Arttech3d/Hormiga/KiCad/Tarjetas/DISEÑO DE PLACA ESP32-S3/S4345803eb856426b9bef19e153e23c18G.webp

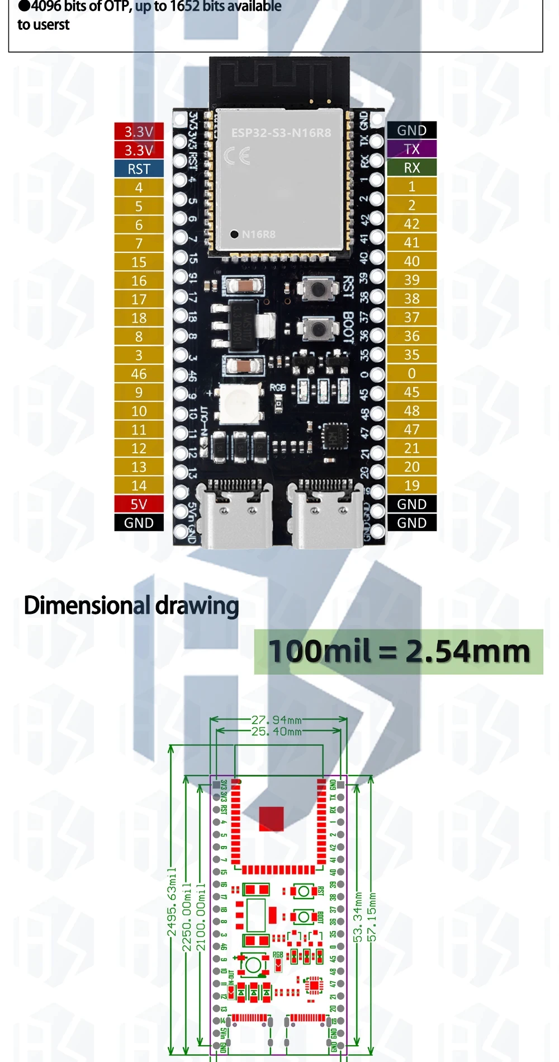
KiCad/Tarjetas/DISEÑO DE PLACA ESP32-S3/S4345803eb856426b9bef19e153e23c18G.webp
