Arttech3d/Hormiga/Material/Datasheet/ESP32-S3-DevKitC-1-Pin-Layout-1024x459.png

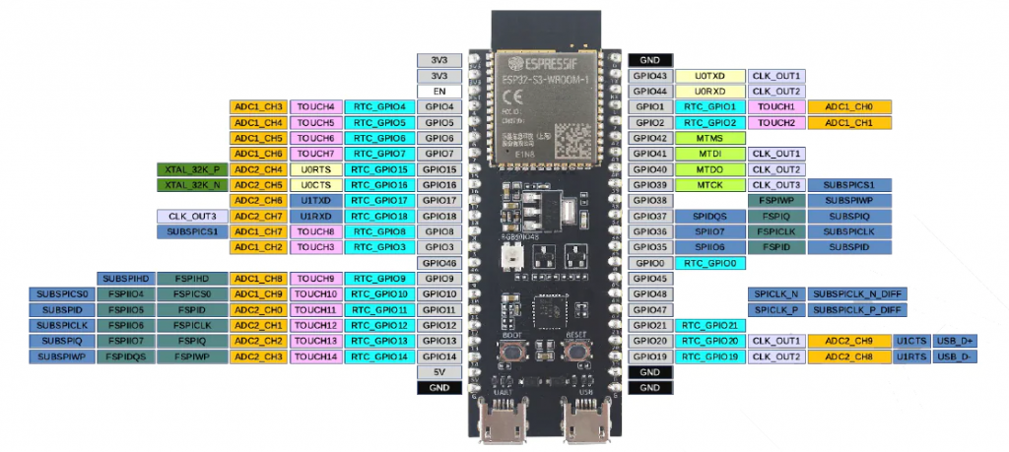
Material/Datasheet/ESP32-S3-DevKitC-1-Pin-Layout-1024x459.png
