Arttech3d/Hormiga/KiCad/Ant ESP32-S3/Fusion360/PCB v1.dxf

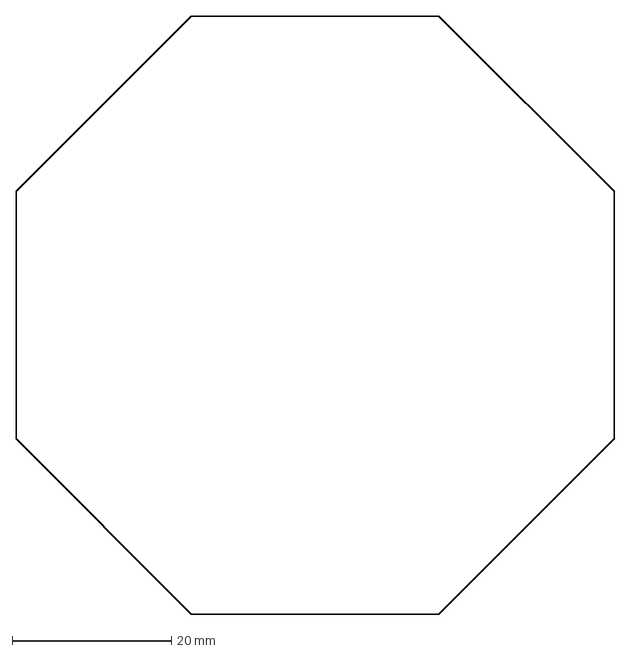
[picture p9: CAD file, 2025-12-20]
KiCad/Ant ESP32-S3/Fusion360/PCB v1.dxf
75.0 x 75.0 mm
