Arttech3d/Hormiga/Modelos 3D para esp8266 y Raspberry pi pico/STL/encoder_shaft.stl

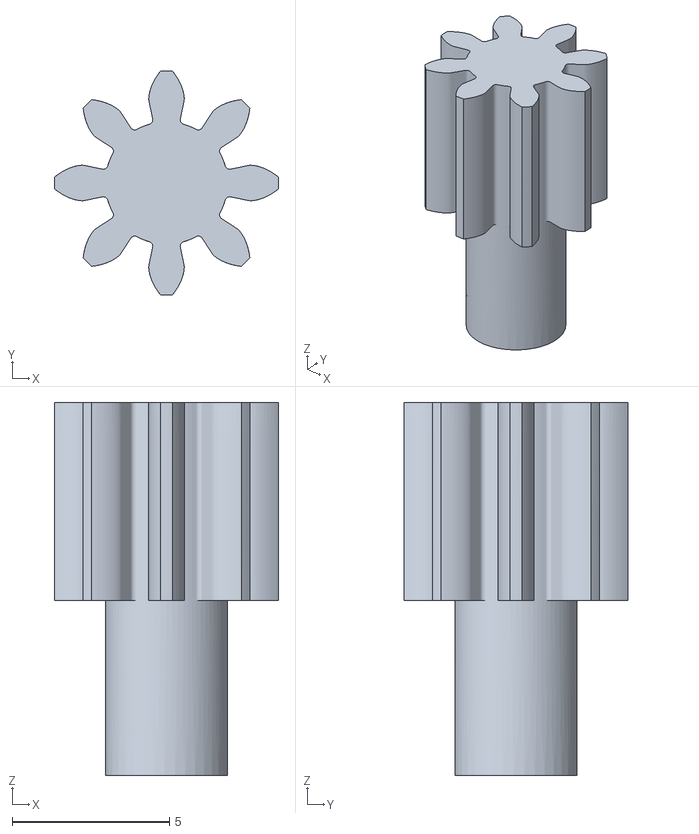
[picture p10: CAD file, 2025-12-20]
Modelos 3D para esp8266 y Raspberry pi pico/STL/encoder_shaft.stl
7.12 x 7.13 x 11.9
