Arttech3d/Hormiga/Modelos 3D para esp8266 y Raspberry pi pico/STL/cover.stl

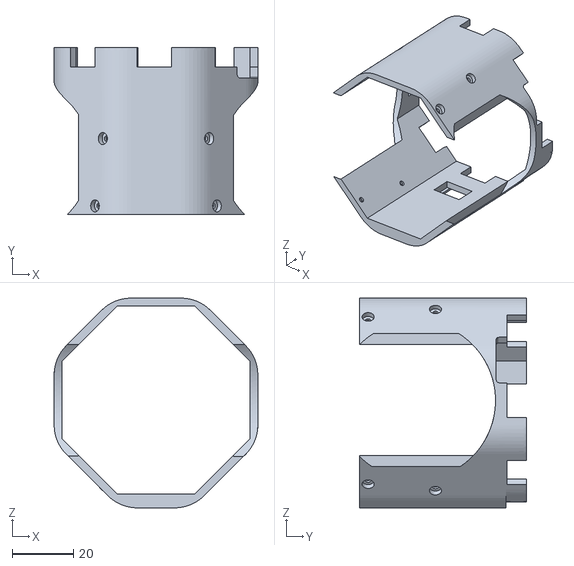
[picture p11: CAD file, 2025-12-20]
Modelos 3D para esp8266 y Raspberry pi pico/STL/cover.stl
66.7 x 54.6 x 68.6
