Arttech3d/Hormiga/Modelos 3D para esp8266 y Raspberry pi pico/STL/wheel (2H).stl

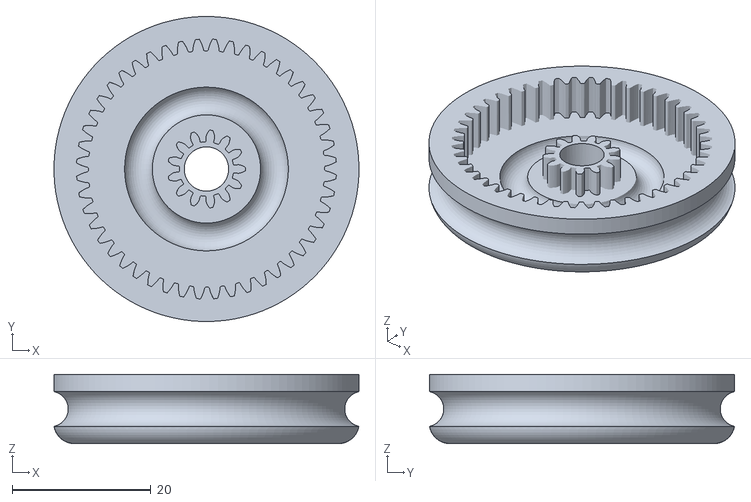
[picture p12: CAD file, 2025-12-20]
Modelos 3D para esp8266 y Raspberry pi pico/STL/wheel (2H).stl
44.0 x 44.0 x 10.0
