Arttech3d/Hormiga/Modelos 3D para esp8266 y Raspberry pi pico/STL/Chassis_a.stl

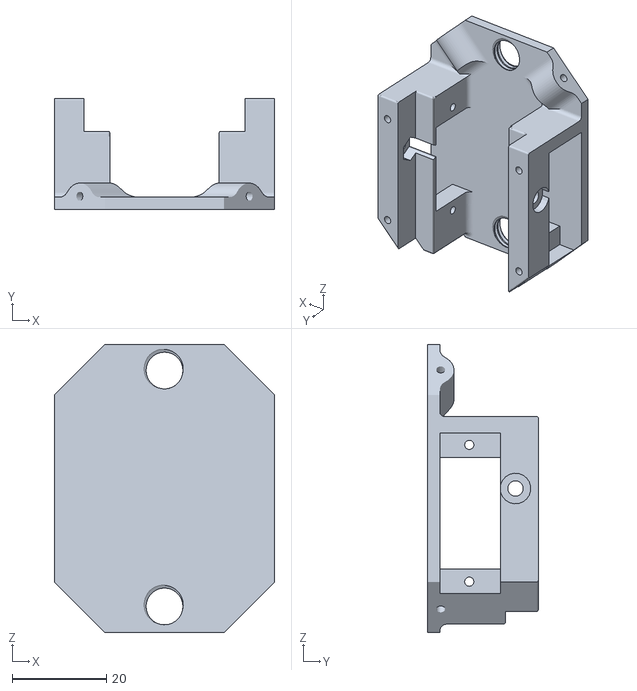
[picture p13: CAD file, 2025-12-20]
Modelos 3D para esp8266 y Raspberry pi pico/STL/Chassis_a.stl
46.6 x 23.5 x 61.0
