Arttech3d/Hormiga/Modelos 3D para esp8266 y Raspberry pi pico/STL/Chassis_b.stl

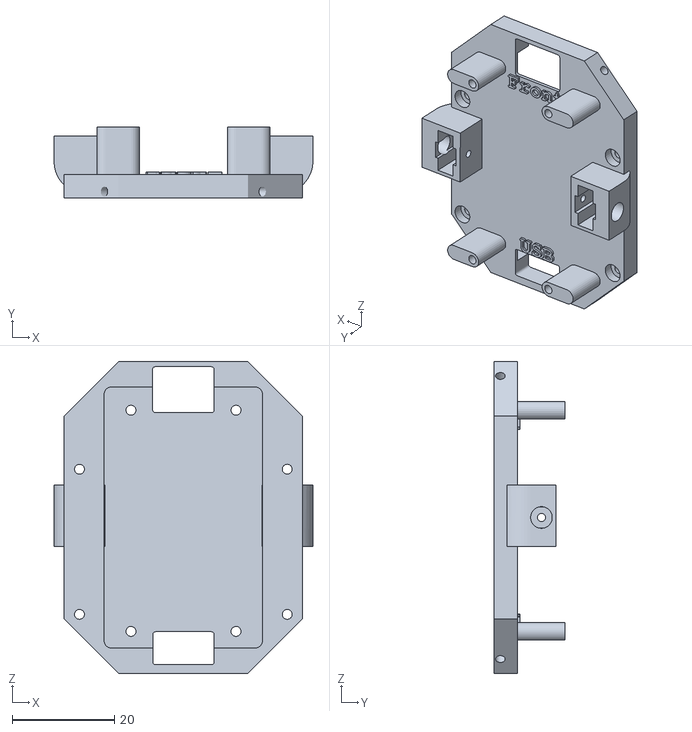
[picture p14: CAD file, 2025-12-20]
Modelos 3D para esp8266 y Raspberry pi pico/STL/Chassis_b.stl
50.6 x 14.0 x 61.0
