Arttech3d/Hormiga/Modelos 3D para esp8266 y Raspberry pi pico/STL/castor_wheel.stl

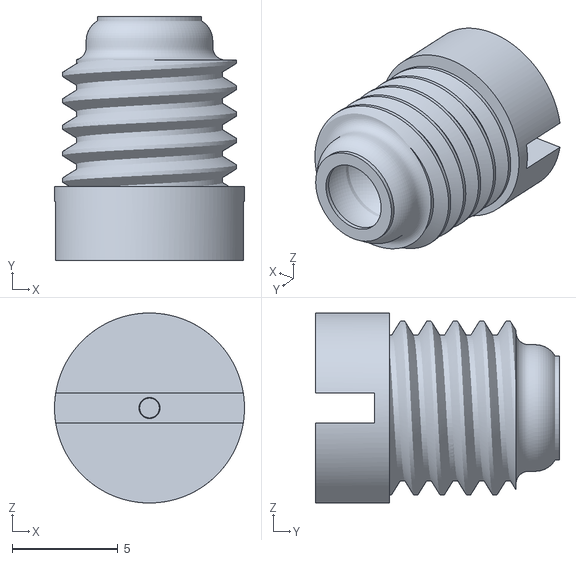
[picture p15: CAD file, 2025-12-20]
Modelos 3D para esp8266 y Raspberry pi pico/STL/castor_wheel.stl
9.00 x 11.6 x 9.00
