Arttech3d/Hormiga/Modelos 3D para esp8266 y Raspberry pi pico/STL/ehat.stl

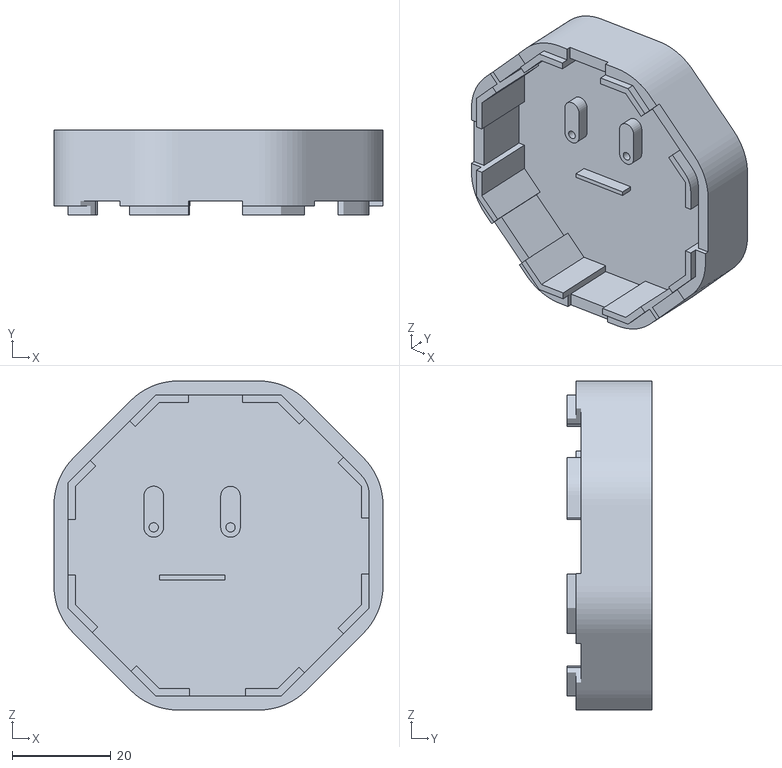
[picture p16: CAD file, 2025-12-20]
Modelos 3D para esp8266 y Raspberry pi pico/STL/ehat.stl
66.6 x 17.1 x 66.6
