Arttech3d/Hormiga/Modelos 3D para esp8266 y Raspberry pi pico/STL/motor_gear.stl

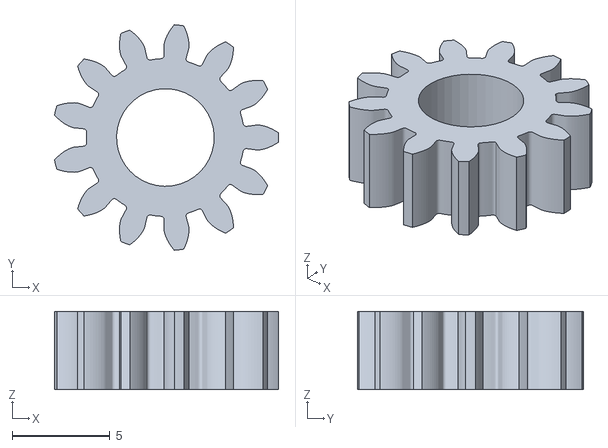
[picture p17: CAD file, 2025-12-20]
Modelos 3D para esp8266 y Raspberry pi pico/STL/motor_gear.stl
11.5 x 11.6 x 4.02
