Arttech3d/Hormiga/Modelos 3D para esp8266 y Raspberry pi pico/STL/soporte de llanta.stl

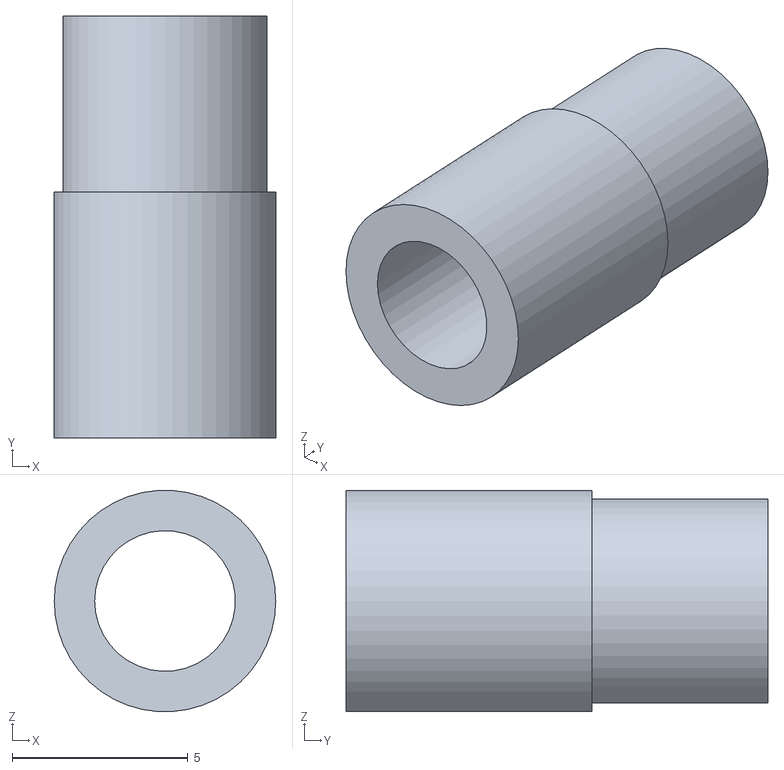
[picture p18: CAD file, 2025-12-20]
Modelos 3D para esp8266 y Raspberry pi pico/STL/soporte de llanta.stl
6.30 x 12.0 x 6.29
