Arttech3d/Hormiga/(list of files, cad)

Other CAD files:
KiCad/Ant ESP32-S3/Fusion360/PCB v4.dwg
KiCad/Tarjetas/KiCad-RP-Pico-main/SketchUp Model/Pico.skp
Modelos 3D para esp8266 y Raspberry pi pico/Ipt/Soporte de llanta.ipt
Modelos 3D para esp8266 y Raspberry pi pico/Ipt/cover.ipt
Modelos 3D para esp8266 y Raspberry pi pico/Ipt/ehat.ipt
Modelos 3D para esp8266 y Raspberry pi pico/Ipt/motor_gear.ipt
