Arttech3d/Hormiga/Material/Manual.pdf

DESARROLLO

El desarrollo de este proyecto se basa en la creación de un manual que

contenga los pasos necesarios para poder arman un robot, desde cómo soldar

componentes electrónicos hasta como cargarle códigos ar robot.

## Contenido

RESULTADOS

### 4.1 Lista de materiales

En el siguiente listado se muestran algunas especificaciones, nombre del

componente y donde es que de sebe colocar. Las resistencias tienen cierta

nomenclatura la cual el último número indica la cantidad de ceros (Ejemplo:

472=4700 R. Los componentes se pueden comprar en AliExpress.com.

Lista de materiales

Part Name | Device | Imagen | Package | Cantidad
| | Componentes soldados a la PCB
R0, R1, R2, R3, R4, R5, R6, R7, R8 | Resistencia 472 | SMD R0805 | 9
R9, R15 | Resistencia 000 | SMD R0805 | 2
R10 | Resistencia 180 | SMD R0805 | 1
R12 | Resistencia 102 | SMD R0805 | 1
R13 | Resistencia 101 | SMD R0806 | 1

R14

Resistencia

121

SMD R0807
1
C3, C4 | Capacitor 10 uF | SMD C0603 | 2
C1, C2 | Capacitor 100pF | SMD C0603 | 2
LED0, LED1 | LED WS2812B | SMD 5050 | 2
IRLML2502 | Mosfet IRLML2502 | SOT23 | 1
Mux | Mux CD4051 | SOIC-16 | 1
P0,P1,P2,P3,P4, | IR TCRT5000L | TCRT5000L | 8
STDBY | LED SML 0805 Verde | SMD SML0805 | 1
STDBY | LED SML 0805 Rojo | SMD SML0805 | 1
TP4056 | TP4056 | SOP-8 | 1
SWITCH | Interruptor SS12F23 | SS12F23 | 1

BATT0, BATT1

Conector JST-

PH-2

JST-PH-2
2
12C|UART | Conectores hembra 1x4 | PH | 1
E_LEFT, E_RIGHT, M_LEFT, M_RIGHT | Conector macho de 1x3 pines | PH | 4

Módulos integrados

ESP-12E | ESP-12 NodeMCU CP2102 | Enchufe | 1
MT3608 | Módulo MT3608 Step-up | Cable | 1
IMU | Modulo MPU6050/GY-521 | Enchufe | 1
TP4056 | Módulo de cargaTP4056 | Cable | 1
batería | 3.7 v 1800 mAh LIPO baterry | 103450 | 1
Encoder | Rotary Encoder 48 PPR | 9MM | 2

Chassis

Chasis | Filamento | PLA | 1
Rueda | Junta de goma | OD48CS5 | 2
Rodamiento | Bearing 623zz | 3x10x4mm | 2
Rueda giratoria | Balines de aceo | Diámetro de 4mm | 2
Fijación de ruedas | Perno M3x20 mm con tuerca y arandela de presión | M3 | 2
Fijación del chasis | Tornillos autoroscantes M2.5 x 10mm | M2.5 | 16
Eje del engranaje del piñón | Remaches de aluminio estándar | Se requiere para el mandril del remache | 2
Servomotores | SG90 | SG90 360 | 2

Tabla 1 Lista de materiales.

### 4.2 Como descargar el repositorio de Github

Paso 1: Buscar el proyecto

Abrir el buscador y colocar el siguiente link

https://github.com/Arttech3d/Hormiga (Ilustración 1).

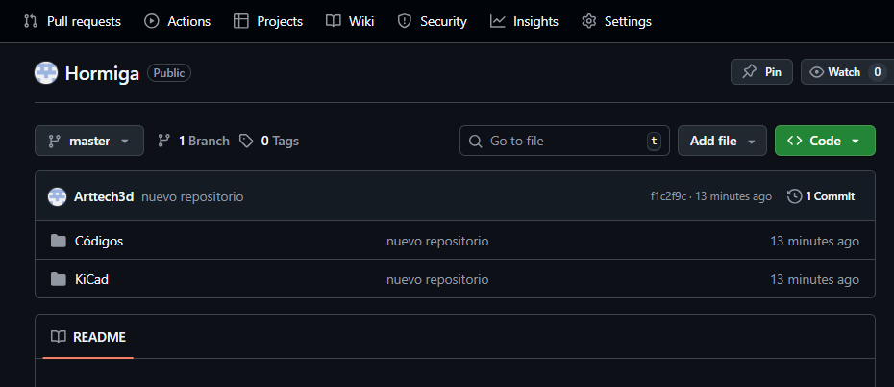
[picture p32: figure]

Ilustración 1 Proyecto en Github.

Paso 2: Descomprimir archivo .ZIP (Ilustración 2).

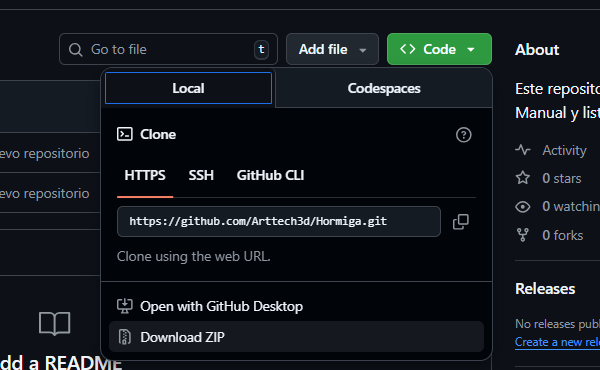
[picture p33: figure]

Ilustración 2 Descargar .zip

### 4.3 Como realizar un pedido de PCB

En este paso cargaremos los Gerbers en la página de JLCPCB.

parámetros a considerar:

- Cobre terminado >= 1 oz
- Tamaño mínimo del orificio: 0,3 mm
- Distancia mínima entre pistas/espaciado: 6/6 mil

Paso 1: Ir a la página de JLCPCB y pulsamos en “Instant Quote” (Ilustración3).

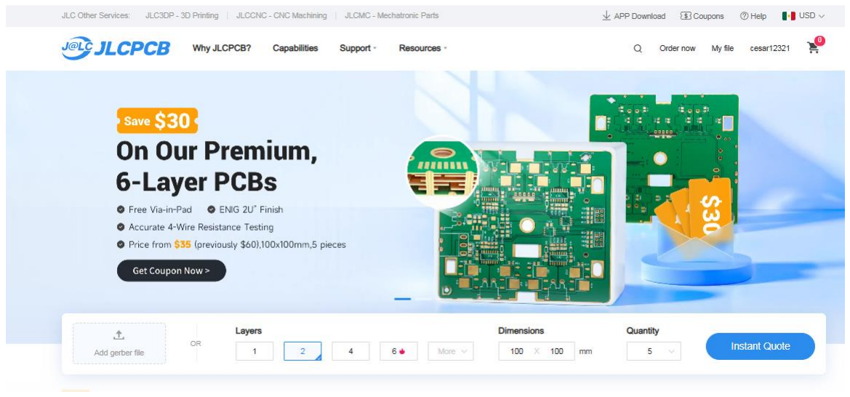
[picture p34: figure]

Ilustración 3 Pagina JLCPCB.

Paso 2: Pulsamos en añadir Gerber (Ilustración 4).

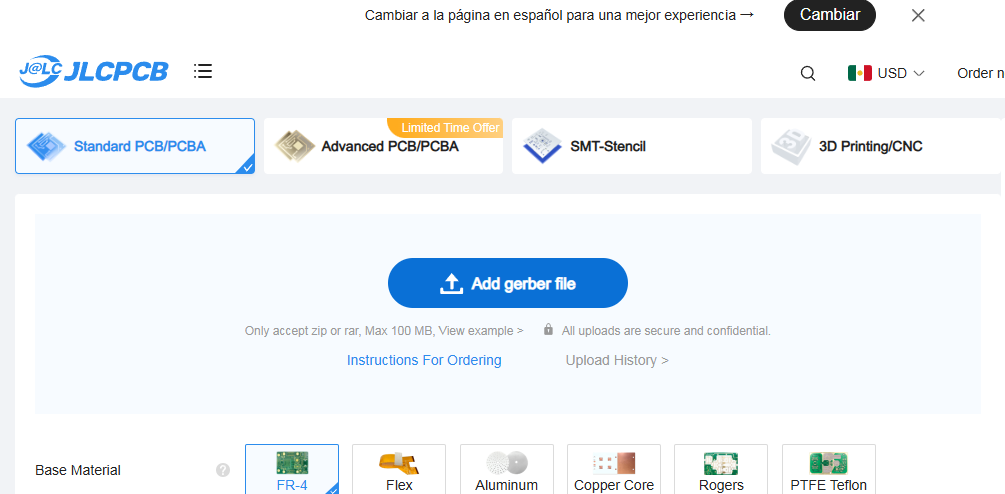
[picture p35: figure]

Ilustración 4 Pagina JLCPCB.

Paso 3: Seleccionamos el archive.zip que se encuentra en la siguiente

dirección: KiCad > Ant ESP8266.zip > Gerber >GerberESP8266.zip (Ilustración

5).

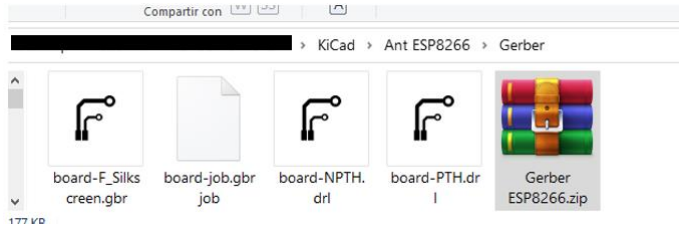
[picture p36: figure]

Ilustración 5 Archivo Gerber ESP8266.zip.

Paso 4: Se verá lo siguiente (Ilustración 6).

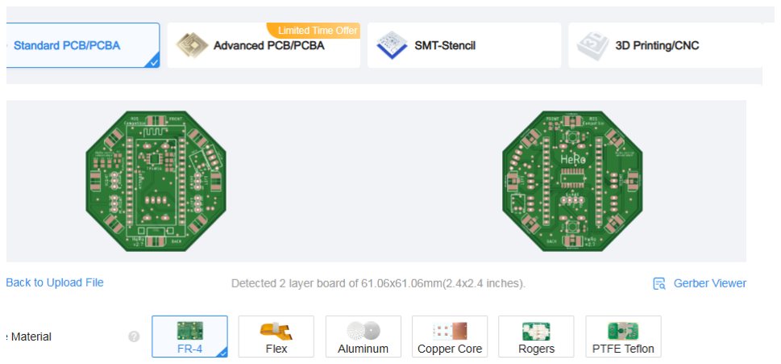
[picture p37: figure]

Ilustración 6 Proyecto abierto en JLCPCB.

Paso 5: Configurar los parámetros de la placa. Se dejarán todos los

parámetros iguales a excepción del color el cual será blanco para una

mayor reflectancia de la luz para los sensores ópticos y en cantidad

dependerá de cuantas se quieran (Ilustración 7).

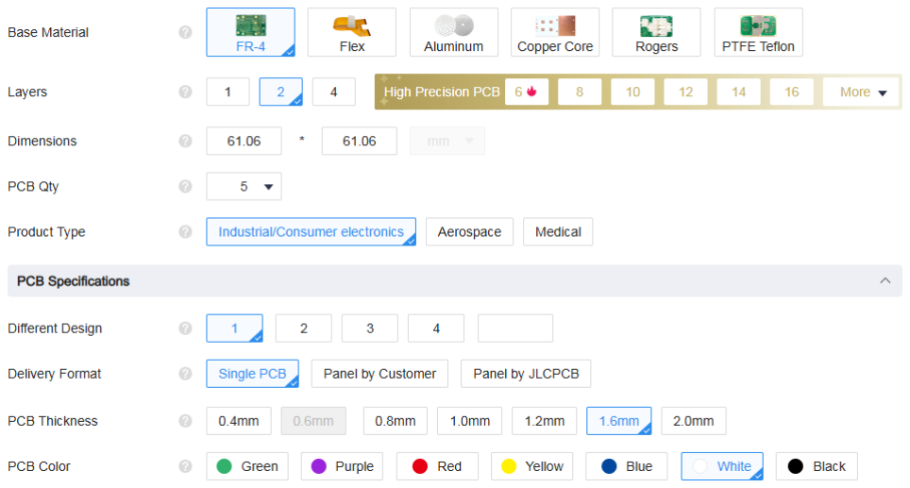
[picture p38: figure]

Ilustración 7 Parámetros 1.

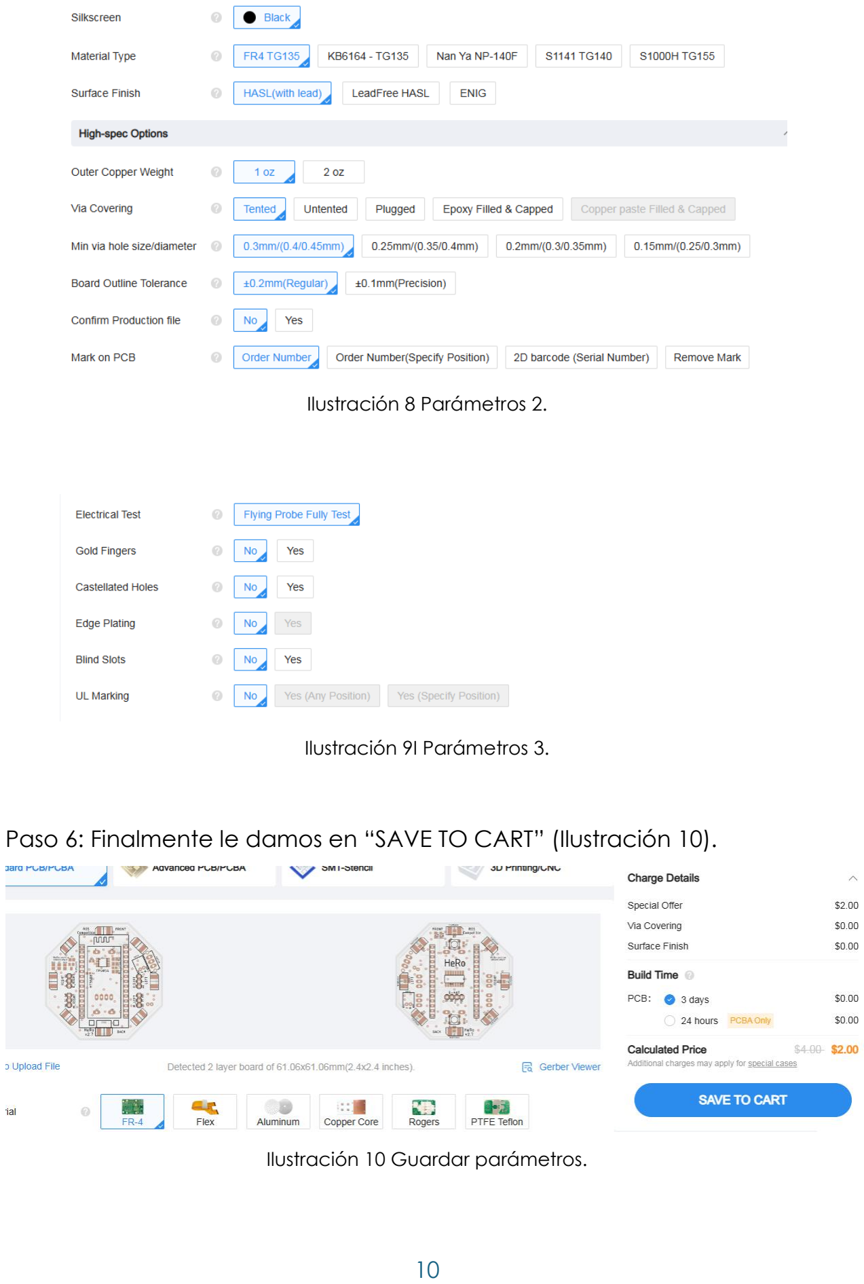
[picture p39: page 10]

Ilustración 8 Parámetros 2.

Ilustración 9I Parámetros 3.

Paso 6: Finalmente le damos en “SAVE TO CART” (Ilustración 10).

Ilustración 10 Guardar parámetros.

### 4.4 Como soldar componentes

En esta sección se explicará como ubicar y como soldar correctamente los

componentes electrónicos SMD. Cabe mencionar que el componente R11

no será soldados.

Paso 1: Ubicar componentes electrónicos en la PCB.

Para poder ubicar los componentes de la lista de materiales, se debe buscar

el nombre de la parte y su posición correspondiente en la PCB, como se

muestra en la Ilustración 11.

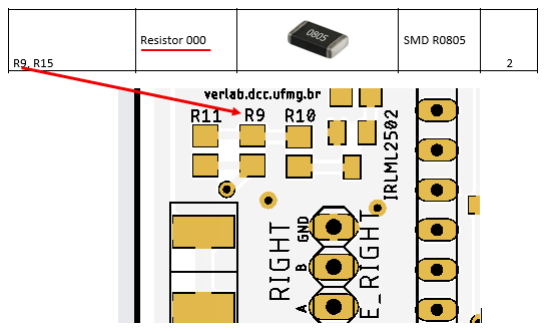
[picture p40: figure]

Ilustración 11 Como ubicar componentes.

Paso 2: Ajustar la temperatura del Cautín.

En este caso se utilizó una estación de soldadura Weller WES51, la cual

permite variar su temperatura por medio de una perilla analogía en el rango

de 35°F a 85 °F X 10, esto significa que, si el indicador está en 70°F, este se

multiplica X10 y su valor real sería 700°F, equivalente a 370°C, una

temperatura adecuada para soldar (Ilustración 12).

Conversión: 32°F =1°C

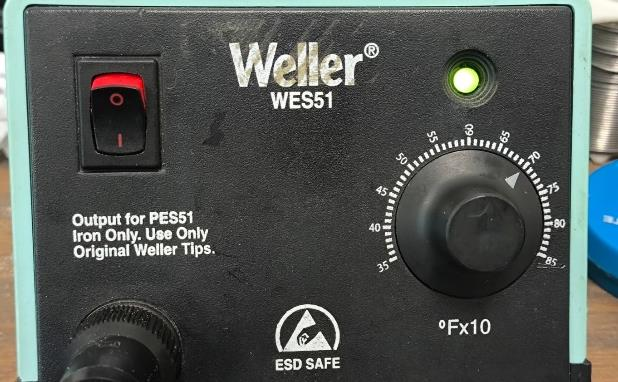
[picture p41: figure]

Ilustración 12 Perilla de ajuste de temperatura.

El cautín debe de contar un soporte para una mayor seguridad y una fibra

de acero, cobre o en nuestro caso una esponja húmeda la cual nos servirá

para limpiar la punta del cautín (Ilustración 13).

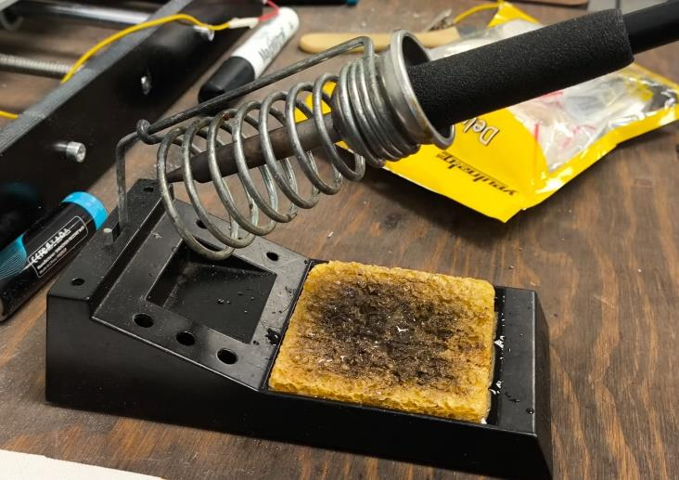
[picture p42: figure]

Ilustración 13 Cautín.

Paso 3: Acomodar la PCB

La PCB se debe colocar en una superficie plana, preferentemente en una

tabla corte para evitar daños y facilitar en proceso (Ilustración 14).

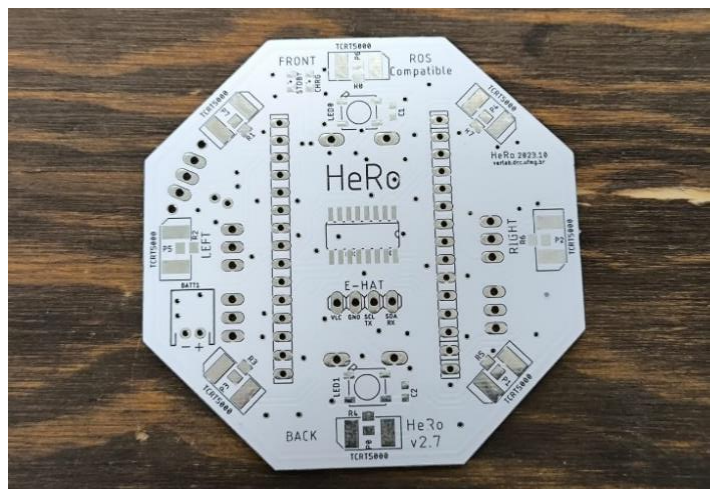
[picture p43: figure]

Ilustración 14 Placa PCB.

Paso 4: Aplicar pasta para soldar

Se aplicará una pequeña cantidad de pasta para soldar en la ubicación de

la pieza, esto le ayudará a mantenerse fija y mejorará a adherencia del

estaño (Ilustración 15).

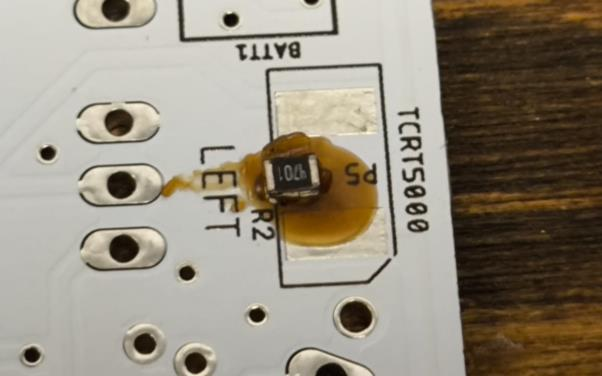
[picture p44: figure]

Ilustración 15 Aplicación de pasta.

Paso 5: Aplicar estaño

Se aplicará una pequeña cantidad de estaño en la punta del Cautín. Si el

estaño no se adhiere correctamente introduzca la punta del Cautín en la

pasta para soldar para que tenga mejor adherencia (Ilustración 16).

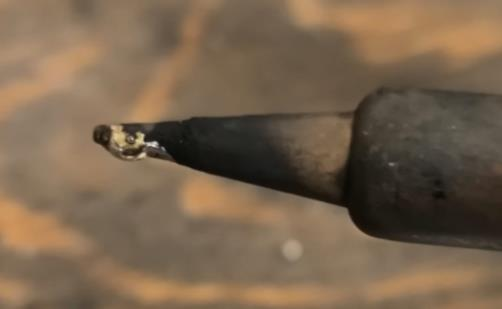
[picture p45: figure]

Ilustración 16 Estaño en la punta del cautín.

Paso 6: Sostener componente

Con unas pinzas, sostener el componente y rápidamente soldar con el

cautín, no se debe dejar mucho tiempo ya que el componente se podría

quemar (Ilustración 17).

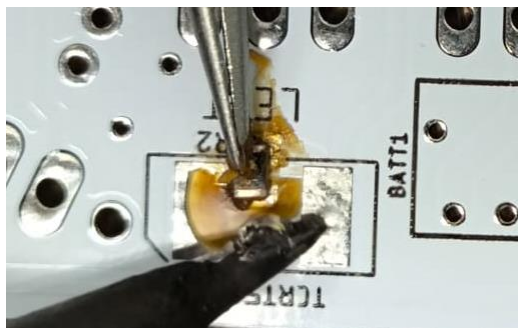
[picture p46: figure]

Ilustración 17 Sostener componente.

Debe verse de la siguiente manera (Ilustración 18).

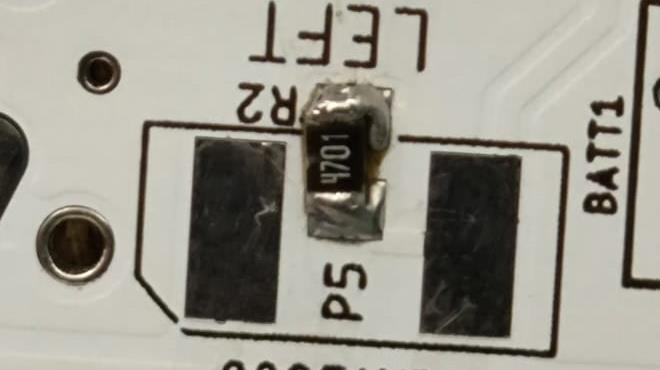
[picture p47: figure]

Ilustración 18 Componente soldado

Se debe realizar esta acción con todos los componentes SMD y pines, el

elevador de voltaje MT3608 se soldará al final ya que primero se bebe

ajustar, a continuación, en la Ilustración 40 se muestran los componentes ya

soldados.

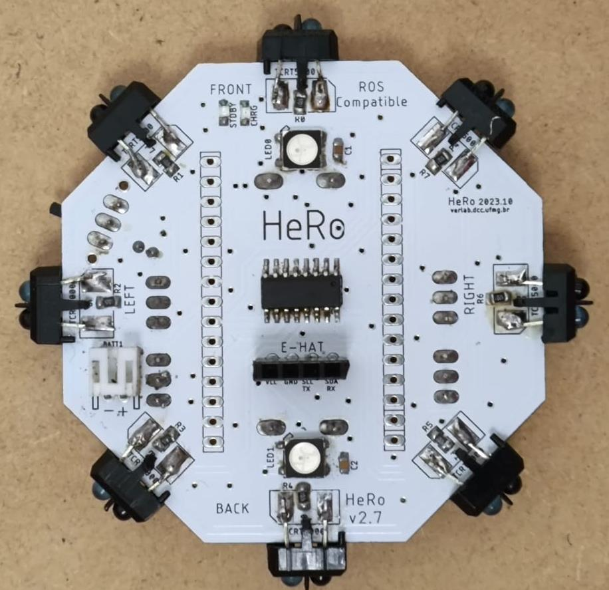
[picture p48: figure]

Ilustración 19 Componentes soldados.

### 4.5 Regular voltaje del módulo LM2596

Materiales:

- Fuente de 3.7v
- Multímetro
- 4 caimanes
- Destornillador plano (Chico)

Paso 1: Conexión del módulo LM2596

La fuente estará conectará a VIN+ y VIN- y el multímetro a VOUT+ y VOUT-.

El acomodo se representa en la Ilustración 20.

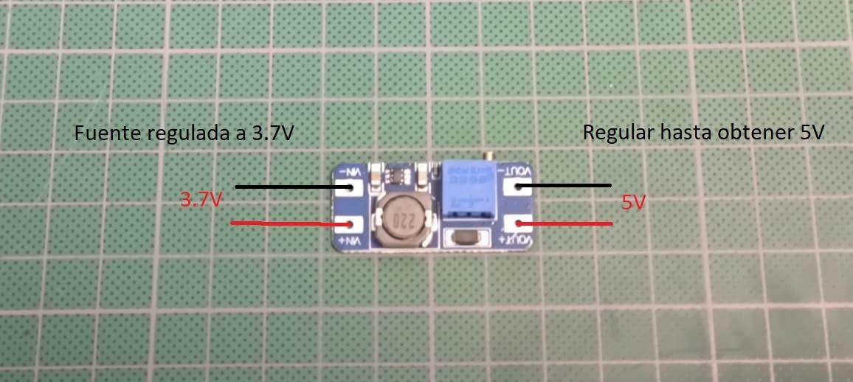
[picture p49: figure]

Ilustración 20 Acomodo de componentes

Paso 7.1: Ajustar el elevador de voltaje

Con ayuda del destornillador plano girar en sentido horario como se muestra

en la Ilustración 21, hasta que el multímetro marque 5V.

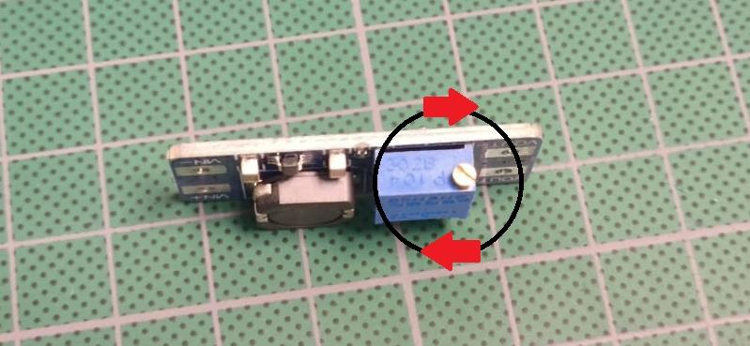
[picture p50: figure]

Ilustración 21 Regular voltaje

Paso 7.2: Soldarle 4 pines.

De acuerdo con el diagrama de acomodo en la PCB colocar los pines y el

módulo sin soldar, esto para asegurar que encajen correctamente y al

momento de soldar queden bien (Ilustración 22).

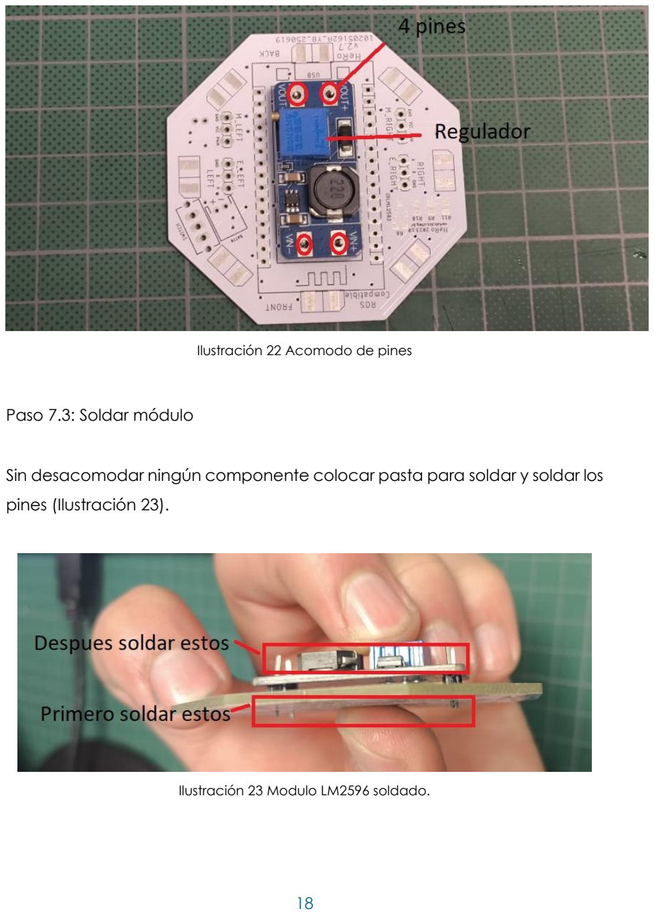
[picture p51: page 18]

Ilustración 22 Acomodo de pines

Paso 7.3: Soldar módulo

Sin desacomodar ningún componente colocar pasta para soldar y soldar los

pines (Ilustración 23).

Ilustración 23 Modulo LM2596 soldado.

### 4.6 Parámetros de impresión 3D

El robot cuenta con 14 piezas las cuales se imprimirán utilizando filamento

PLA, un material resistente y de bajo costo. Se recomienda que las piezas se

impriman por separado para que no haya errores, es posible que se requiera

de alguna lija fina para lijar algunos agujeros o superficies debido a que las

impresoras 3D pueden presentar variaciones en la precisión de impresión.

Parámetros de impresión

Archivo | Perfil de capa | Relleno | Soporte | Cantidad | Imagen | Notas
chassis_a.stl | 0.3 | 20% | Sí | 1 | | Sección A del chasis principal
chassis_b.stl | 0.3 | 20% | No | 1 | | Sección B del chasis principal
wheel.stl | 0.3 | 20% | Sí | 2 | | Rueda principal
Acastor_wheel.stl | 0.2 | 100% | No | 2 | | Rueda loca (maciza)
Engrane_Motor.stl | 0.2 | 100% | No | 2 | | Engrane del motor
encoder_gear.stl | 0.2 | 100% | No | 2 | | Engrane del codificador
Soporte de llanta.stl | 0.2 | 100% | No | 2 | | Soporte de llanta
cover.stl | 0.3 | 20% | Sí | 1 | | Cubierta superior

ehat.stl | 0.3 | 20% | No | 1

Tapa

estructural

Ilustración 24 parámetros de impresión 3D

### 4.7 Ensamble

Paso 1: Imprimir piezas y preparar herramientas

Herramientas:

- Destornillador plano
- Destornillador de cruz
- Cinta
- Pinzas
- KolaLoka
- Llave Allen de 3mm

En la Ilustración 25 se muestran las piezas y herramientas necesarias

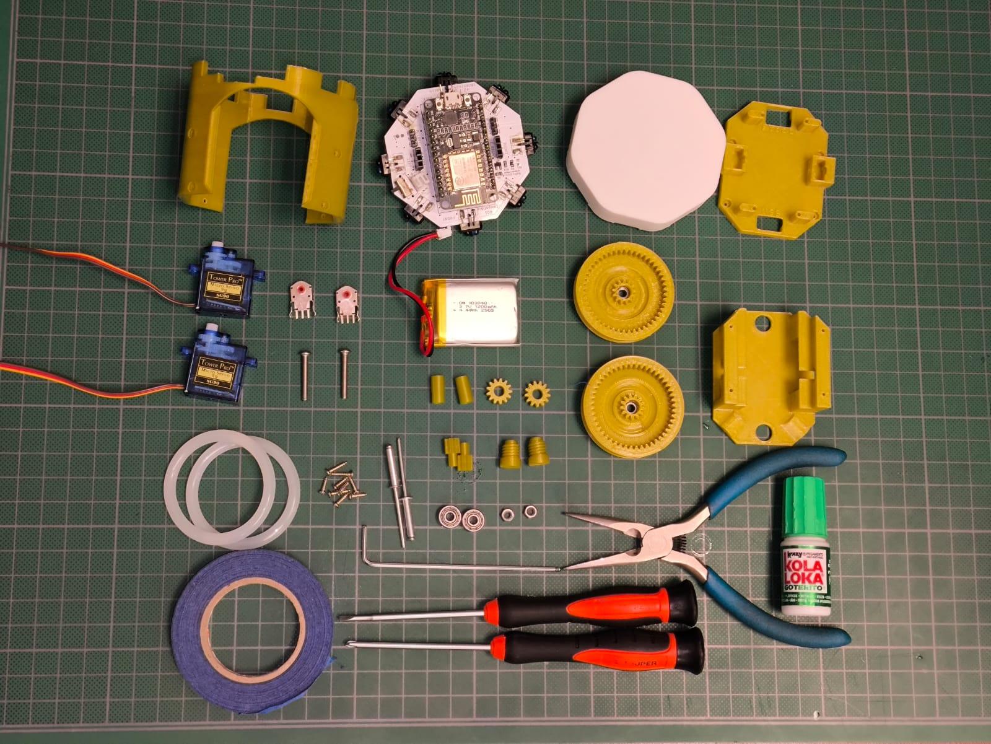
[picture p52: figure]

Ilustración 25 Piezas y herramientas.

Paso 2: Colocar engranes

Realizar presión al colocar los engranes en los servomotores (Ilustración 26).

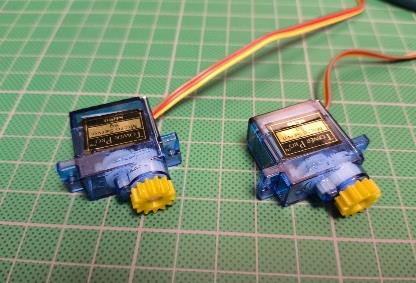
[picture p53: figure]

Ilustración 26 Servomotores.

Paso 3: Colocar los servomotores

Se colocarán los servomotores de la siguiente manera en el chasis a y se

atornillarán (Ilustración 27).

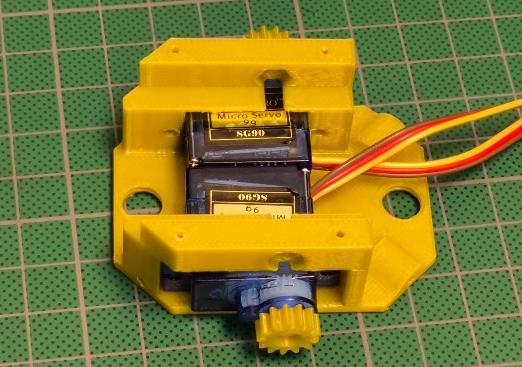
[picture p54: figure]

Ilustración 27 Engranes en servomotores.

Paso 4: Pegar soportes de llanta

Pegar con kolaloka el soporte de sostendrá la llanta tratando que queden

lo más recto posible (Ilustración 28).

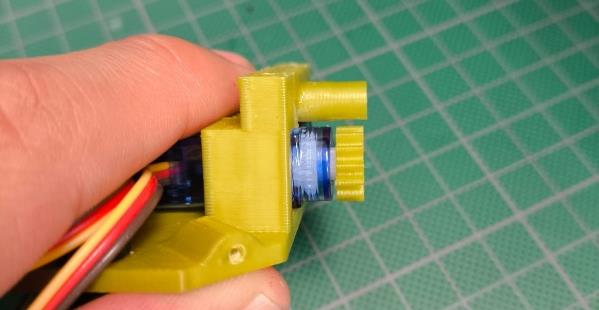
[picture p55: figure]

Ilustración 28 Colocación de soporte de llanta.

Paso 5: Rueda loca

Colocar un balín de metal en la cavidad del tornillo. Posteriormente con

ayuda de unas pinzas presionar los costados para que se fije el balín

(Ilustración 29).

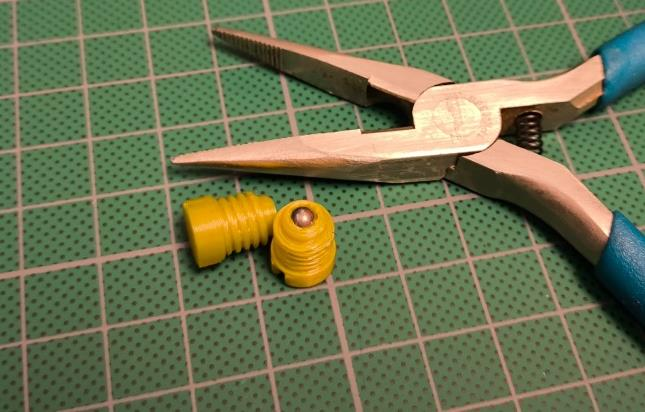
[picture p56: figure]

Ilustración 29 Colocación de balín.

Paso 6: Colocar tuercas

Se colocarán las turcas en los agujeros internos del chasis a y los fijaremos

con KolaLoka (Ilustración 30).

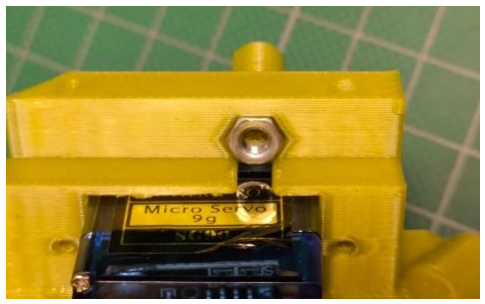
[picture p57: figure]

Ilustración 30 Colocación de tuerca.

Paso 7: Colocar batería

La batería se colocará encima de los servos y el cable de alimentación

debe de quedar orientado con los cables de los servos (Ilustración 31).

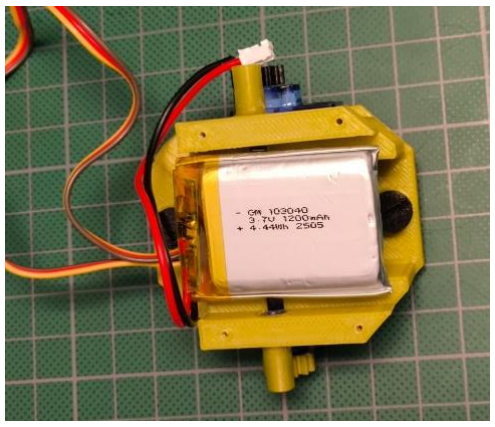
[picture p58: figure]

Ilustración 31 Colocación de batería.

Paso 8: Atornillar chases b

Se atornillará el chasis B con 4 Tornillos M2,5 x 10 mm y se deberán sacar los

cables de la batería y de los servos por el orificio (Ilustración 32).

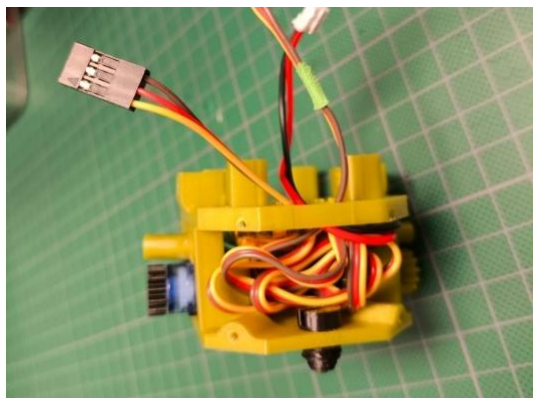
[picture p59: figure]

Ilustración 32 Atornillas chasis.

Paso 9: Engrane de encoders

Se cortarán las puntas de los remaches con las pinzas y se insertarán en el

engrane del encoder y se fijara con kolaLoka (Ilustración 33).

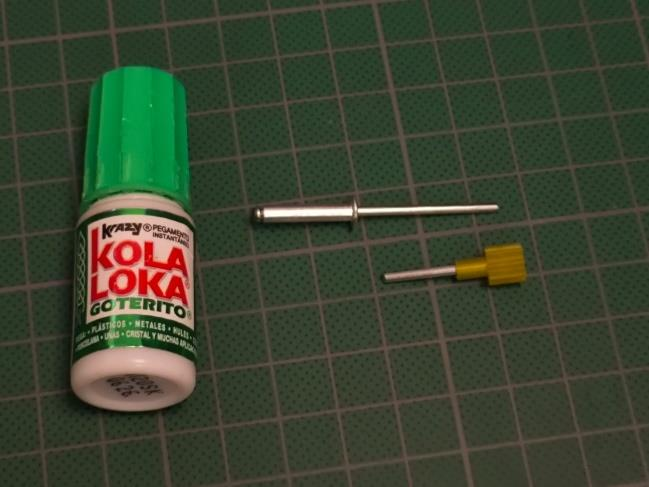
[picture p60: figure]

Ilustración 33 Encoder completo.

Se colocará algo de KolaLoka a lo largo del remache y posteriormente se

lijará un poco. Esto se hace para que el remache tenga un buen contacto

con el encoder (Ilustración 34).

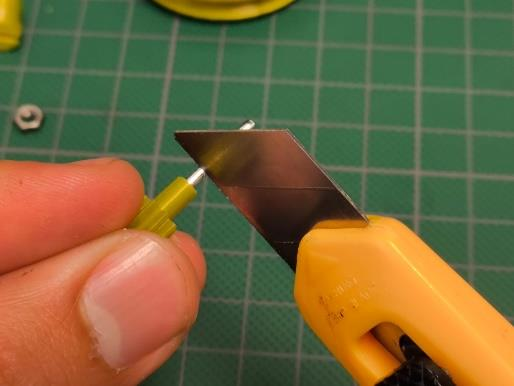
[picture p61: figure]

Ilustración 34 Raspar excedente de kolaloka.

Paso 10: Colocar encoders

Colocar el encoder en el hueco del Chasis B, los pines del encoder deben

apuntas hacia adentro como se muestra en la imagen (Ilustración 35).

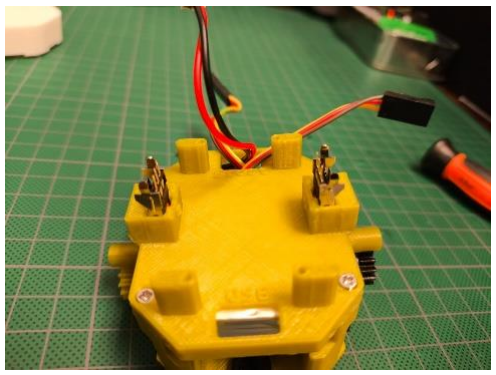
[picture p62: figure]

Ilustración 35 Colocación de encoders.

Paso 11: Insertar el engrane al encoder

Insertar el engrame en el orificio del enconder y asegurar que gire (Ilustración

36).

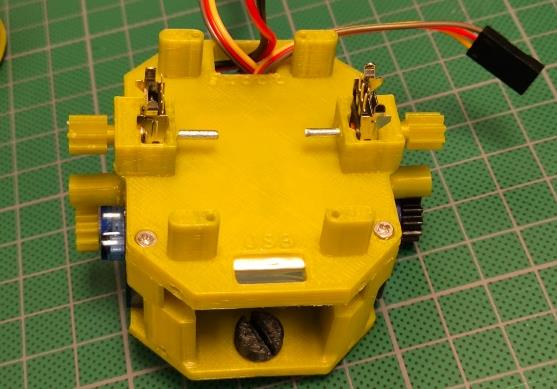
[picture p63: figure]

Ilustración 36 Insertar remaches en encoders.

Paso 12: Cover

El Cover se colocará de tal manera que el puerto USB coincida con la

indicación del puerto USB del chasis B (Ilustración 37).

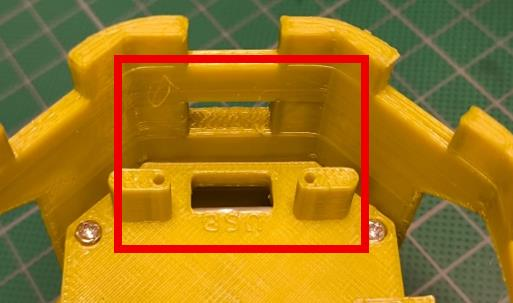
[picture p64: figure]

Ilustración 37 Orientación de Cover.

Atornillar el chasis, se utilizarán 8 Tornillo M2,5 x 10 mm (Ilustración 38).

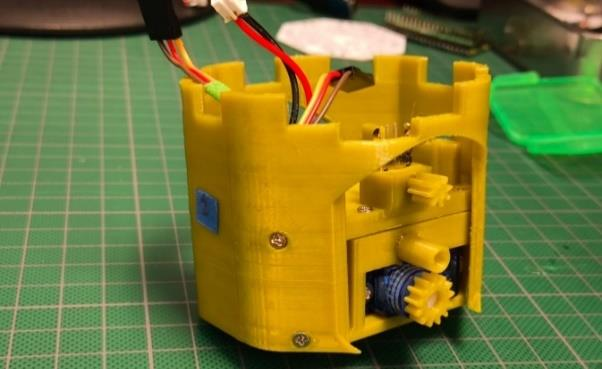
[picture p65: figure]

Ilustración 38 Atornillar chasis.

Paso 13: Colocar PCB

Verificar la orientación de la PCB donde coincida el puerto micro USB con el

Cover y con la indicación del chasis B (Ilustración 39).

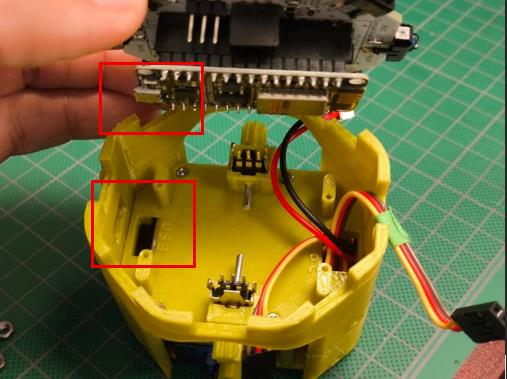
[picture p66: figure]

Ilustración 39 Colocación de PCB.

Paso 14: Conectar batería a PCB

Conectar la batería al puerto de carga de la PCB (Ilustración 40).

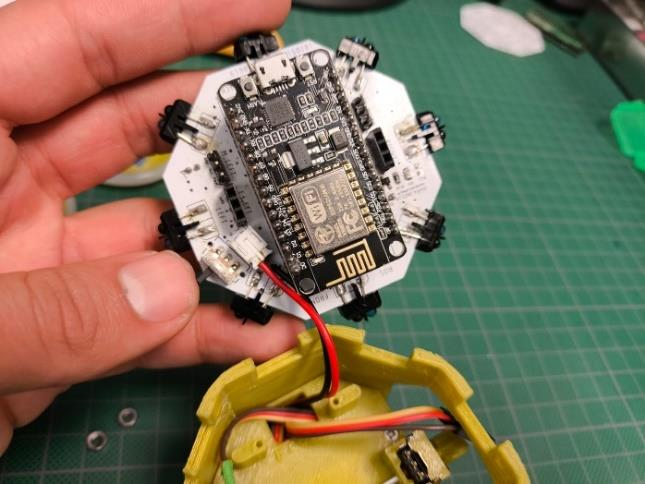
[picture p67: figure]

Ilustración 40 Colocación de la batería a la PCB.

Paso 15: Conectar los servomotores a la PCB

Conectar los servomotores a la PCB tomando en cuenta cual es el derecho

e izquierdo y orientación y las indicaciones de la placa (Ilustración 41).

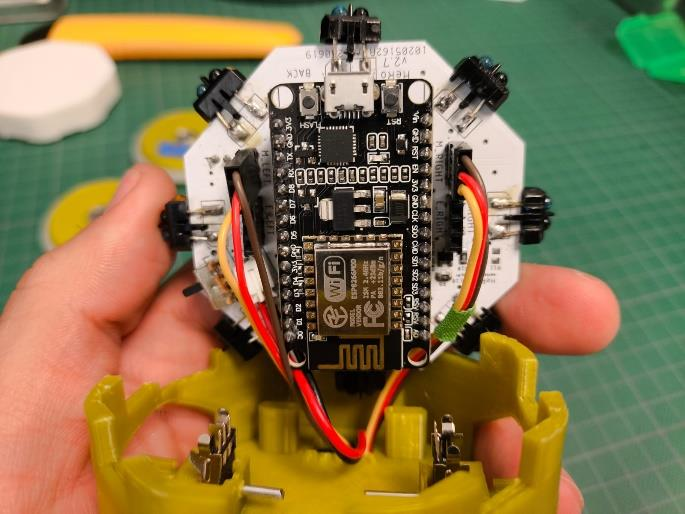
[picture p68: figure]

Ilustración 41 Conexión de servos a la PCB.

Paso 16: Ensamblar PCB

Presionar lentamente la PCB para que llegue al fondo y checando que los

enconder encajen (Ilustración 42).

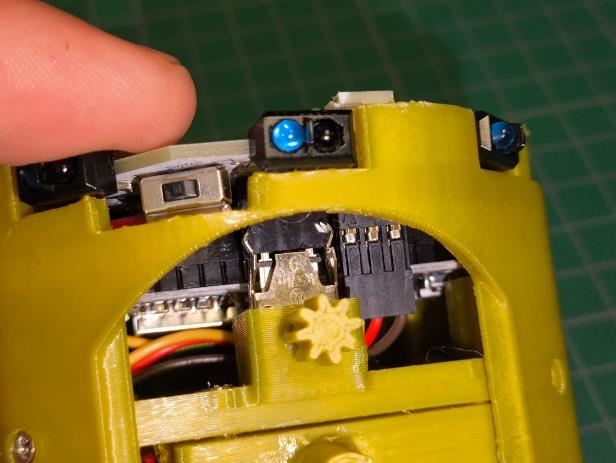
[picture p69: figure]

Ilustración 42 Ensamble de PCB.

Paso 17: Rueda motriz

Se colocarán las gomas a las llantas (Ilustración 43).

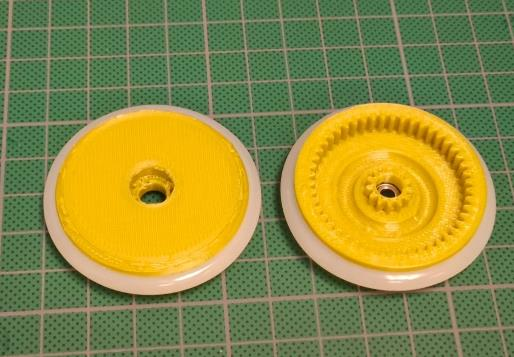
[picture p70: figure]

Ilustración 43 Colocación de goma en rin.

Paso 18: Colocar rodamientos.

Colocar los rodamientos en los agujeros de las llantas, si estas no encajan

lijar un poco los orificios, después utilizar un martillo para fijar los rodamientos

(Ilustración 44).

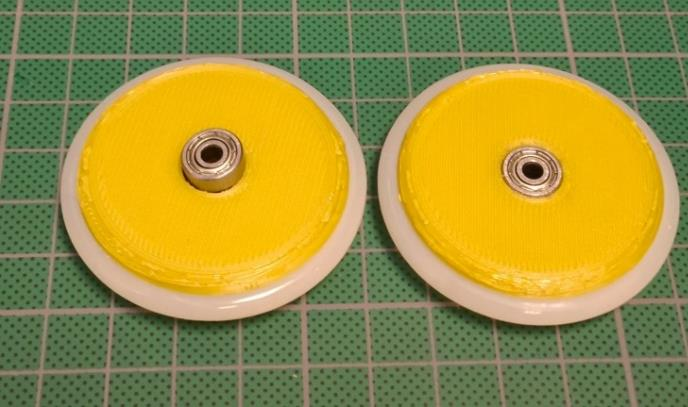
[picture p71: figure]

Ilustración 44 Colocación de rodamientos.

Paso 19: Atornillar llantas

Colocar el tornillo M3 en el orificio de la llanta y atornillarla (Ilustración 45).

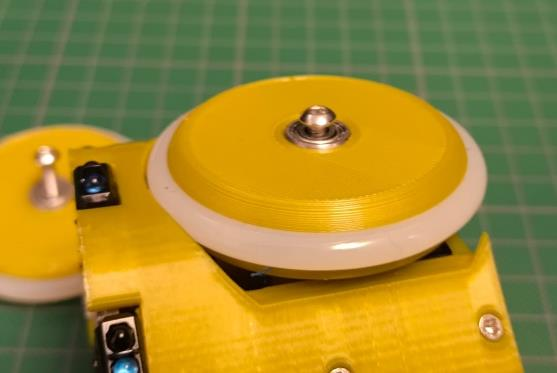
[picture p72: figure]

Ilustración 45 Colocación de llantas en el chasis.

Paso 20: Atornillar el módulo MU a la cabeza

Se utilizarán dos Tornillos M2.5 x 10mm y se orientara como en la imagen

siguiente (Ilustración 46).

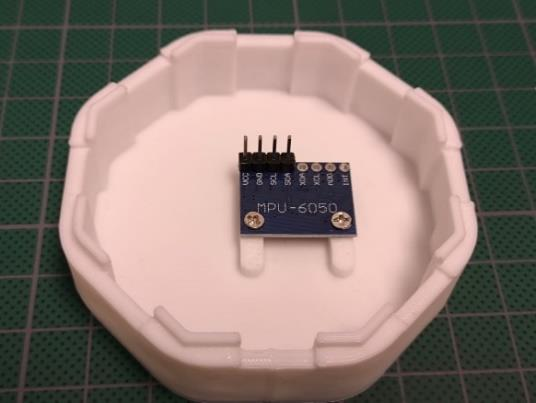
[picture p73: figure]

Ilustración 46 Colocación de MPU en la cabeza de robot.

Paso 21: Ensamblar cabeza al cuerpo.

Una de las patas de la cabeza es diferente a las demás, esa es la que está

orientada al switch (Ilustración 47).

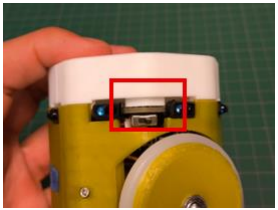
[picture p74: figure]

Ilustración 47 Ensamble de cabeza con el chasis.

Después ha haber realizado tolos los pasos anteriores el robot deberá verse

de la siguiente manera (Ilustración 48).

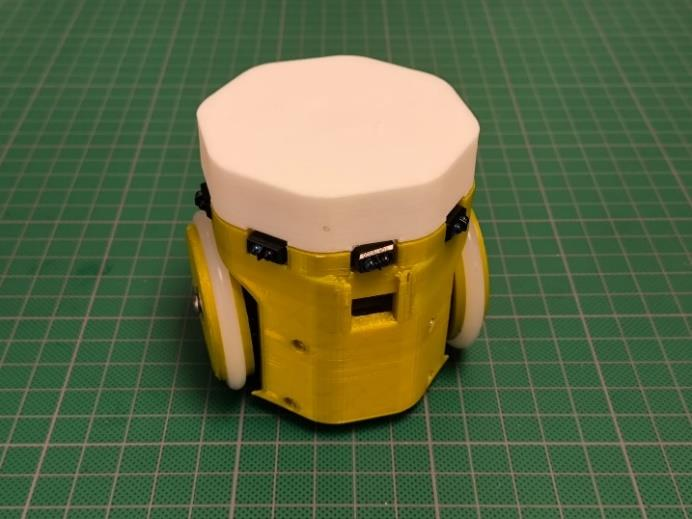
[picture p75: figure]

Ilustración 48 Robot completamente ensamblado.

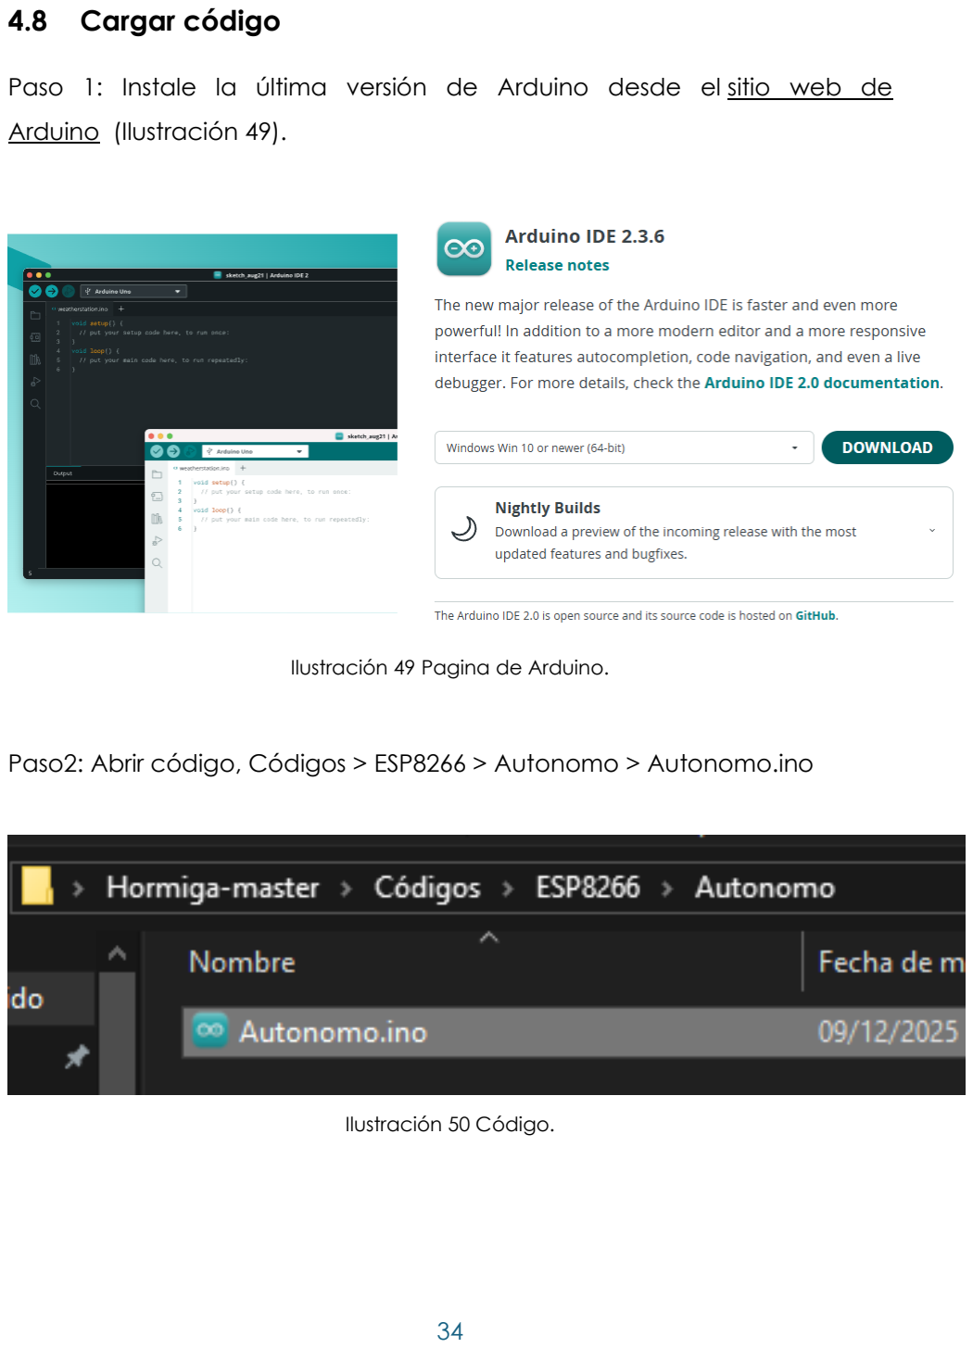
[picture p76: page 34]

### 4.8 Cargar código

Paso 1: Instale la última versión de Arduino desde el sitio web de

Arduino (https://translate.google.com/website?sl=en&tl=es&hl=es&client=srp&u=https://www.arduino.cc/en/Main/Software) (Ilustración 49).

Ilustración 49 Pagina de Arduino.

Paso2: Abrir código, Códigos > ESP8266 > Autonomo > Autonomo.ino

Ilustración 50 Código.

Paso 2: Actualizar el administrador de placas

Esto se hace para que se pueda instalar la librería ESP8266, Esp32S3 y

Raspberry Pi Pico (Ilustración 51):

- Abrir Arduino e ir a (Archivo > Preferencias).
- Agregar los siguientes links:

Esp8266:

http://arduino.esp8266.com/stable/package_esp8266com_index.jso

n (http://arduino.esp8266.com/stable/package_esp8266com_index.json)

Esp32S3:

https://espressif.github.io/arduino-esp32/package_esp32_index.json

Raspberry Pi Pico:

https://github.com/earlephilhower/arduino-

pico/releases/download/global/package_rp2040_index.json (https://github.com/earlephilhower/arduino-pico/releases/download/global/package_rp2040_index.json)

- Reiniciar el IDE

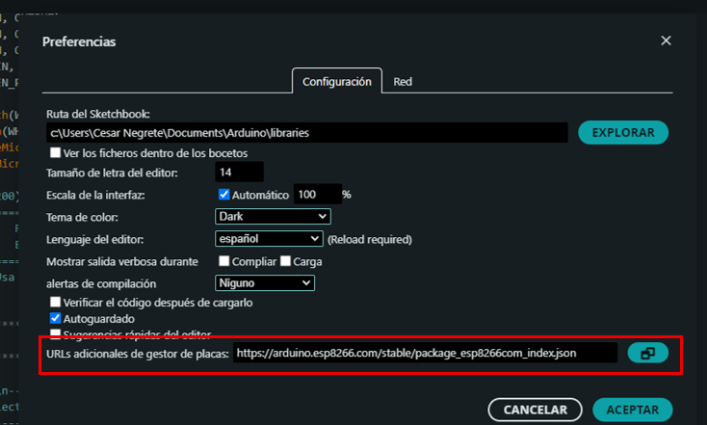
[picture p77: figure]

Ilustración 51 Administrador de placas.

Paso 3: Instalar librería ESP8266, Esp32S3 y Raspberry Pi Pico.

Después de realizar el reinicio del IDE, dirigirse a Herramientas > Placas >

Gestor de placas (Ilustración 52).

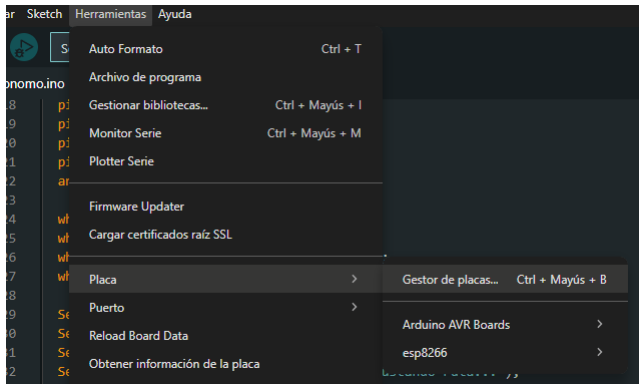
[picture p78: figure]

Ilustración 52 Gestor de placas.

Paso 4: Instalar Librería Esp8266, Esp32S3 y Raspberry Pi Pico.

En el buscador poner “esp8266, Esp32S3 y Raspberry Pi Pico.” e instalar la

versión más moderna. El proceso de descarga puede tardar algunos

minutos.

Esp8266 Ilustración 53, Esp32S3 Ilustración 54, Raspberry Pi Pico Ilustración 55.

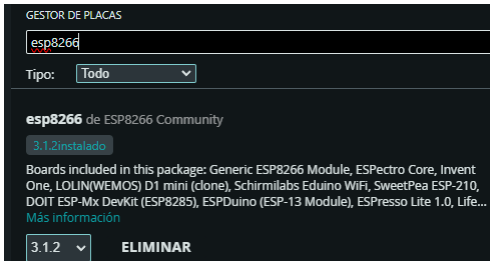
[picture p79: figure]

Ilustración 53 Instalación de librería ESP8266.

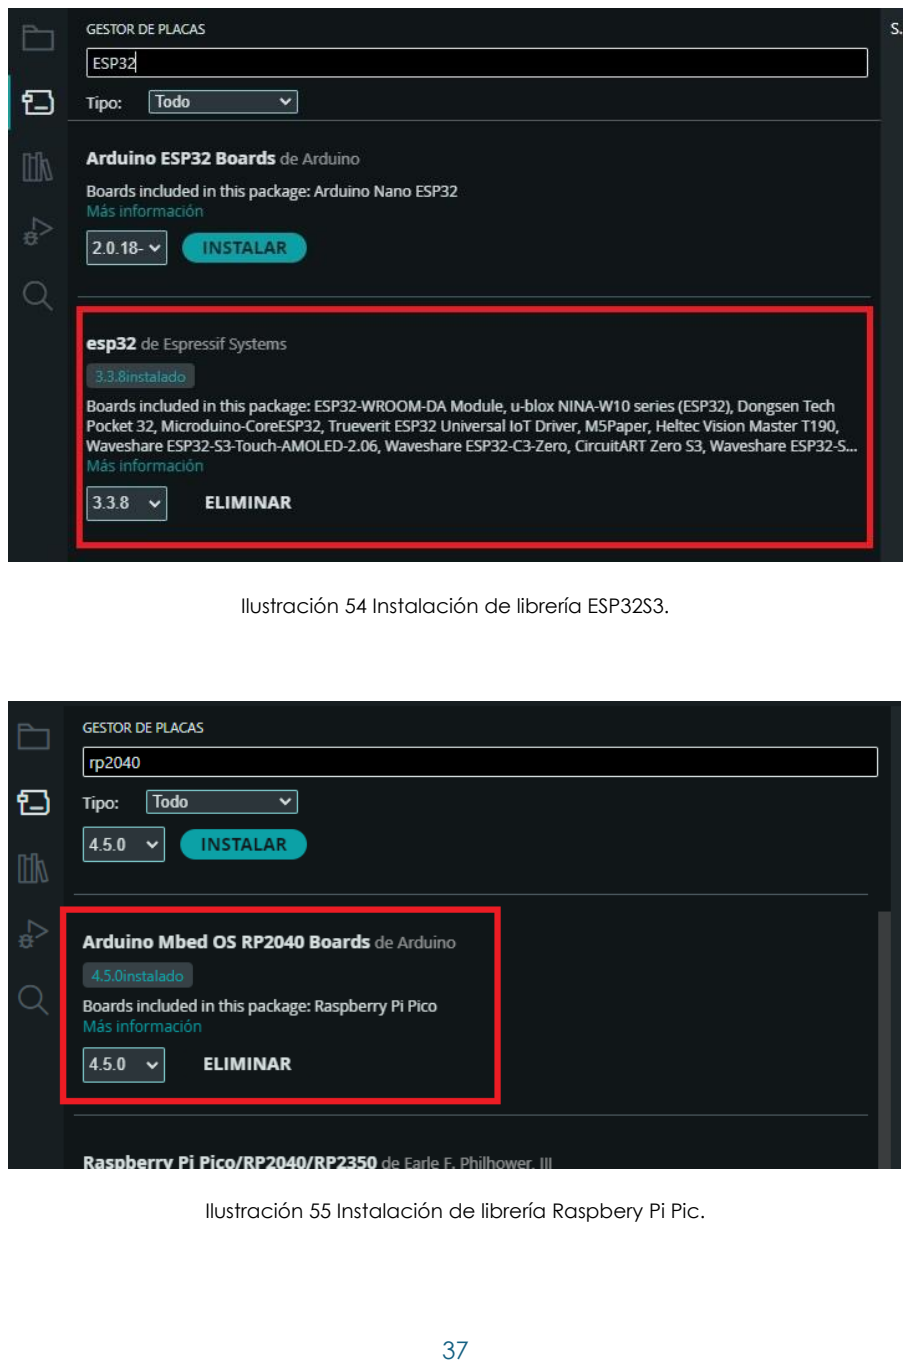
[picture p80: page 37]

Ilustración 54 Instalación de librería ESP32S3.

Ilustración 55 Instalación de librería Raspbery Pi Pic.

Paso 5: Seleccionar placa, en este caso el esp8266

Dirigirse a Herramientas > Placas > esp8266 > Generic ESP8266 Module

(Ilustración 56).

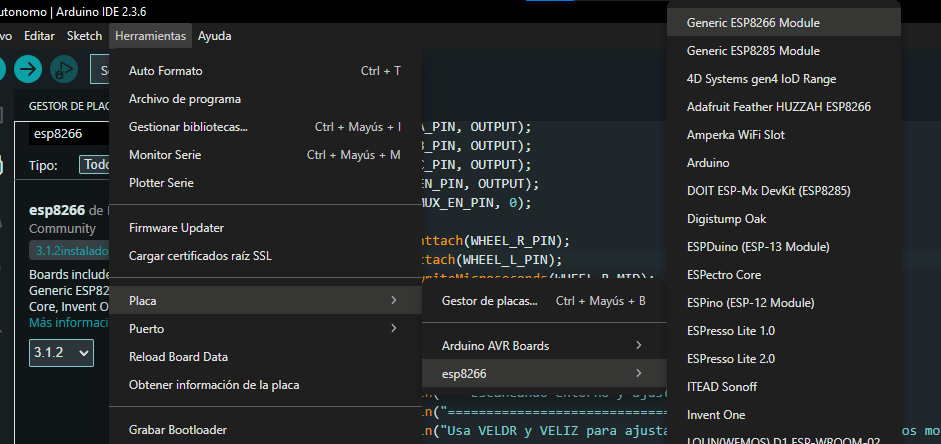
[picture p81: figure]

Ilustración 56 Selección de placa esp8266.

Paso 3: Conectar el ESP8266 a la PC y dirigirnos a Herramientas > Puerto >

Veremos los puestos disponibles, seleccionar el del ESP8266 (Ilustración 57).

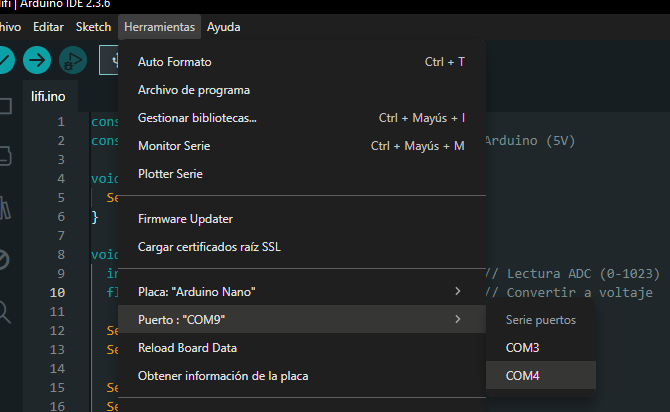
[picture p82: figure]

Ilustración 57 Selección de puerto COM.

Paso6: Cargar código

Conectamos el esp8266 del robot a la computadora mediante un cable

micro usb, asegúrese de que el cable sea de datos (Ilustración 58.

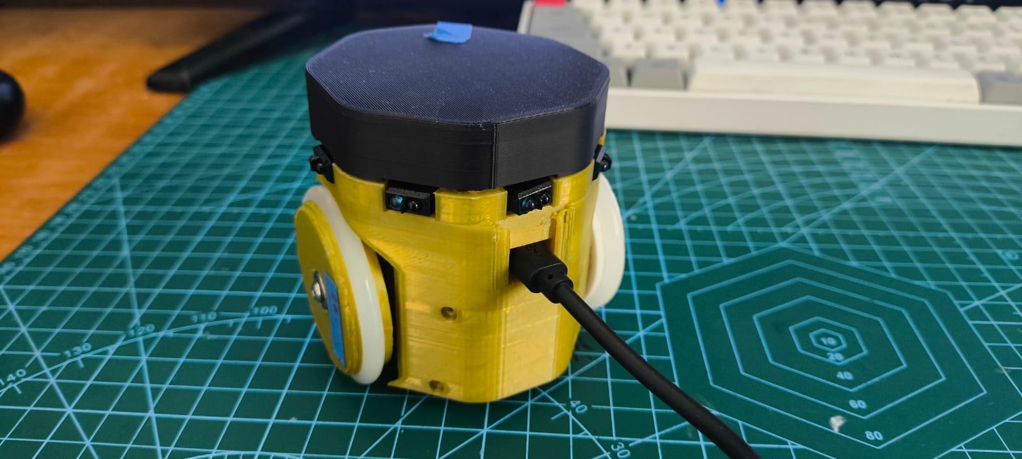
[picture p83: figure]

Ilustración 58 Conexión de cable de datos ar robot.

Ahora pulsamos en el botón de cargar en Arduino (Ilustración 59).

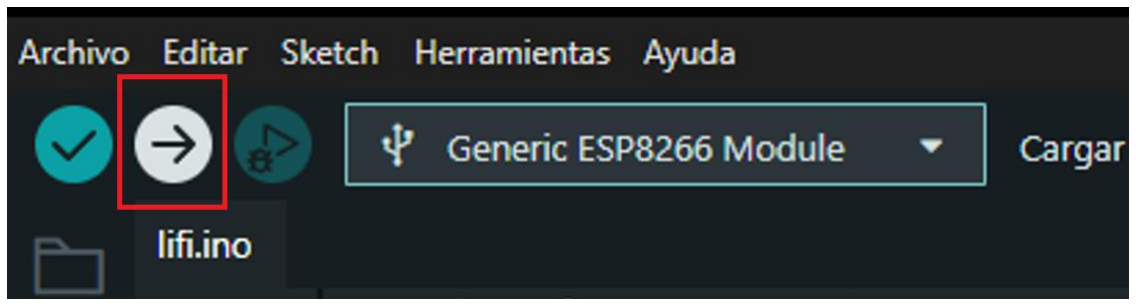
[picture p84: figure]

Ilustración 59 Botón de para cargar código.

Paso 7: Prender el robot

Al costado del robot se encuentra el switch de encendido (Ilustración 60).

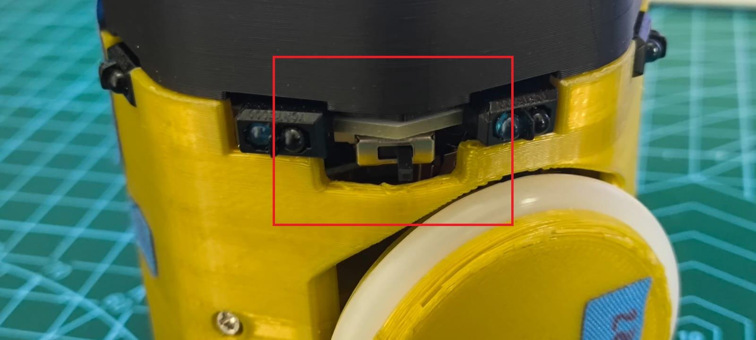
[picture p85: figure]

Ilustración 60 switch de encendido

Hasta este punto el robot ya se encuentra con el código cargado listo para

colocarlo en la pista.

Lo que se observa en estos momentos es que el robot va avanzando y si

encuentra un obstáculo este por medio de los sensores infrarrojos manda

señales al ESP8266 para que este mande una señal a los servomotores para

que cambien de giro y el robot pueda esquivar los obstáculos.

En la ilustración 61 se muestras lineares rojas las cuales representan las

lecturas de los sensores infrarrojos.

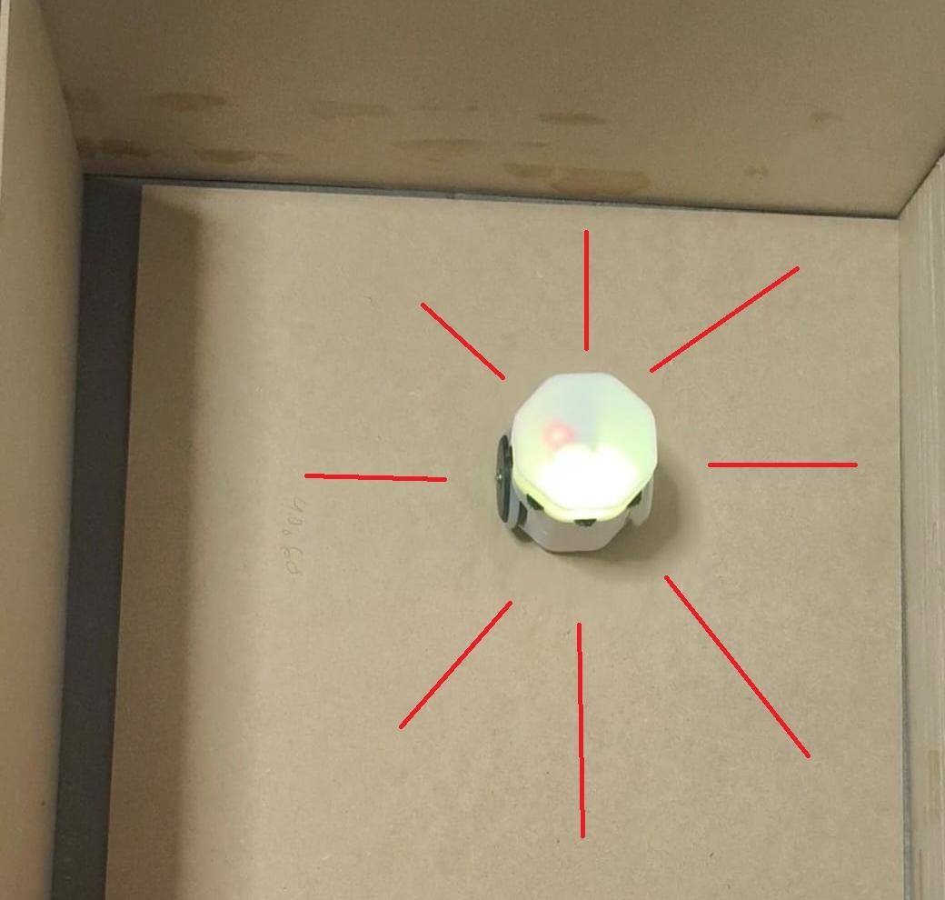
[picture p86: figure]

Ilustración 61 Robot en pista.
