Arttech3d/Hormiga/KiCad/Ant Raspberry PI PICO/board.pdf

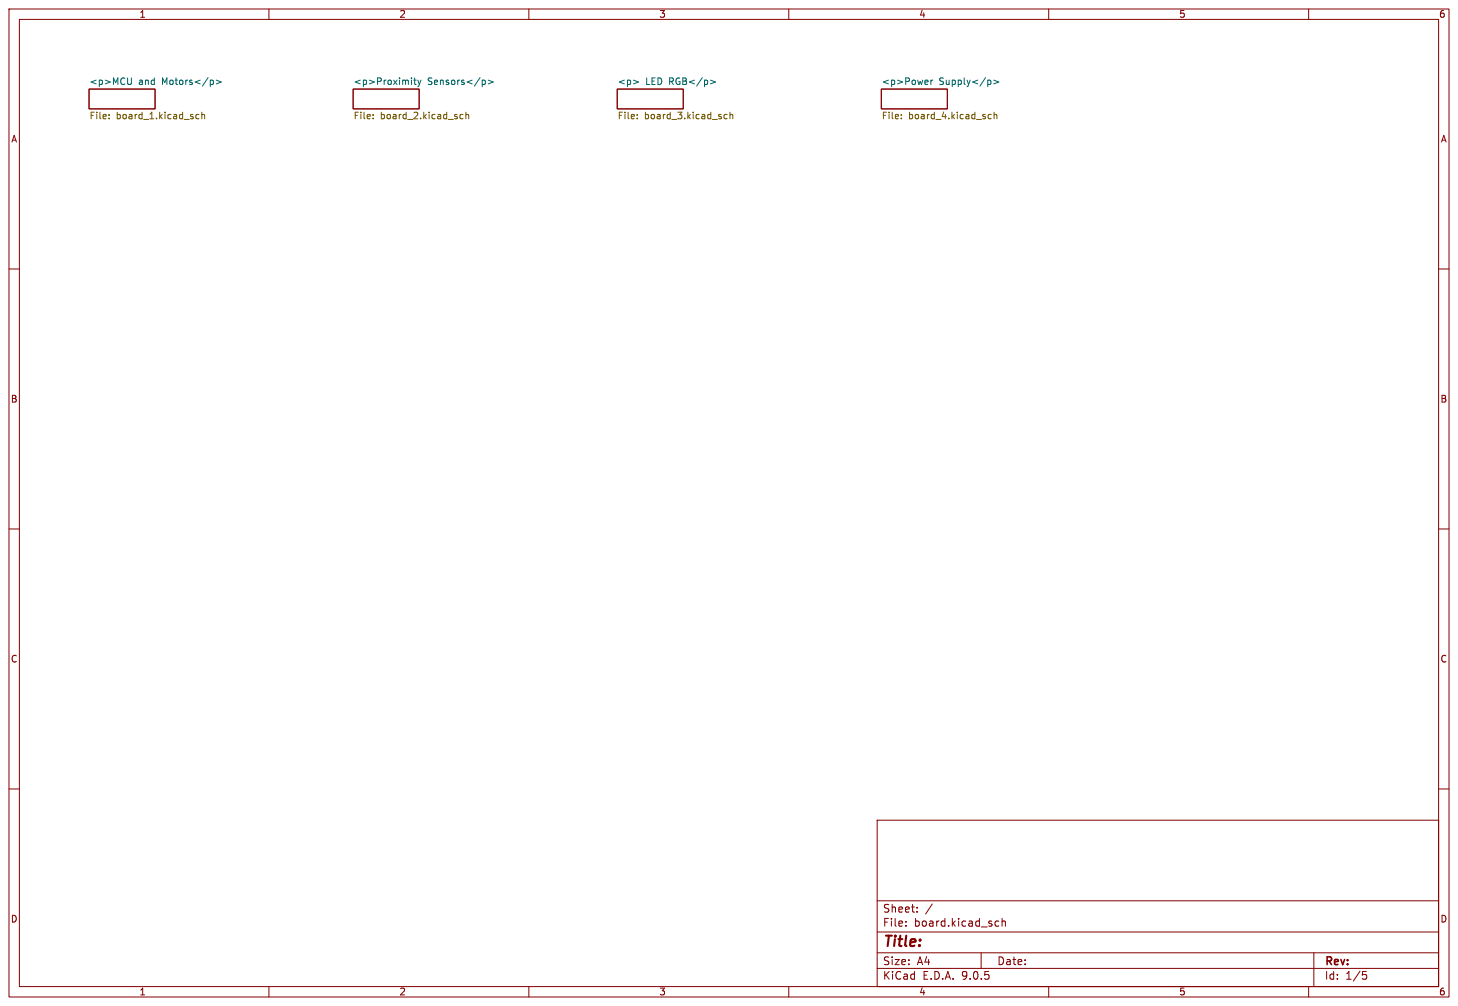
[picture p87: page 1]

Id: 1/5 Title: File: board.kicad_sch Sheet: /

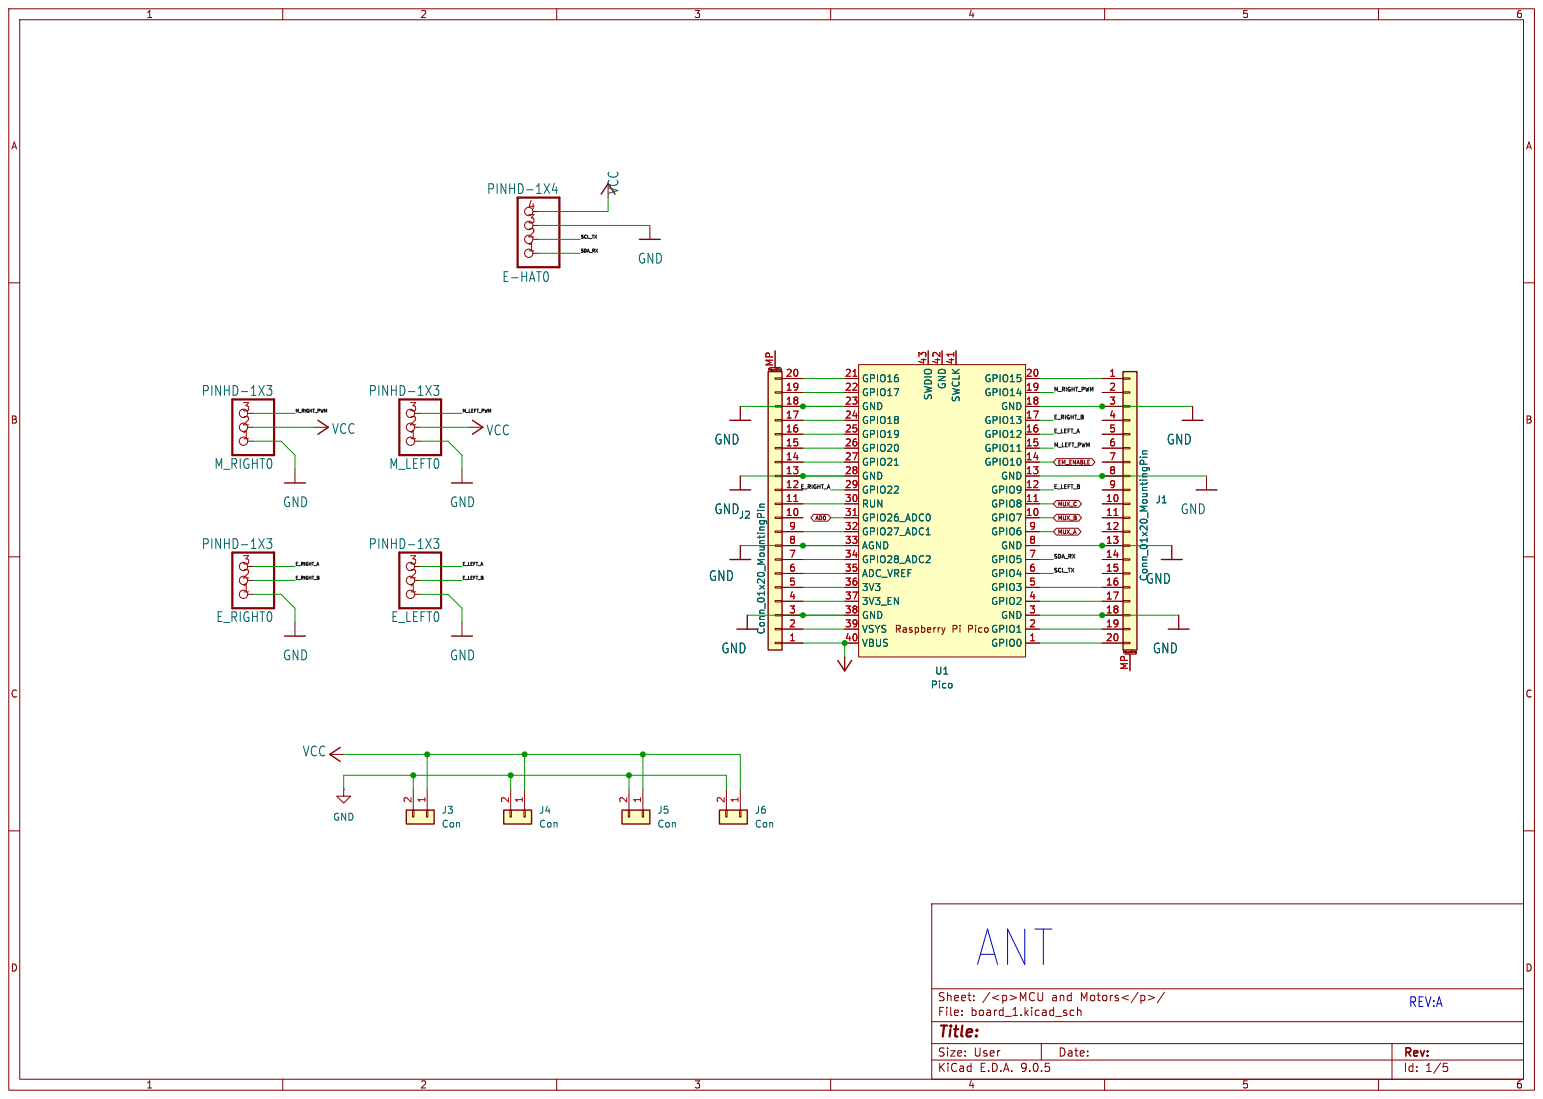
[picture p88: page 2]

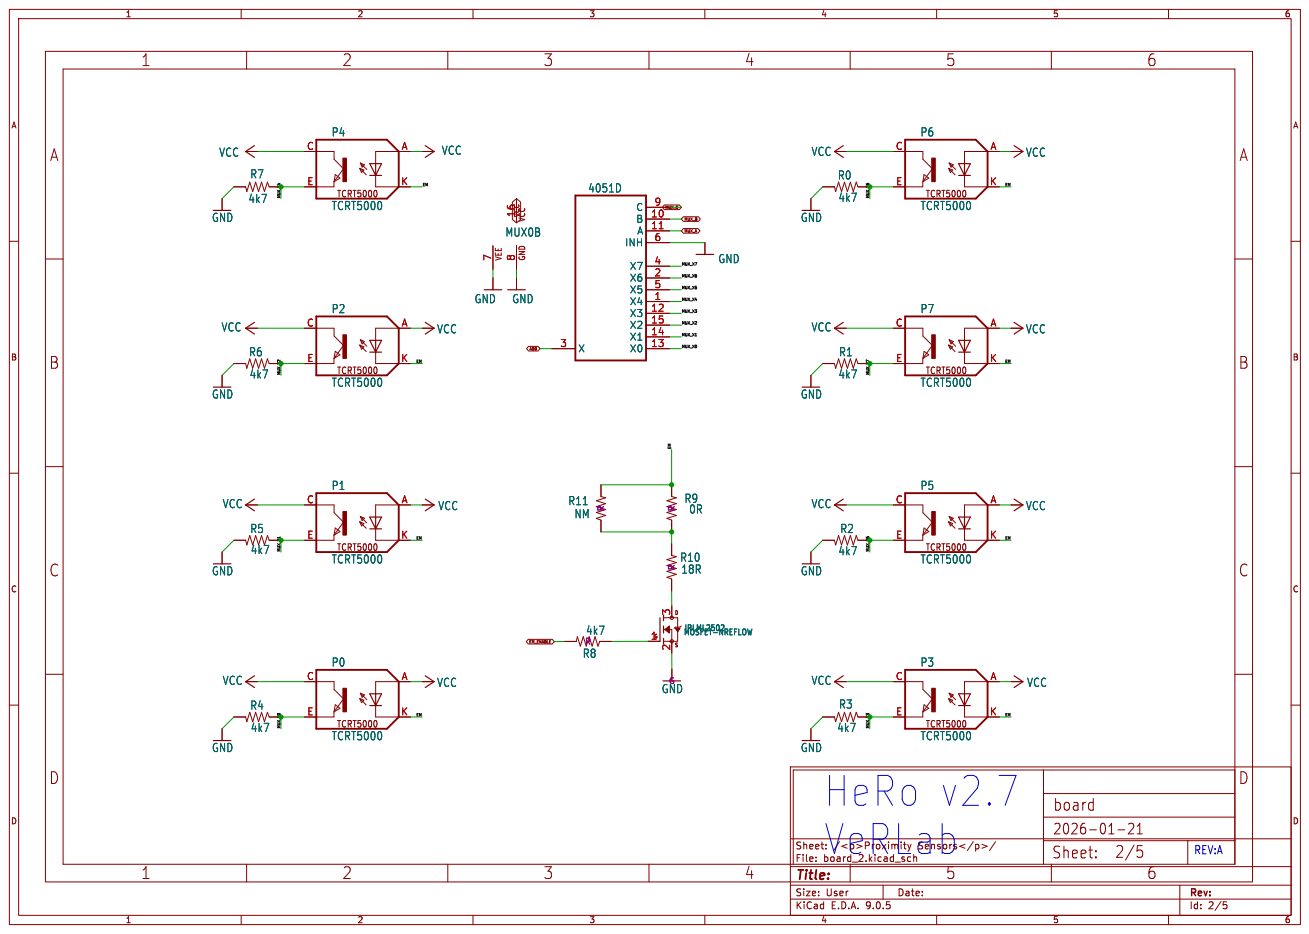
[picture p89: page 3]

HeRo v2.7

REV:A

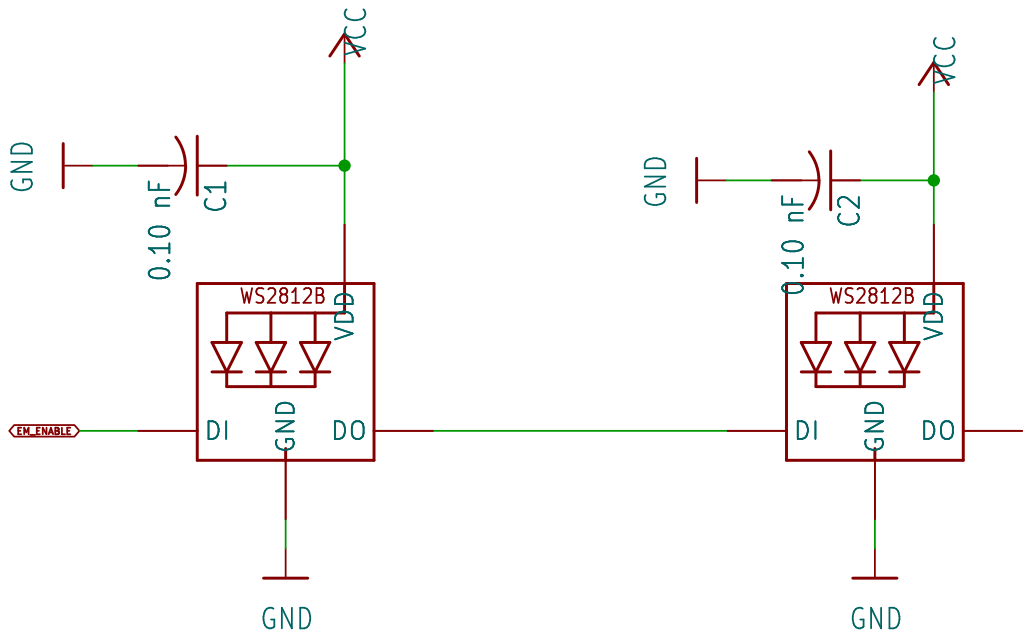
[picture p90: page 4]

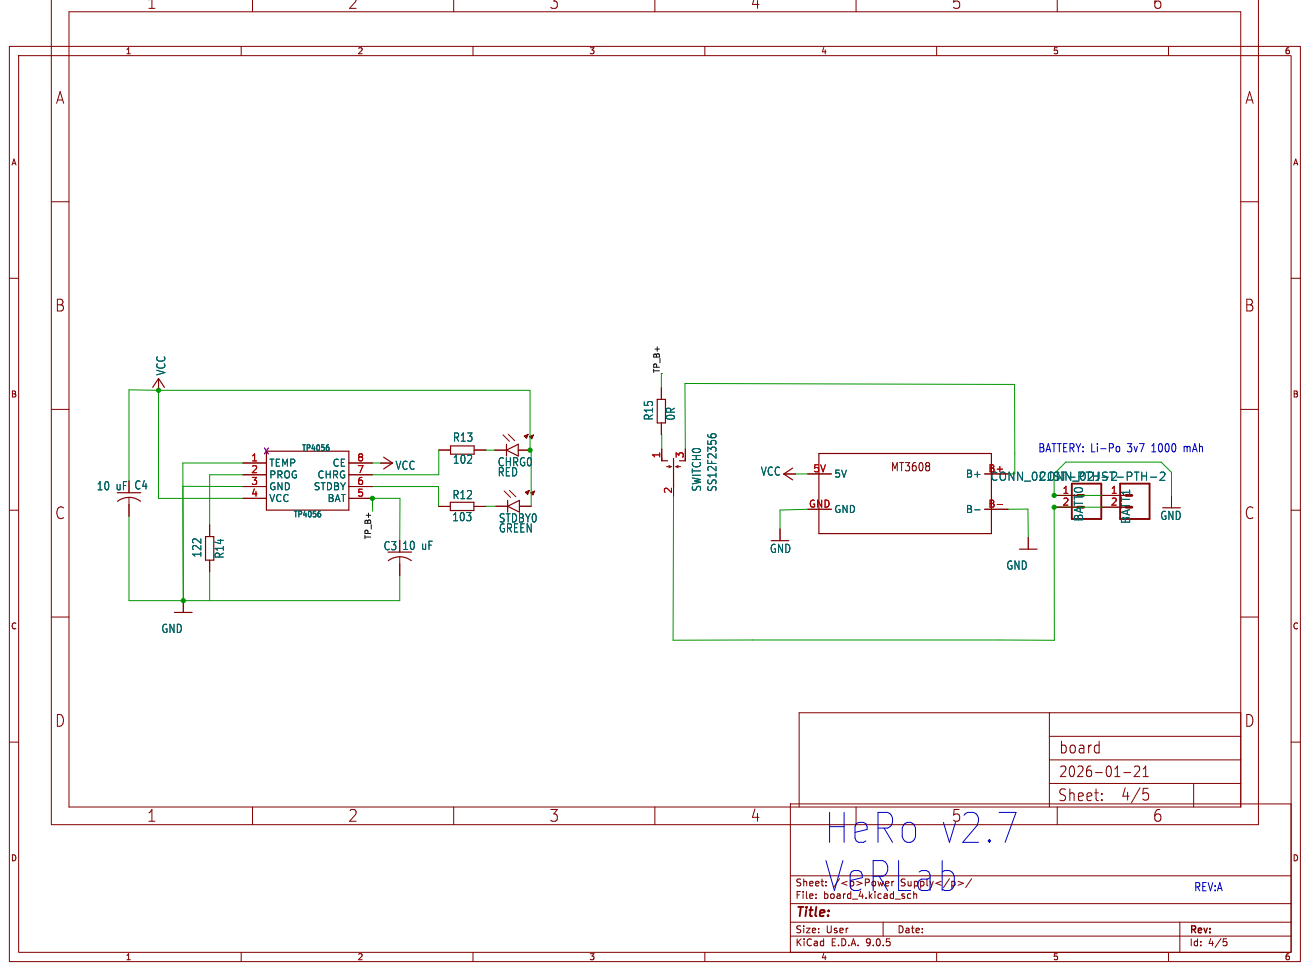
[picture p91: page 5]
