Arttech3d/Hormiga/Material/Lista de impresiones 3D.pdf

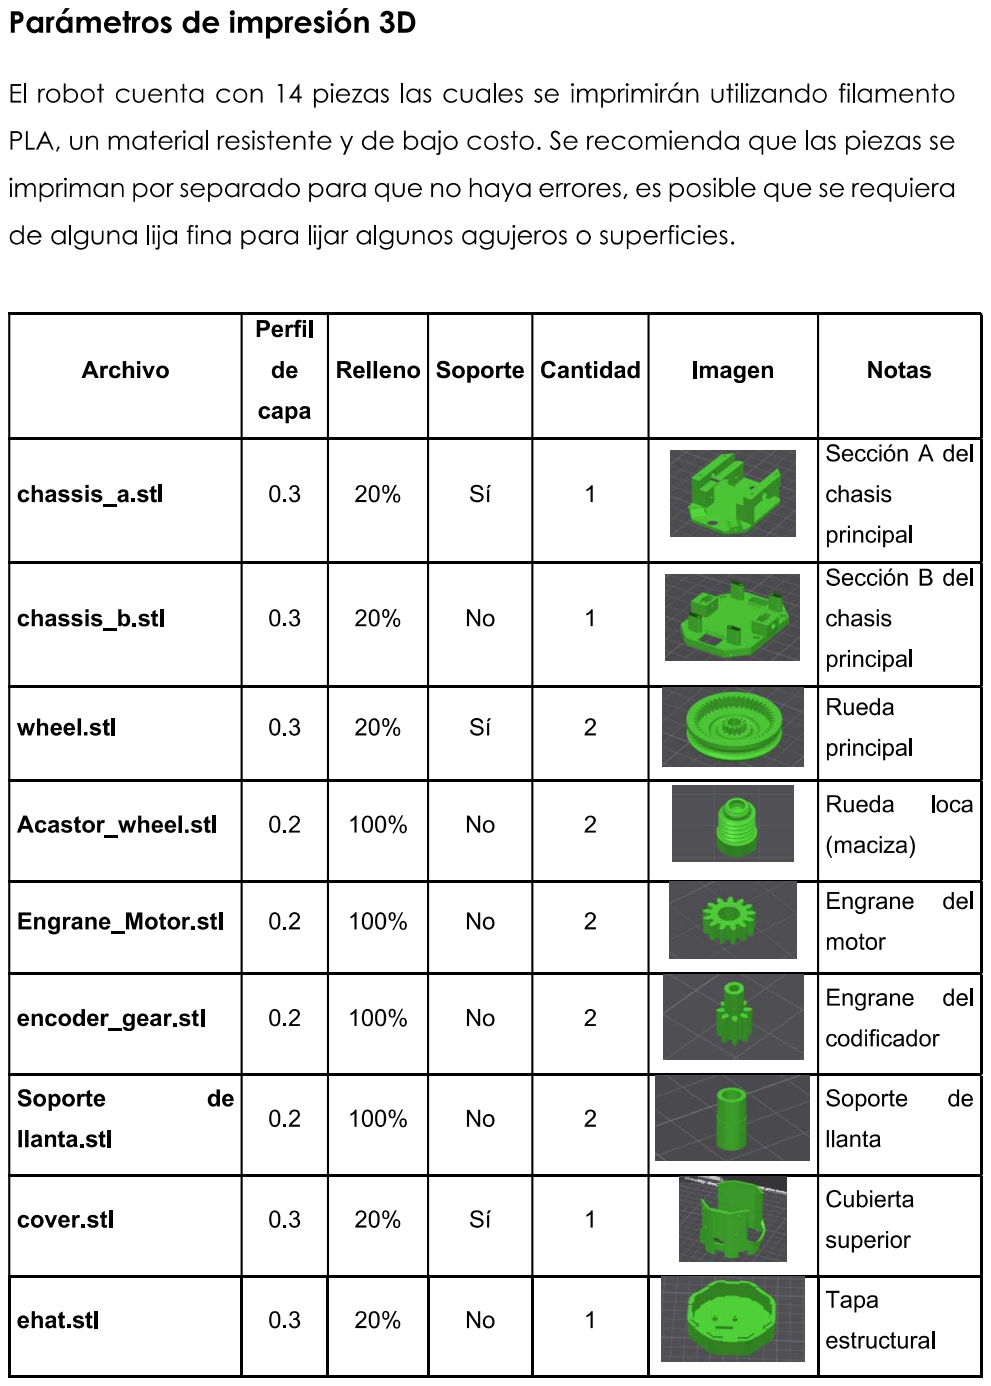
[picture p92: page 1]
