Arttech3d/Hormiga/KiCad/Ant ESP32-S3/board.kicad_pcb

## KiCad design KiCad/Ant ESP32-S3/board.kicad_pcb (2026-01-27)

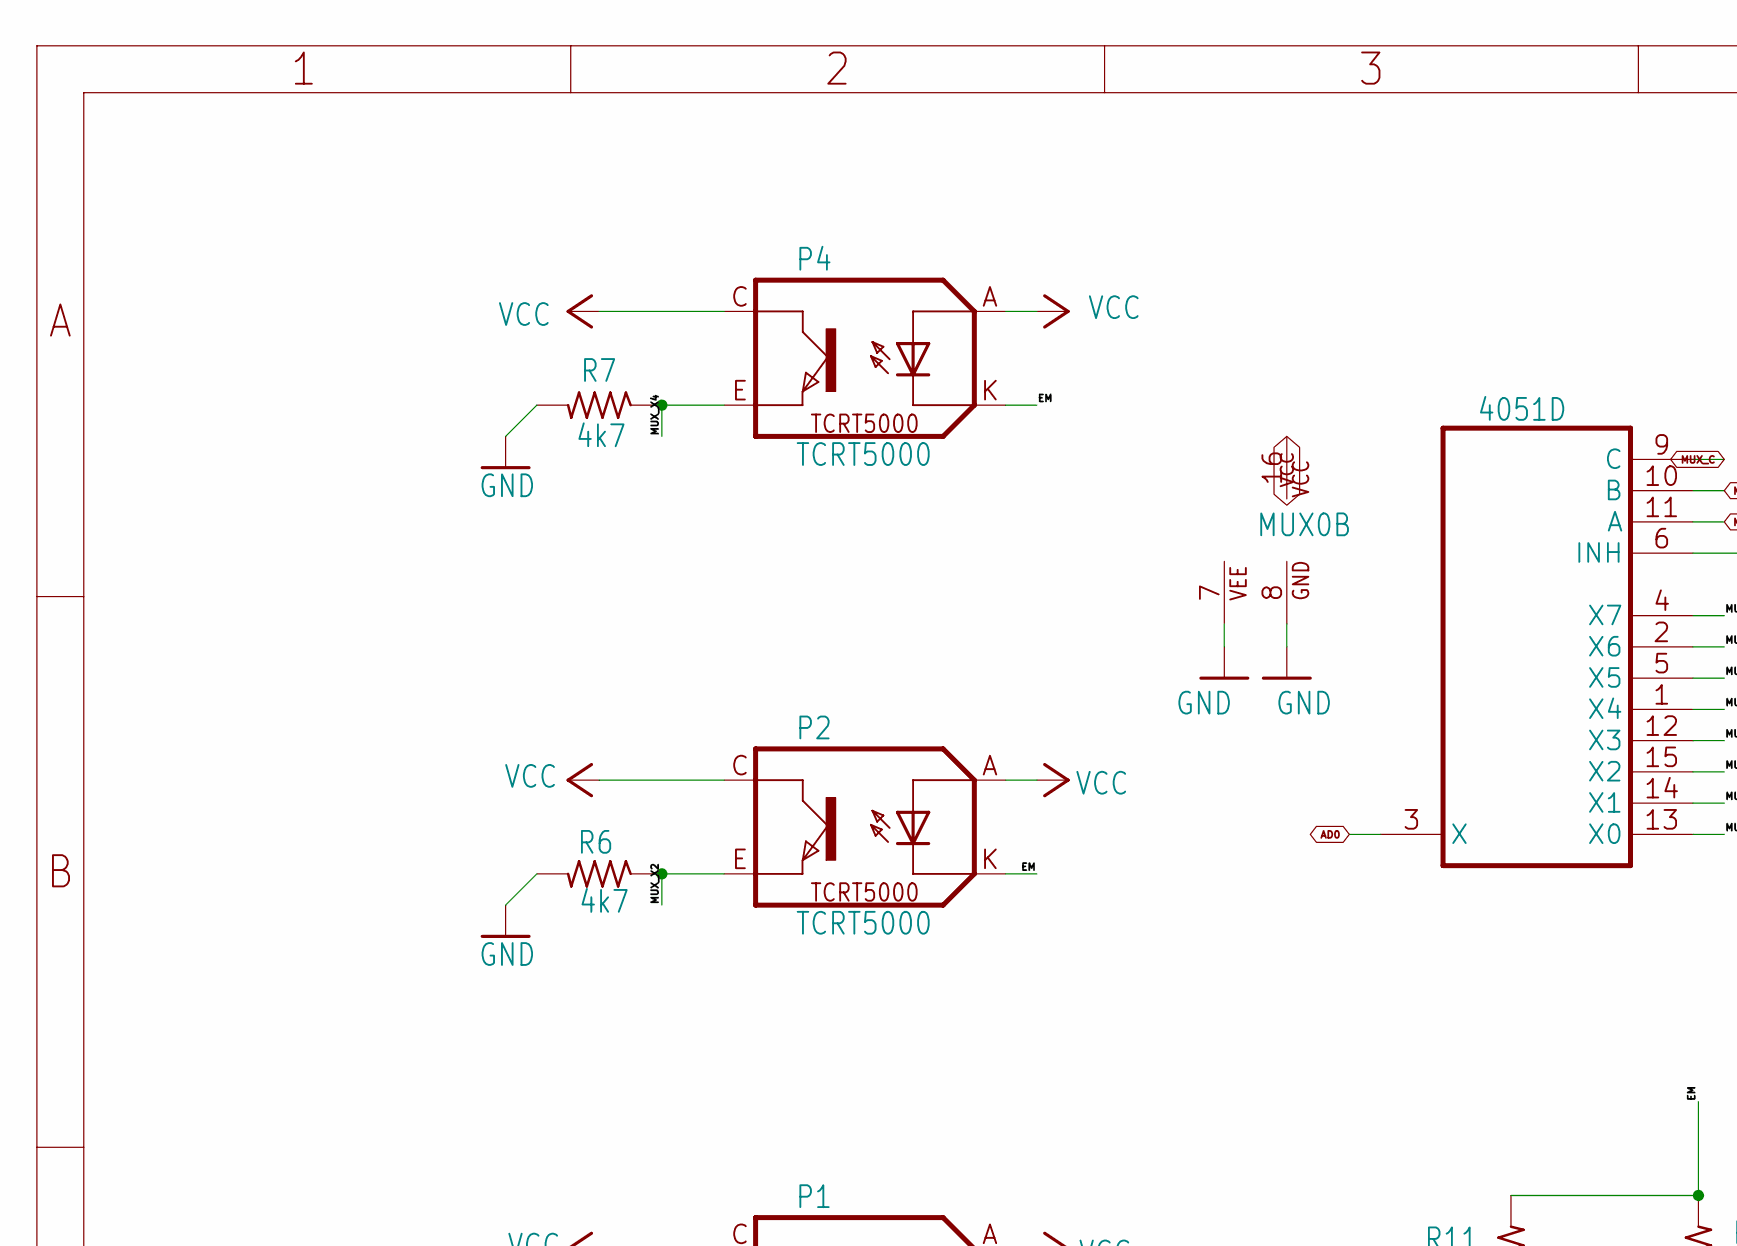
[picture p93: schematic board_2.kicad_sch, part in row 1, column 1]

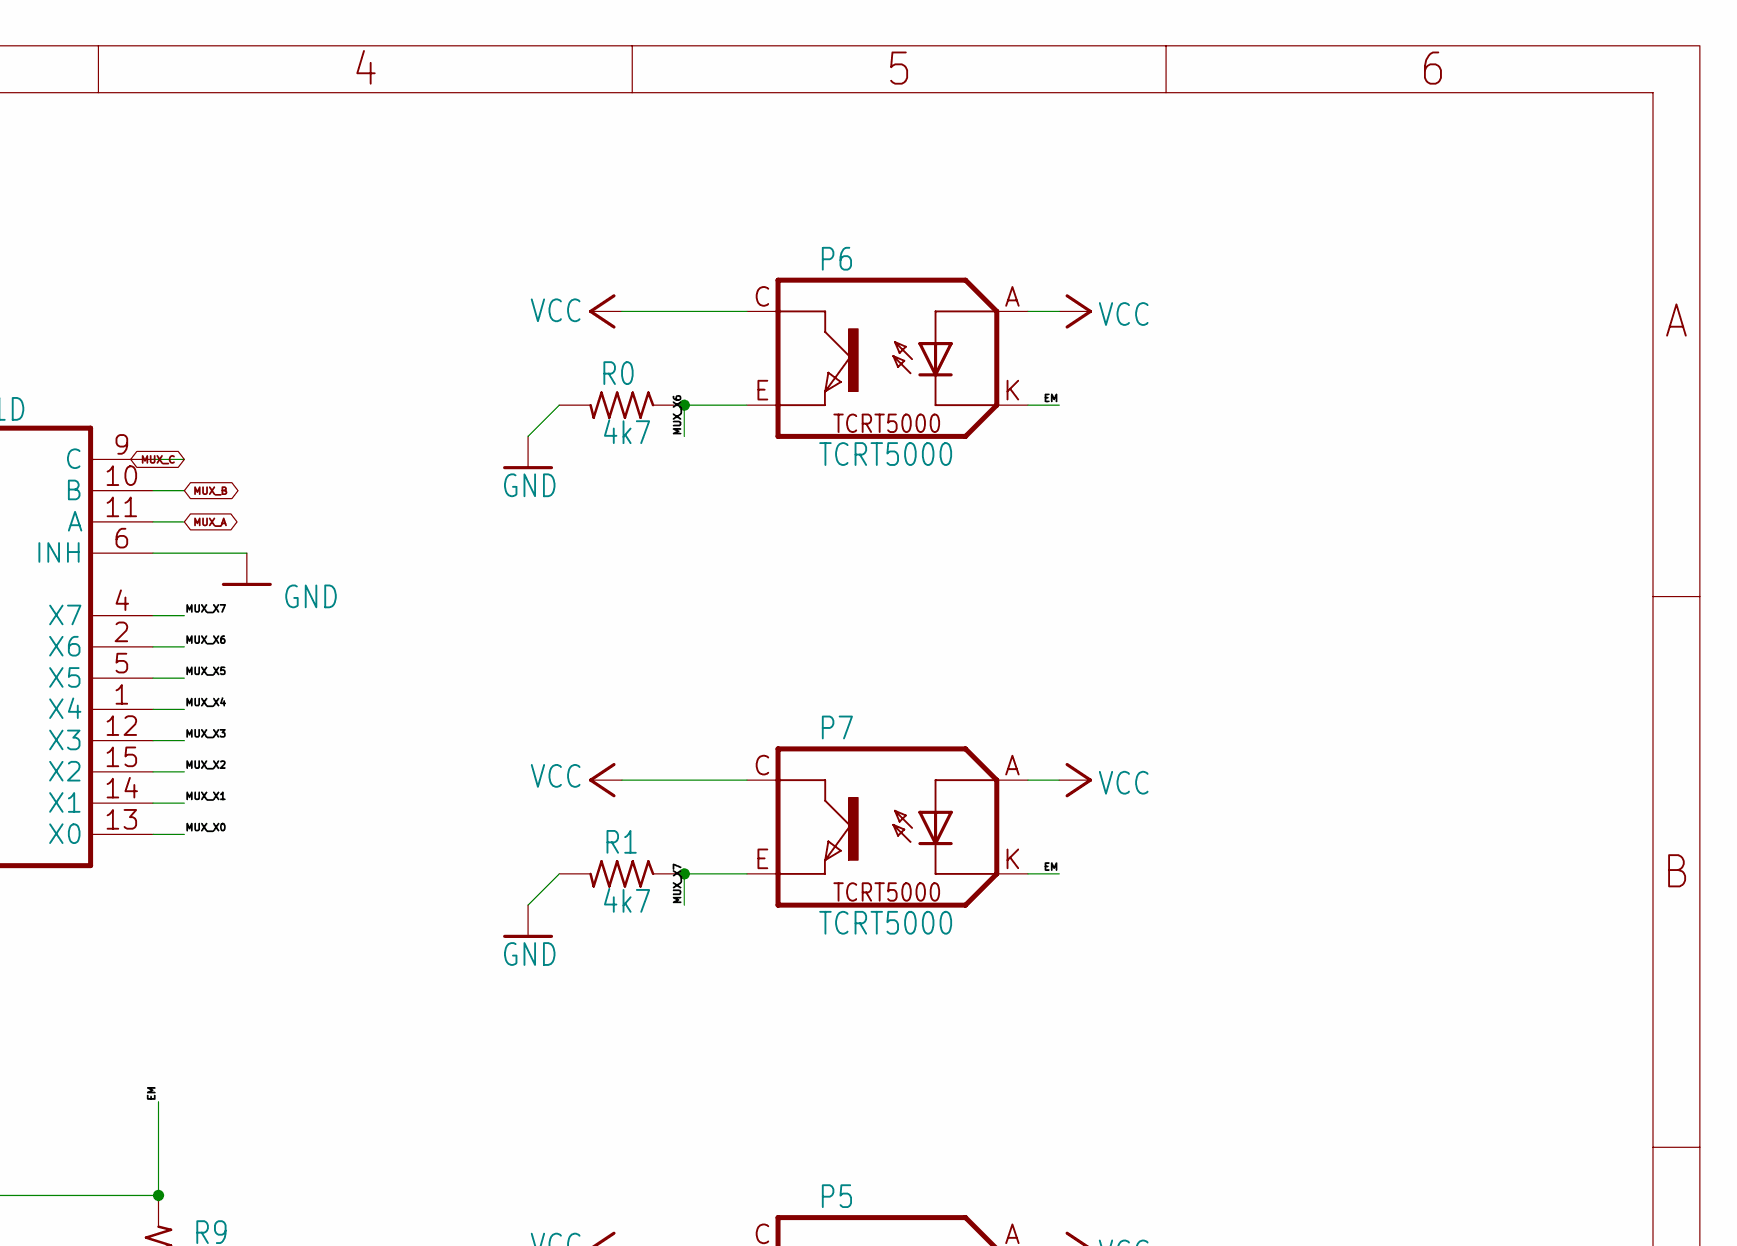
[picture p94: schematic board_2.kicad_sch, part in row 1, column 2]

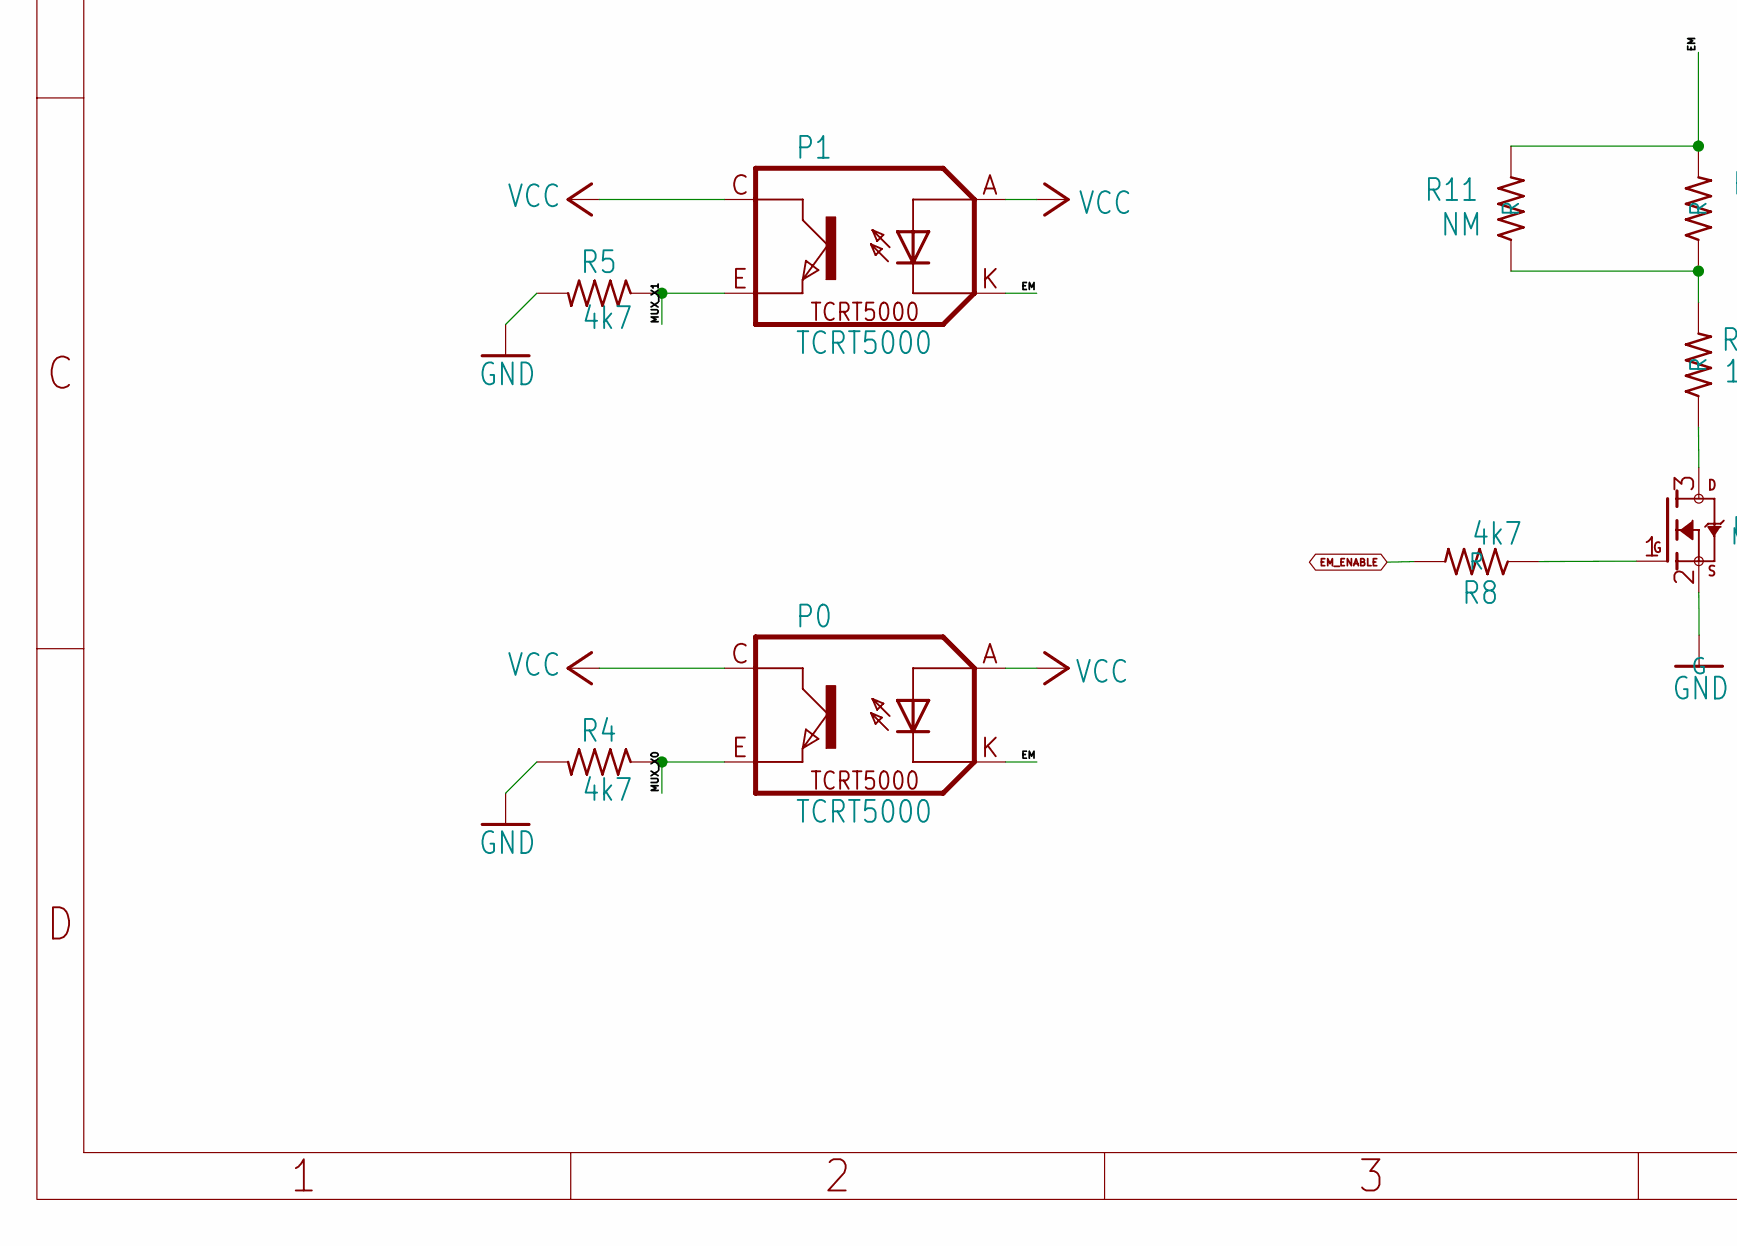
[picture p95: schematic board_2.kicad_sch, part in row 2, column 1]

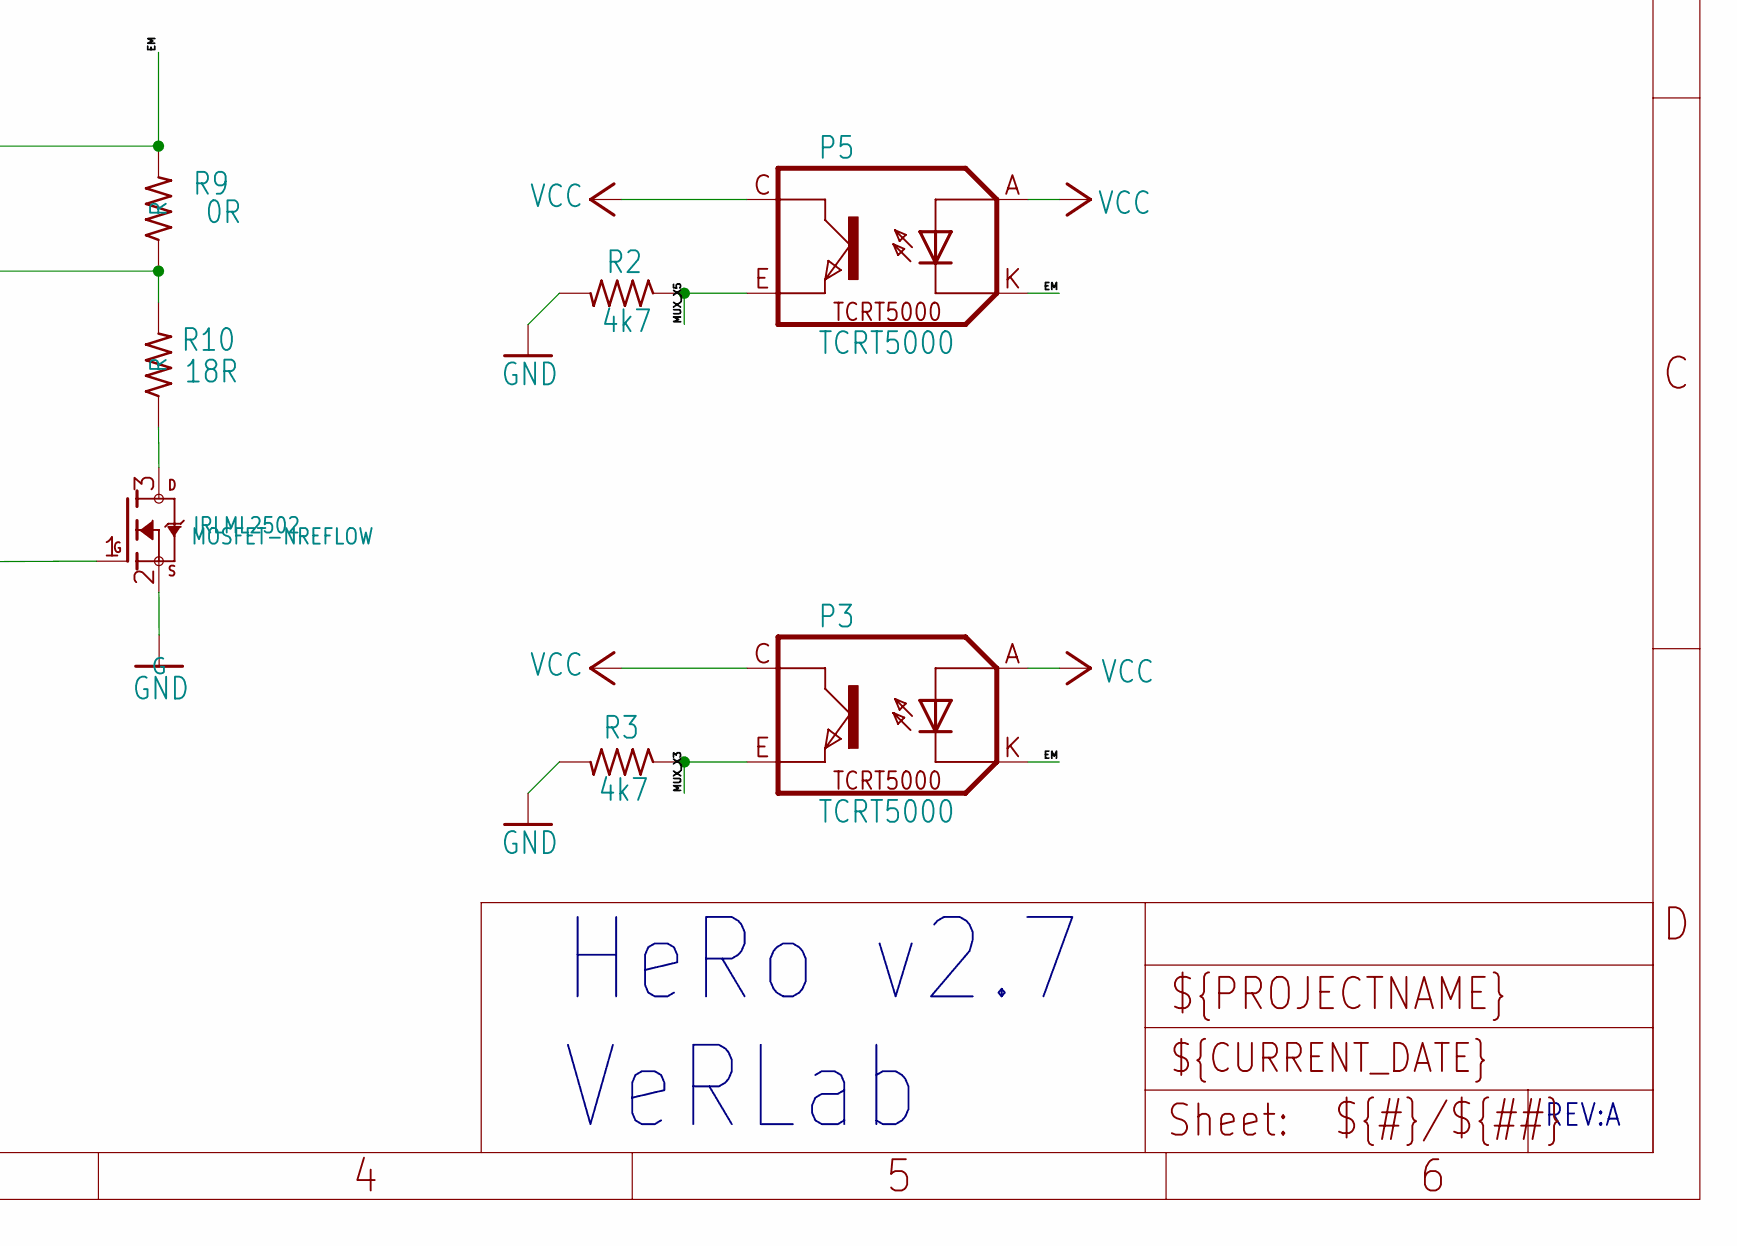
[picture p96: schematic board_2.kicad_sch, part in row 2, column 2]

Parts:
IRLML2502: MOSFET-NREFLOW; SOT23
MUX0: 4051D; SO16
P0, P1, P2, P3, P4, P5, P6, P7: TCRT5000
R0, R1, R2, R3, R4, R5, R6, R7: 4k7; M0805
R8: 4k7; R0805
R9: 0R; R0805
R10: 18R; R0805
R11: NM; R0805

Connections:
/<p>Proximity Sensors</p>/EM: P0.K (CATHODE), P1.K (CATHODE), P2.K (CATHODE), P3.K (CATHODE), P4.K (CATHODE), P5.K (CATHODE), P6.K (CATHODE), P7.K (CATHODE), R9.2, R11.2
/<p>Proximity Sensors</p>/MUX_X0: MUX0.13 (X0), P0.E (EMITTER), R4.1
/<p>Proximity Sensors</p>/MUX_X1: MUX0.14 (X1), P1.E (EMITTER), R5.1
/<p>Proximity Sensors</p>/MUX_X2: MUX0.15 (X2), P2.E (EMITTER), R6.1
/<p>Proximity Sensors</p>/MUX_X3: MUX0.12 (X3), P3.E (EMITTER), R3.1
/<p>Proximity Sensors</p>/MUX_X4: MUX0.1 (X4), P4.E (EMITTER), R7.1
/<p>Proximity Sensors</p>/MUX_X5: MUX0.5 (X5), P5.E (EMITTER), R2.1
/<p>Proximity Sensors</p>/MUX_X6: MUX0.2 (X6), P6.E (EMITTER), R0.1
/<p>Proximity Sensors</p>/MUX_X7: MUX0.4 (X7), P7.E (EMITTER), R1.1
AD0: MUX0.3 (X); also elsewhere on the board
EM_ENABLE: R8.2; also elsewhere on the board
GND: IRLML2502.2 (S), MUX0.6 (INH), MUX0.7 (VEE), MUX0.8 (GND), R0.2, R1.2, R2.2, R3.2, R4.2, R5.2, R6.2, R7.2; also elsewhere on the board
MUX_A: MUX0.11 (A); also elsewhere on the board
MUX_B: MUX0.10 (B); also elsewhere on the board
MUX_C: MUX0.9 (C); also elsewhere on the board
unnamed: IRLML2502.3 (D), R10.1
unnamed: IRLML2502.1 (G), R8.1
unnamed: R9.1, R10.2, R11.1
VCC: MUX0.16 (VCC), P0.A (ANODE), P0.C (COLLECTOR), P1.A (ANODE), P1.C (COLLECTOR), P2.A (ANODE), P2.C (COLLECTOR), P3.A (ANODE), P3.C (COLLECTOR), P4.A (ANODE), P4.C (COLLECTOR), P5.A (ANODE), P5.C (COLLECTOR), P6.A (ANODE), P6.C (COLLECTOR), P7.A (ANODE), P7.C (COLLECTOR); also elsewhere on the board

Notes on the sheet:
HeRo v2.7 VeRLab
REV:A

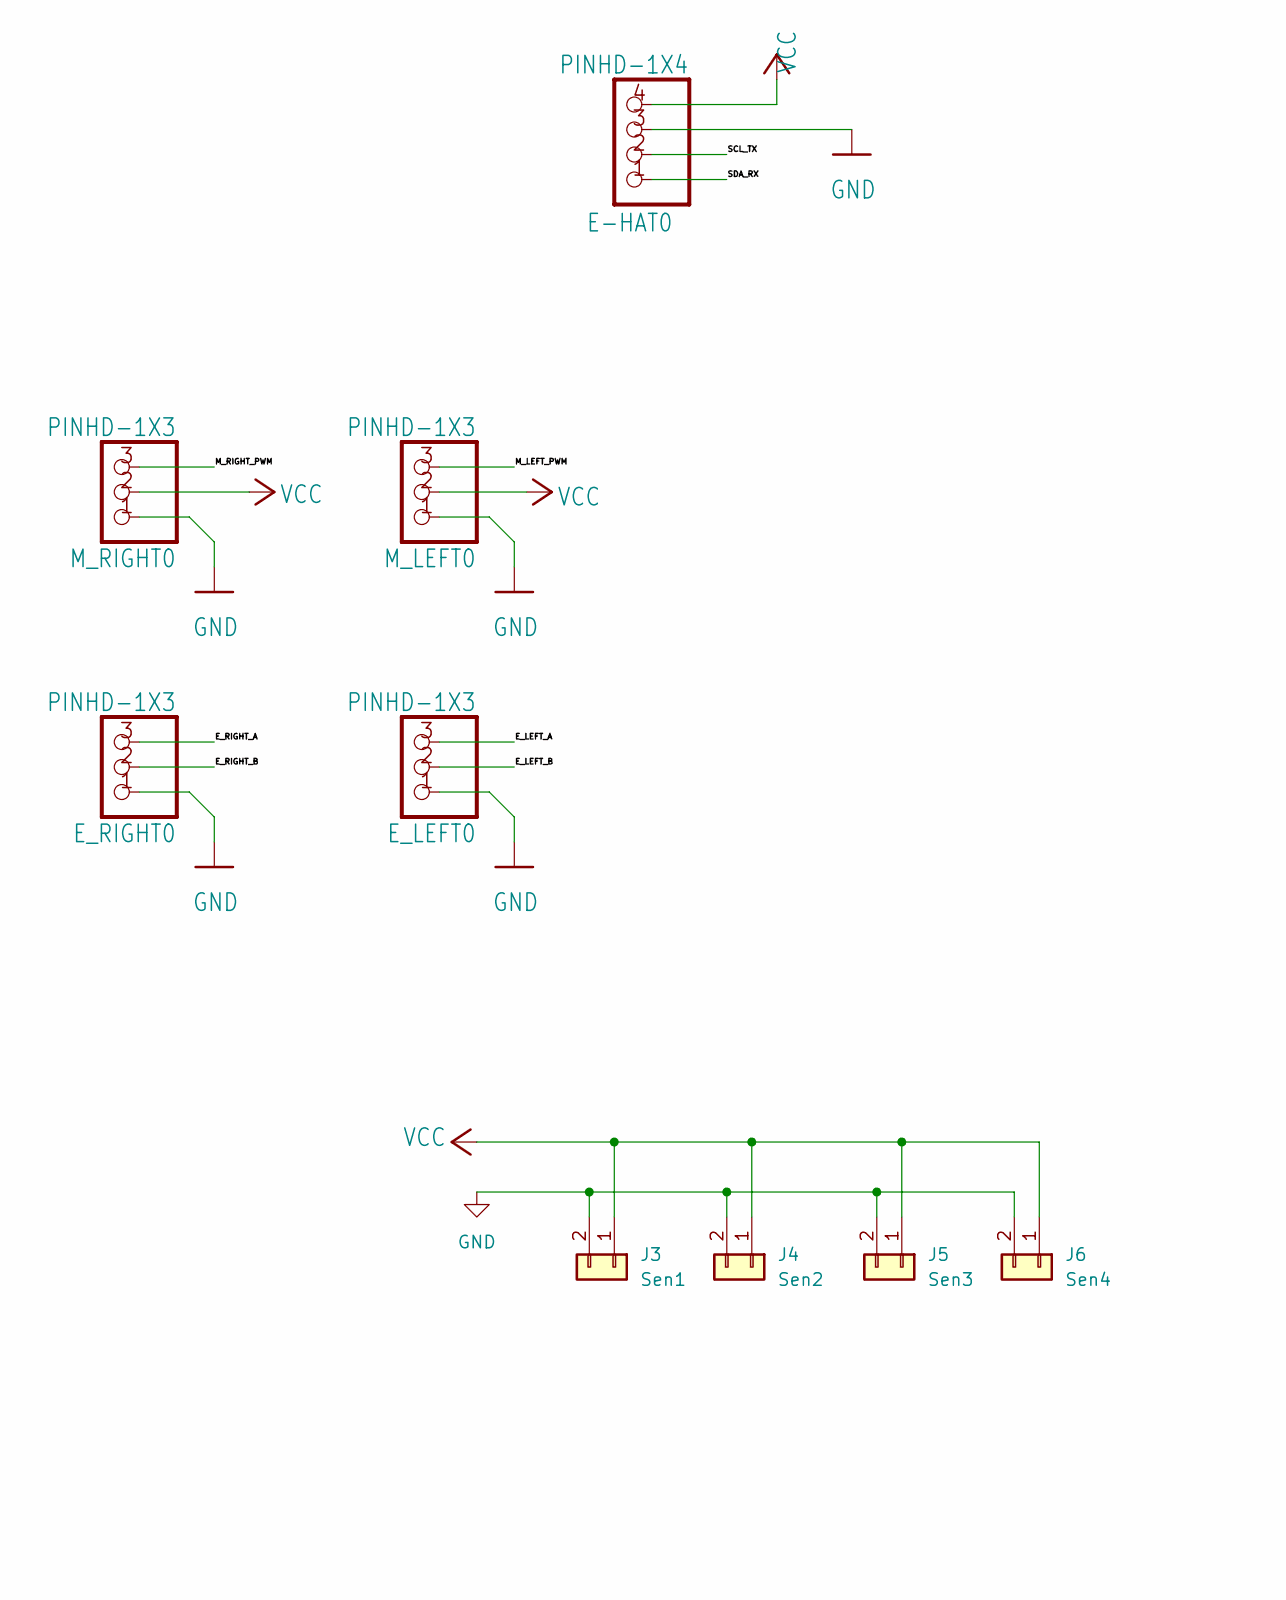
[picture p97: schematic board_1.kicad_sch, part in row 1, column 1]

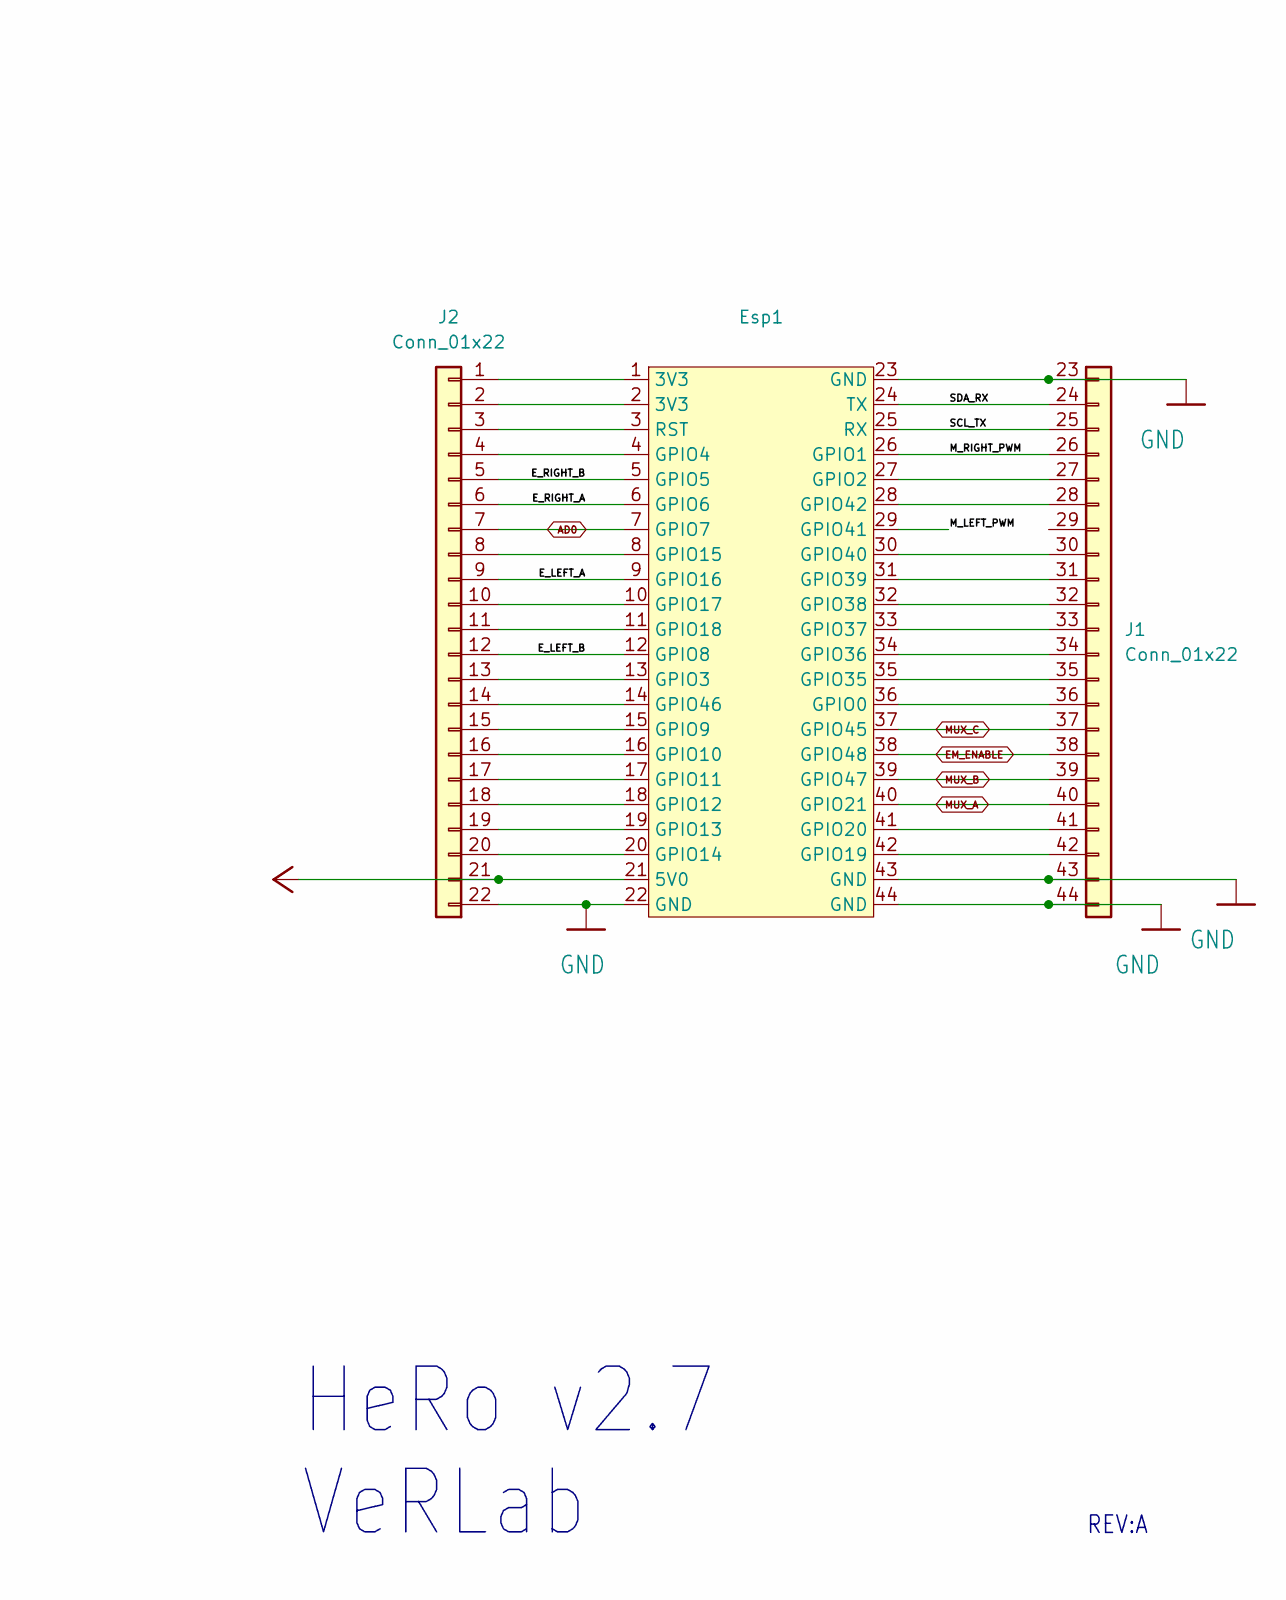
[picture p98: schematic board_1.kicad_sch, part in row 1, column 2]

Parts:
E-HAT0: PINHD-1X4; 1X04
E_LEFT0: PINHD-1X3; 1X03
E_RIGHT0: PINHD-1X3; 1X03
Esp1: Untitled
J1, J2: Conn_01x22; PinHeader_1x22_P2.54mm_Vertical
J3: Sen1; PinHeader_1x02_P2.00mm_Vertical
J4: Sen2; PinHeader_1x02_P2.00mm_Vertical
J5: Sen3; PinHeader_1x02_P2.00mm_Vertical
J6: Sen4; PinHeader_1x02_P2.00mm_Vertical
M_LEFT0: PINHD-1X3; 1X03
M_RIGHT0: PINHD-1X3; 1X03

Connections:
/<p>MCU and Motors</p>/E_LEFT_A: E_LEFT0.3, Esp1.9 (GPIO16), J2.9 (Pin_14)
/<p>MCU and Motors</p>/E_LEFT_B: E_LEFT0.2, Esp1.12 (GPIO8), J2.12 (Pin_11)
/<p>MCU and Motors</p>/E_RIGHT_A: E_RIGHT0.3, Esp1.6 (GPIO6), J2.6 (Pin_17)
/<p>MCU and Motors</p>/E_RIGHT_B: E_RIGHT0.2, Esp1.5 (GPIO5), J2.5 (Pin_18)
/<p>MCU and Motors</p>/M_LEFT_PWM: Esp1.29 (GPIO41), M_LEFT0.3
/<p>MCU and Motors</p>/M_RIGHT_PWM: Esp1.26 (GPIO1), J1.26 (Pin_4), M_RIGHT0.3
/<p>MCU and Motors</p>/SCL_TX: E-HAT0.2, Esp1.25 (RX), J1.25 (Pin_3)
/<p>MCU and Motors</p>/SDA_RX: E-HAT0.1, Esp1.24 (TX), J1.24
AD0: Esp1.7 (GPIO7), J2.7 (Pin_16); also elsewhere on the board
EM_ENABLE: Esp1.38 (GPIO48), J1.38 (Pin_16); also elsewhere on the board
GND: E-HAT0.3, E_LEFT0.1, E_RIGHT0.1, Esp1.22 (GND), Esp1.23 (GND), Esp1.43 (GND), Esp1.44 (GND), J1.23, J1.43 (Pin_21), J1.44 (Pin_22), J2.22 (Pin_1), J3.2, J4.2, J5.2, J6.2, M_LEFT0.1, M_RIGHT0.1; also elsewhere on the board
MUX_A: Esp1.40 (GPIO21), J1.40 (Pin_18); also elsewhere on the board
MUX_B: Esp1.39 (GPIO47), J1.39 (Pin_17); also elsewhere on the board
MUX_C: Esp1.37 (GPIO45), J1.37 (Pin_15); also elsewhere on the board
unnamed: Esp1.1 (3V3), J2.1
unnamed: Esp1.36 (GPIO0), J1.36 (Pin_14)
unnamed: Esp1.27 (GPIO2), J1.27 (Pin_5)
unnamed: Esp1.13 (GPIO3), J2.13 (Pin_10)
unnamed: Esp1.4 (GPIO4), J2.4 (Pin_19)
unnamed: Esp1.15 (GPIO9), J2.15 (Pin_8)
unnamed: Esp1.16 (GPIO10), J2.16 (Pin_7)
unnamed: Esp1.17 (GPIO11), J2.17 (Pin_6)
unnamed: Esp1.18 (GPIO12), J2.18 (Pin_5)
unnamed: Esp1.19 (GPIO13), J2.19 (Pin_4)
unnamed: Esp1.20 (GPIO14), J2.20 (Pin_3)
unnamed: Esp1.8 (GPIO15), J2.8 (Pin_15)
unnamed: Esp1.10 (GPIO17), J2.10 (Pin_13)
unnamed: Esp1.11 (GPIO18), J2.11 (Pin_12)
unnamed: Esp1.42 (GPIO19), J1.42 (Pin_20)
unnamed: Esp1.41 (GPIO20), J1.41 (Pin_19)
unnamed: Esp1.35 (GPIO35), J1.35 (Pin_13)
unnamed: Esp1.34 (GPIO36), J1.34 (Pin_12)
unnamed: Esp1.33 (GPIO37), J1.33 (Pin_11)
unnamed: Esp1.32 (GPIO38), J1.32 (Pin_10)
unnamed: Esp1.31 (GPIO39), J1.31 (Pin_9)
unnamed: Esp1.30 (GPIO40), J1.30 (Pin_8)
unnamed: Esp1.28 (GPIO42), J1.28 (Pin_6)
unnamed: Esp1.14 (GPIO46), J2.14 (Pin_9)
unnamed: Esp1.3 (RST), J2.3 (Pin_20)
unnamed: Esp1.2 (3V3), J2.2 (Pin_21)
VCC: E-HAT0.4, Esp1.21 (5V0), J2.21 (Pin_2), J3.1, J4.1, J5.1, J6.1, M_LEFT0.2, M_RIGHT0.2; also elsewhere on the board

Notes on the sheet:
HeRo v2.7 VeRLab
REV:A

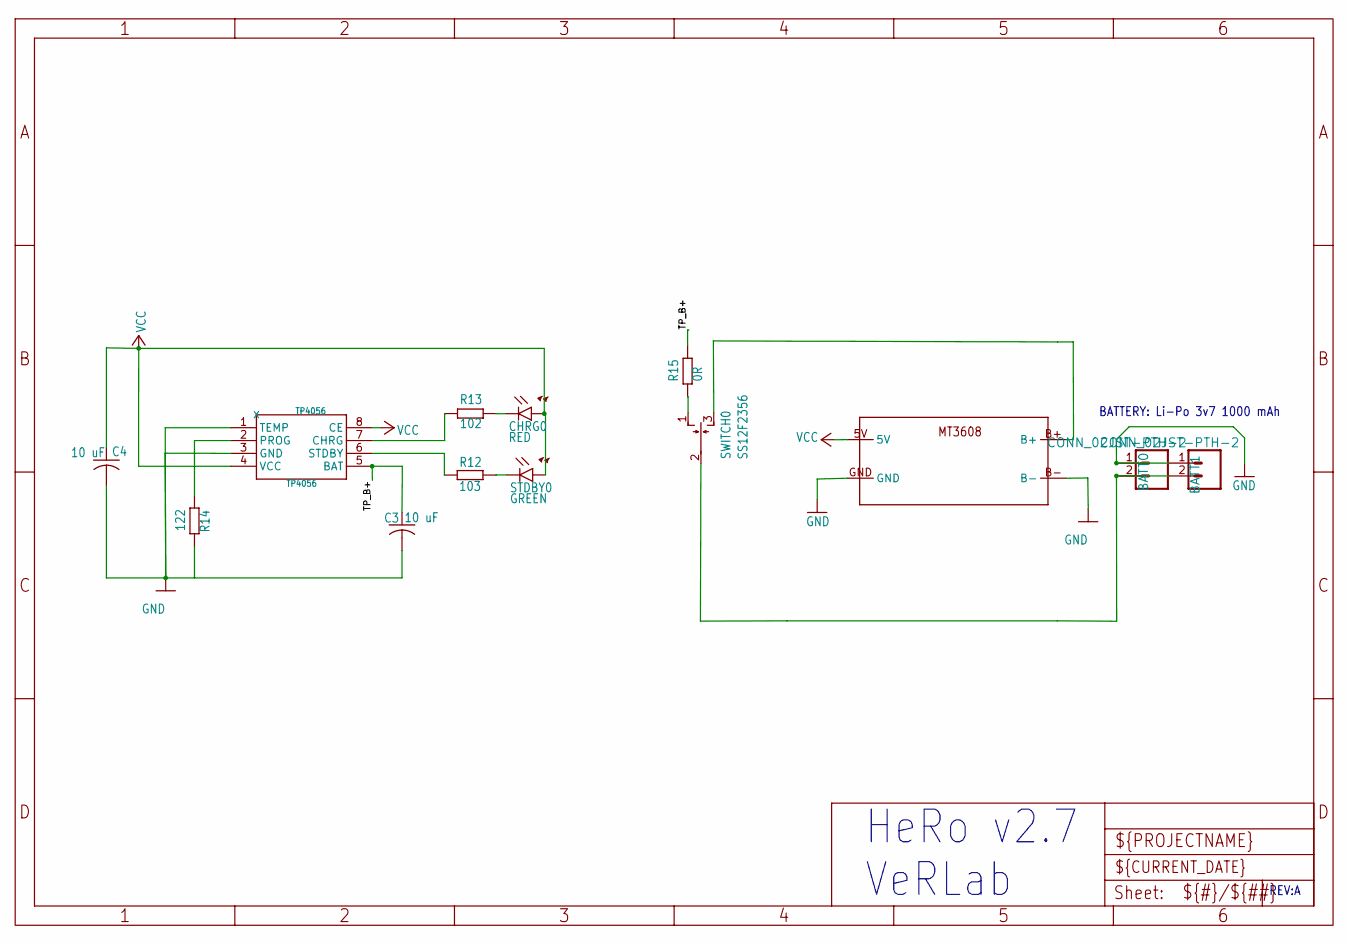
[picture p99: schematic board_4.kicad_sch]

Parts:
BATT0, BATT1: CONN_02JST-PTH-2; JST-2-PTH
C3, C4: 10 uF; C0603_420
CHRG0: RED; SML0805
MT3608: MT3608
R12: 103; R0805
R13: 102; R0805
R14: 122; R0603
R15: 0R; R0805
STDBY0: GREEN; SML0805
SWITCH0: SS12F2356; HH3T90
TP4056: TP4056; SOP

Connections:
/<p>Power Supply</p>/TP_B+: C3.1, R15.2, TP4056.5 (BAT)
GND: BATT0.1, BATT1.1, C3.2, C4.2, MT3608.B-, MT3608.GND, TP4056.1 (TEMP), TP4056.3 (GND); also elsewhere on the board
unnamed: CHRG0.C, R13.2
unnamed: R12.2, STDBY0.C
unnamed: R15.1, SWITCH0.1 (O)
unnamed: BATT0.2, BATT1.2, SWITCH0.2
unnamed: MT3608.B+, SWITCH0.3 (S)
unnamed: R13.1, TP4056.7 (CHRG)
unnamed: R14.2, TP4056.2 (PROG)
unnamed: R12.1, TP4056.6 (STDBY)
VCC: C4.1, CHRG0.A, MT3608.5V, STDBY0.A, TP4056.4 (VCC), TP4056.8 (CE); also elsewhere on the board

Notes on the sheet:
REV:A
HeRo v2.7 VeRLab
BATTERY: Li-Po 3v7 1000 mAh

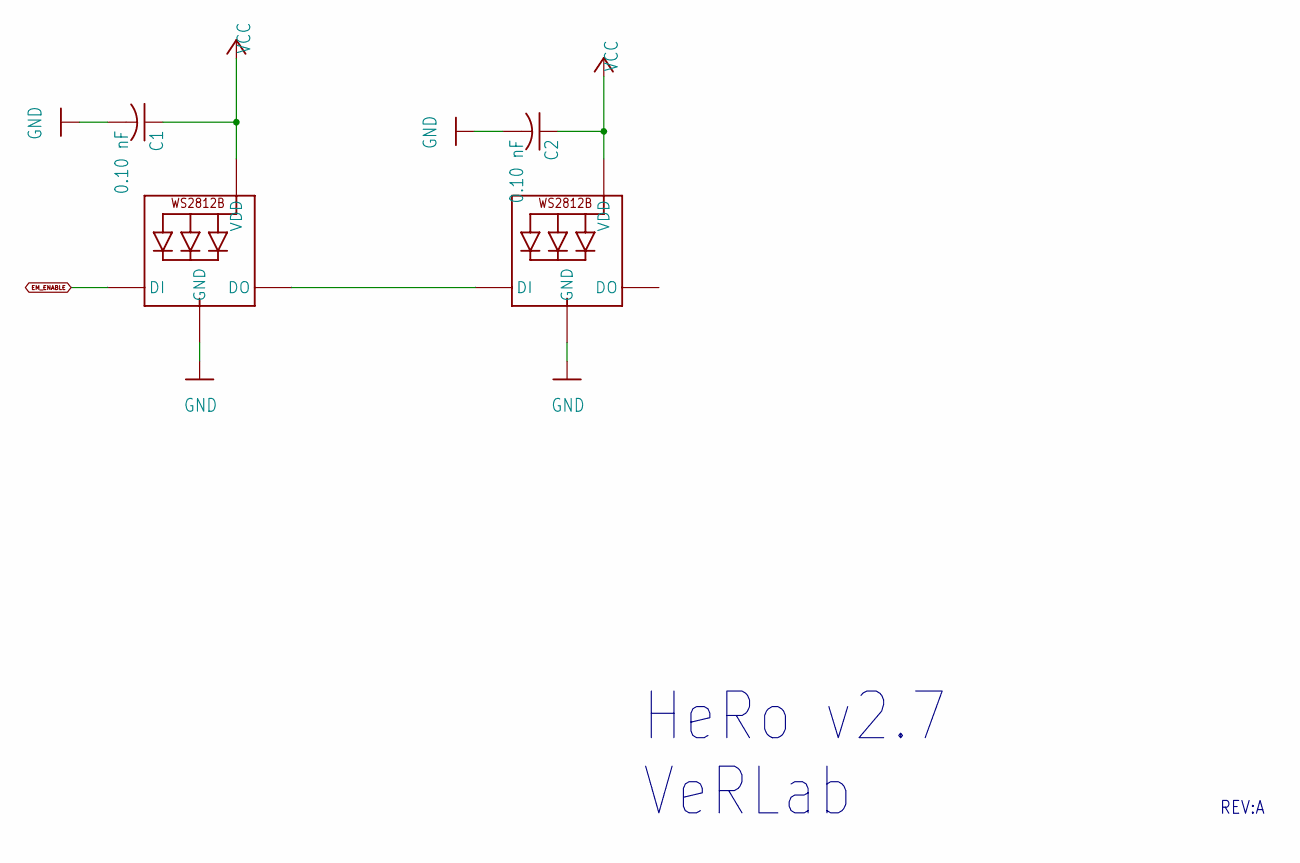
[picture p100: schematic board_3.kicad_sch]

Parts:
C1, C2: 0.10 nF; C0603_348
LED0, LED1: WS2812B5050; WS2812B

Connections:
EM_ENABLE: LED0.4-DIN (DI); also elsewhere on the board
GND: C1.2, C2.2, LED0.3-GND (GND), LED1.3-GND (GND); also elsewhere on the board
unnamed: LED0.2-DOUT (DO), LED1.4-DIN (DI)
VCC: C1.1, C2.1, LED0.1-VDD (VDD), LED1.1-VDD (VDD); also elsewhere on the board

Notes on the sheet:
HeRo v2.7 VeRLab
REV:A

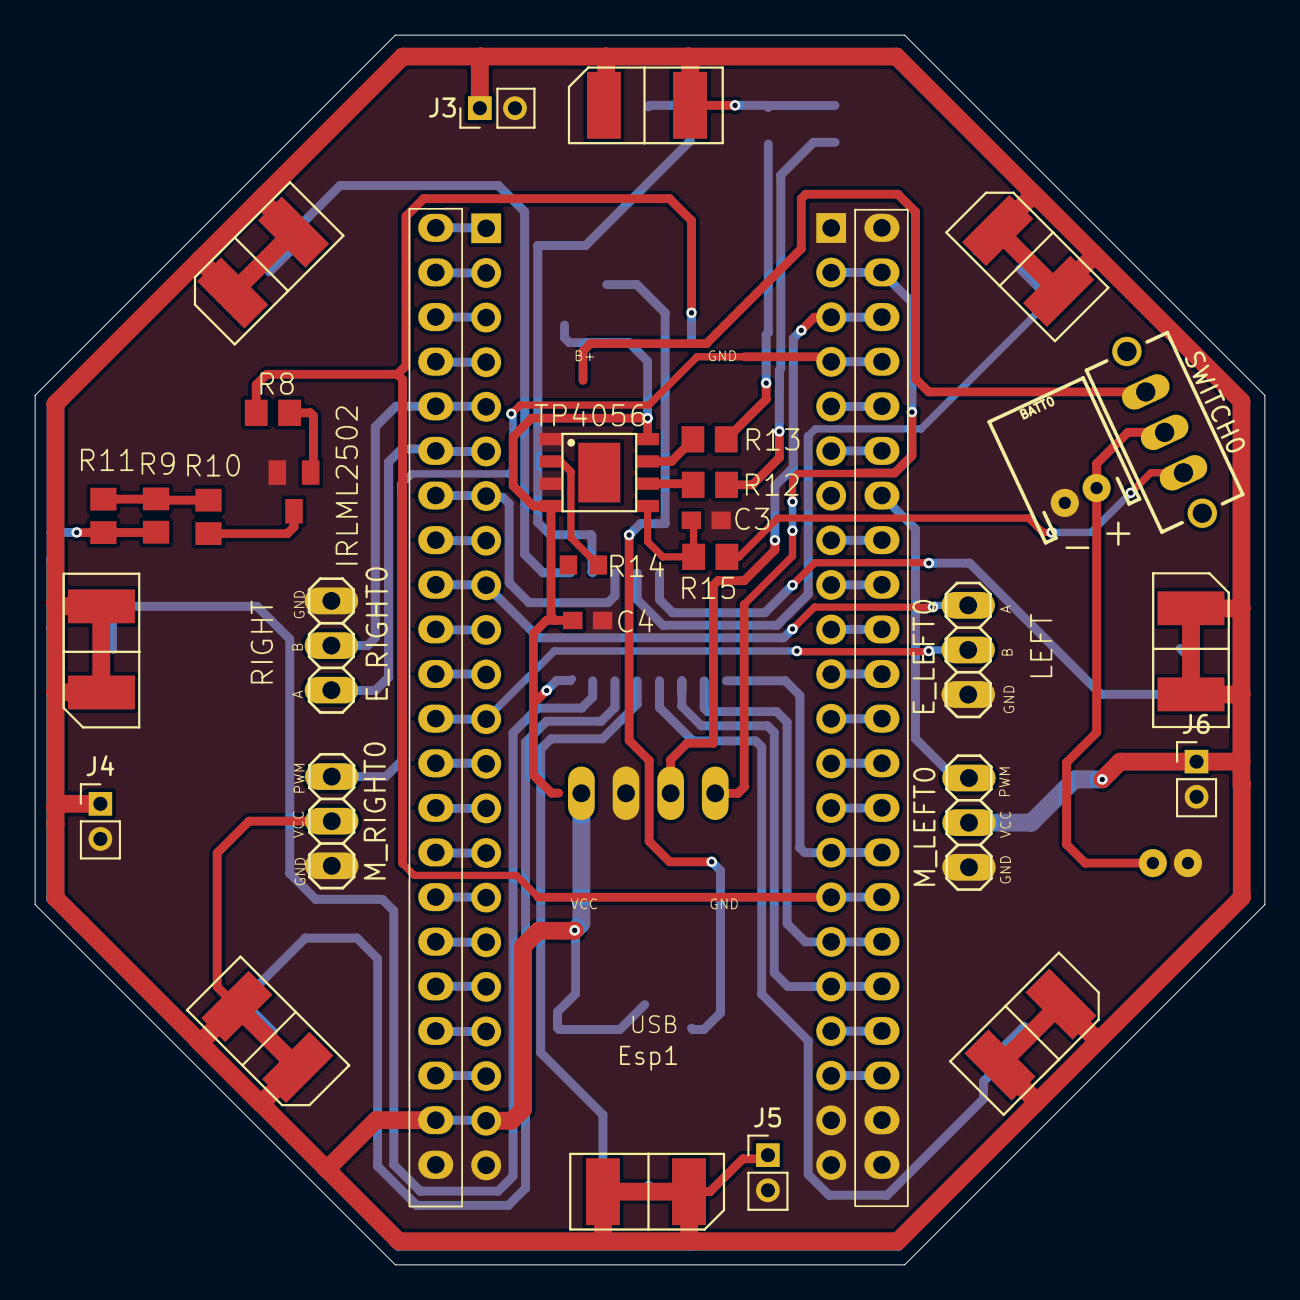
[picture p101: board KiCad/Ant ESP32-S3/board.kicad_pcb from above]

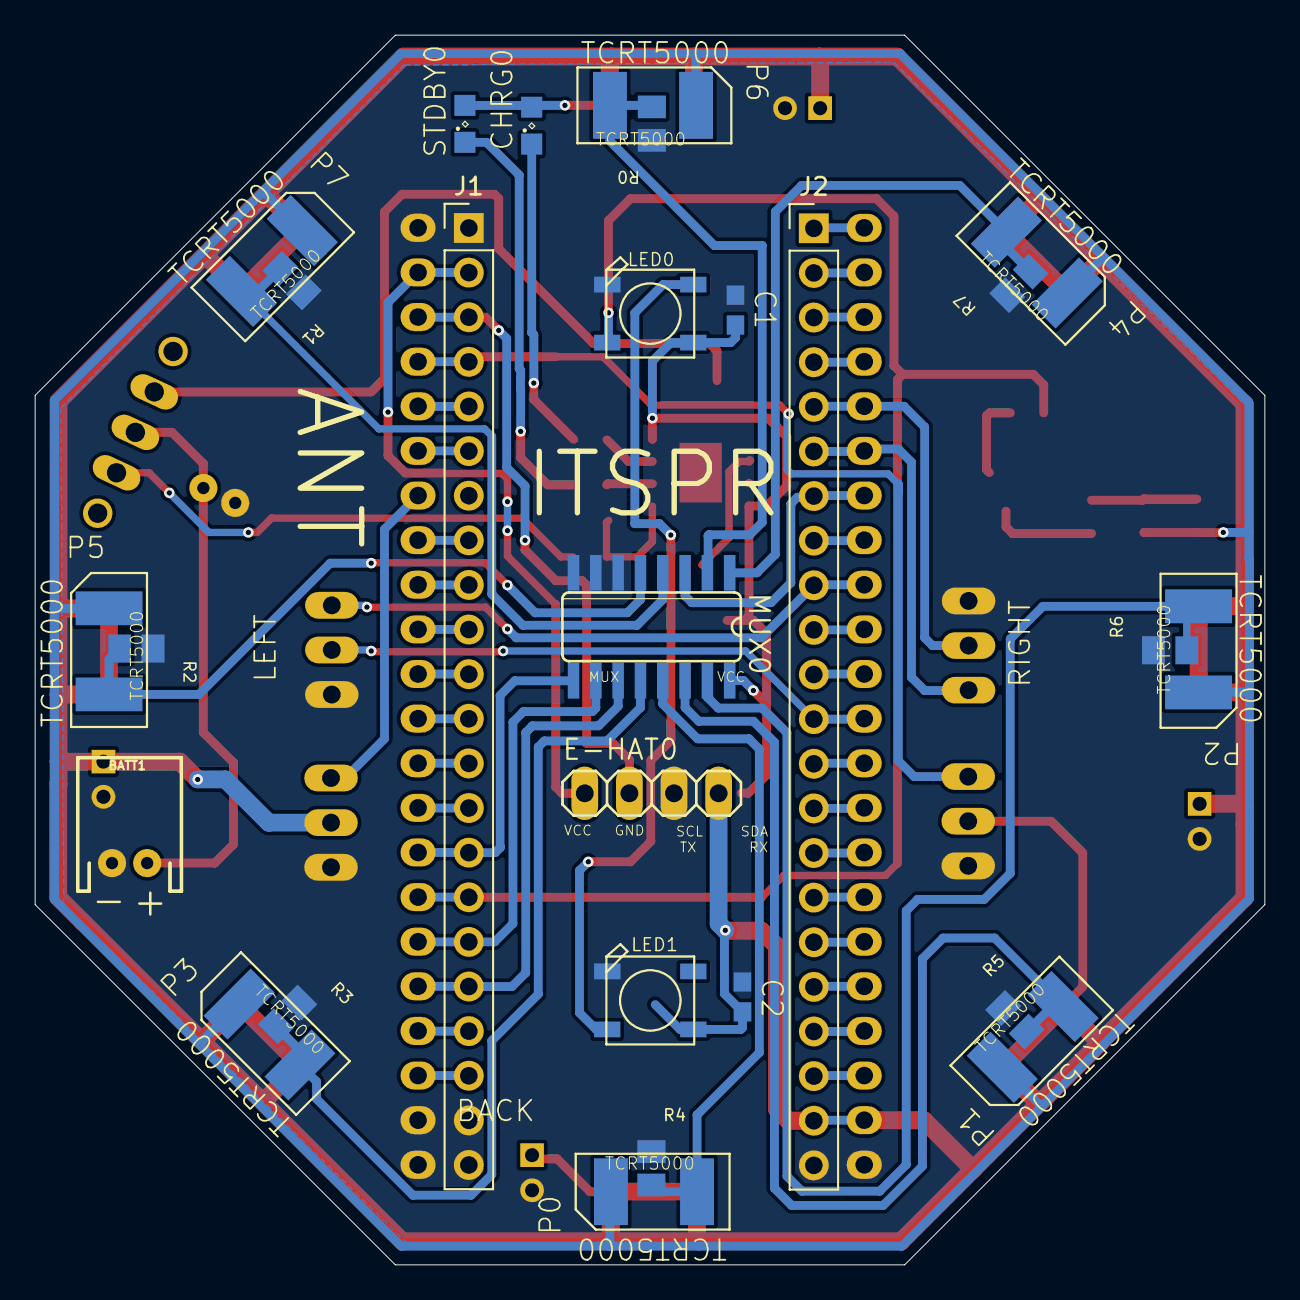
[picture p102: board KiCad/Ant ESP32-S3/board.kicad_pcb from below]

Board: 2 copper layers, 70.0 x 70.0 mm, 50 parts (27 on the bottom side), 62 nets.
