Arttech3d/Hormiga/KiCad/Modulo LIFI/Modulo LIFI.kicad_pcb

## KiCad design KiCad/Modulo LIFI/Modulo LIFI.kicad_pcb (2026-01-14)

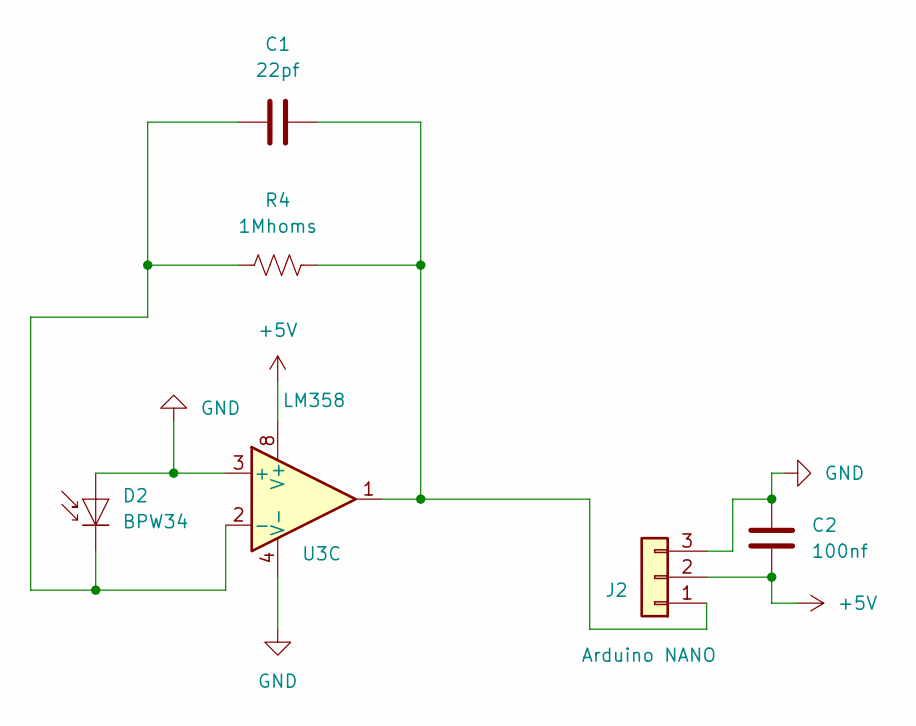
[picture p103: schematic Modulo LIFI.kicad_sch]

Parts:
C1: 22pf; C_Disc_D3.0mm_W1.6mm_P2.50mm
C2: 100nf; C_0805_2012Metric
D2: BPW34; Osram_BPW34S-SMD
J2: Arduino NANO; PinHeader_1x03_P2.54mm_Vertical
R4: 1Mhoms; R_0805_2012Metric_Pad1.20x1.40mm_HandSolder
U3: LM358; SOIC-8_3.9x4.9mm_P1.27mm

Connections:
+5V: C2.1, J2.2, U3.8 (V+)
GND: C2.2, D2.2 (A), J2.3, U3.3 (+), U3.4 (V-)
unnamed: C1.2, D2.1 (K), R4.2, U3.2 (-)
unnamed: C1.1, J2.1, R4.1, U3.1

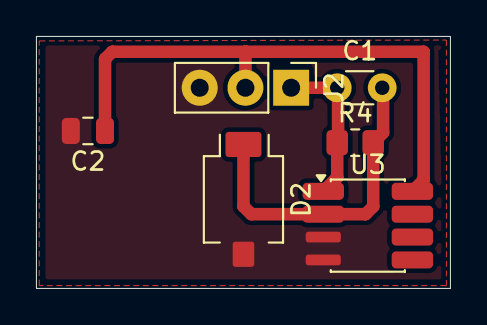
[picture p104: board Modulo LIFI.kicad_pcb from above]

Board: 2 copper layers, 23.0 x 14.0 mm, 6 parts (0 on the bottom side), 4 nets.
