Arttech3d/Hormiga/KiCad/Ant Raspberry PI PICO/board.kicad_pcb

## KiCad design KiCad/Ant Raspberry PI PICO/board.kicad_pcb (2026-01-27)

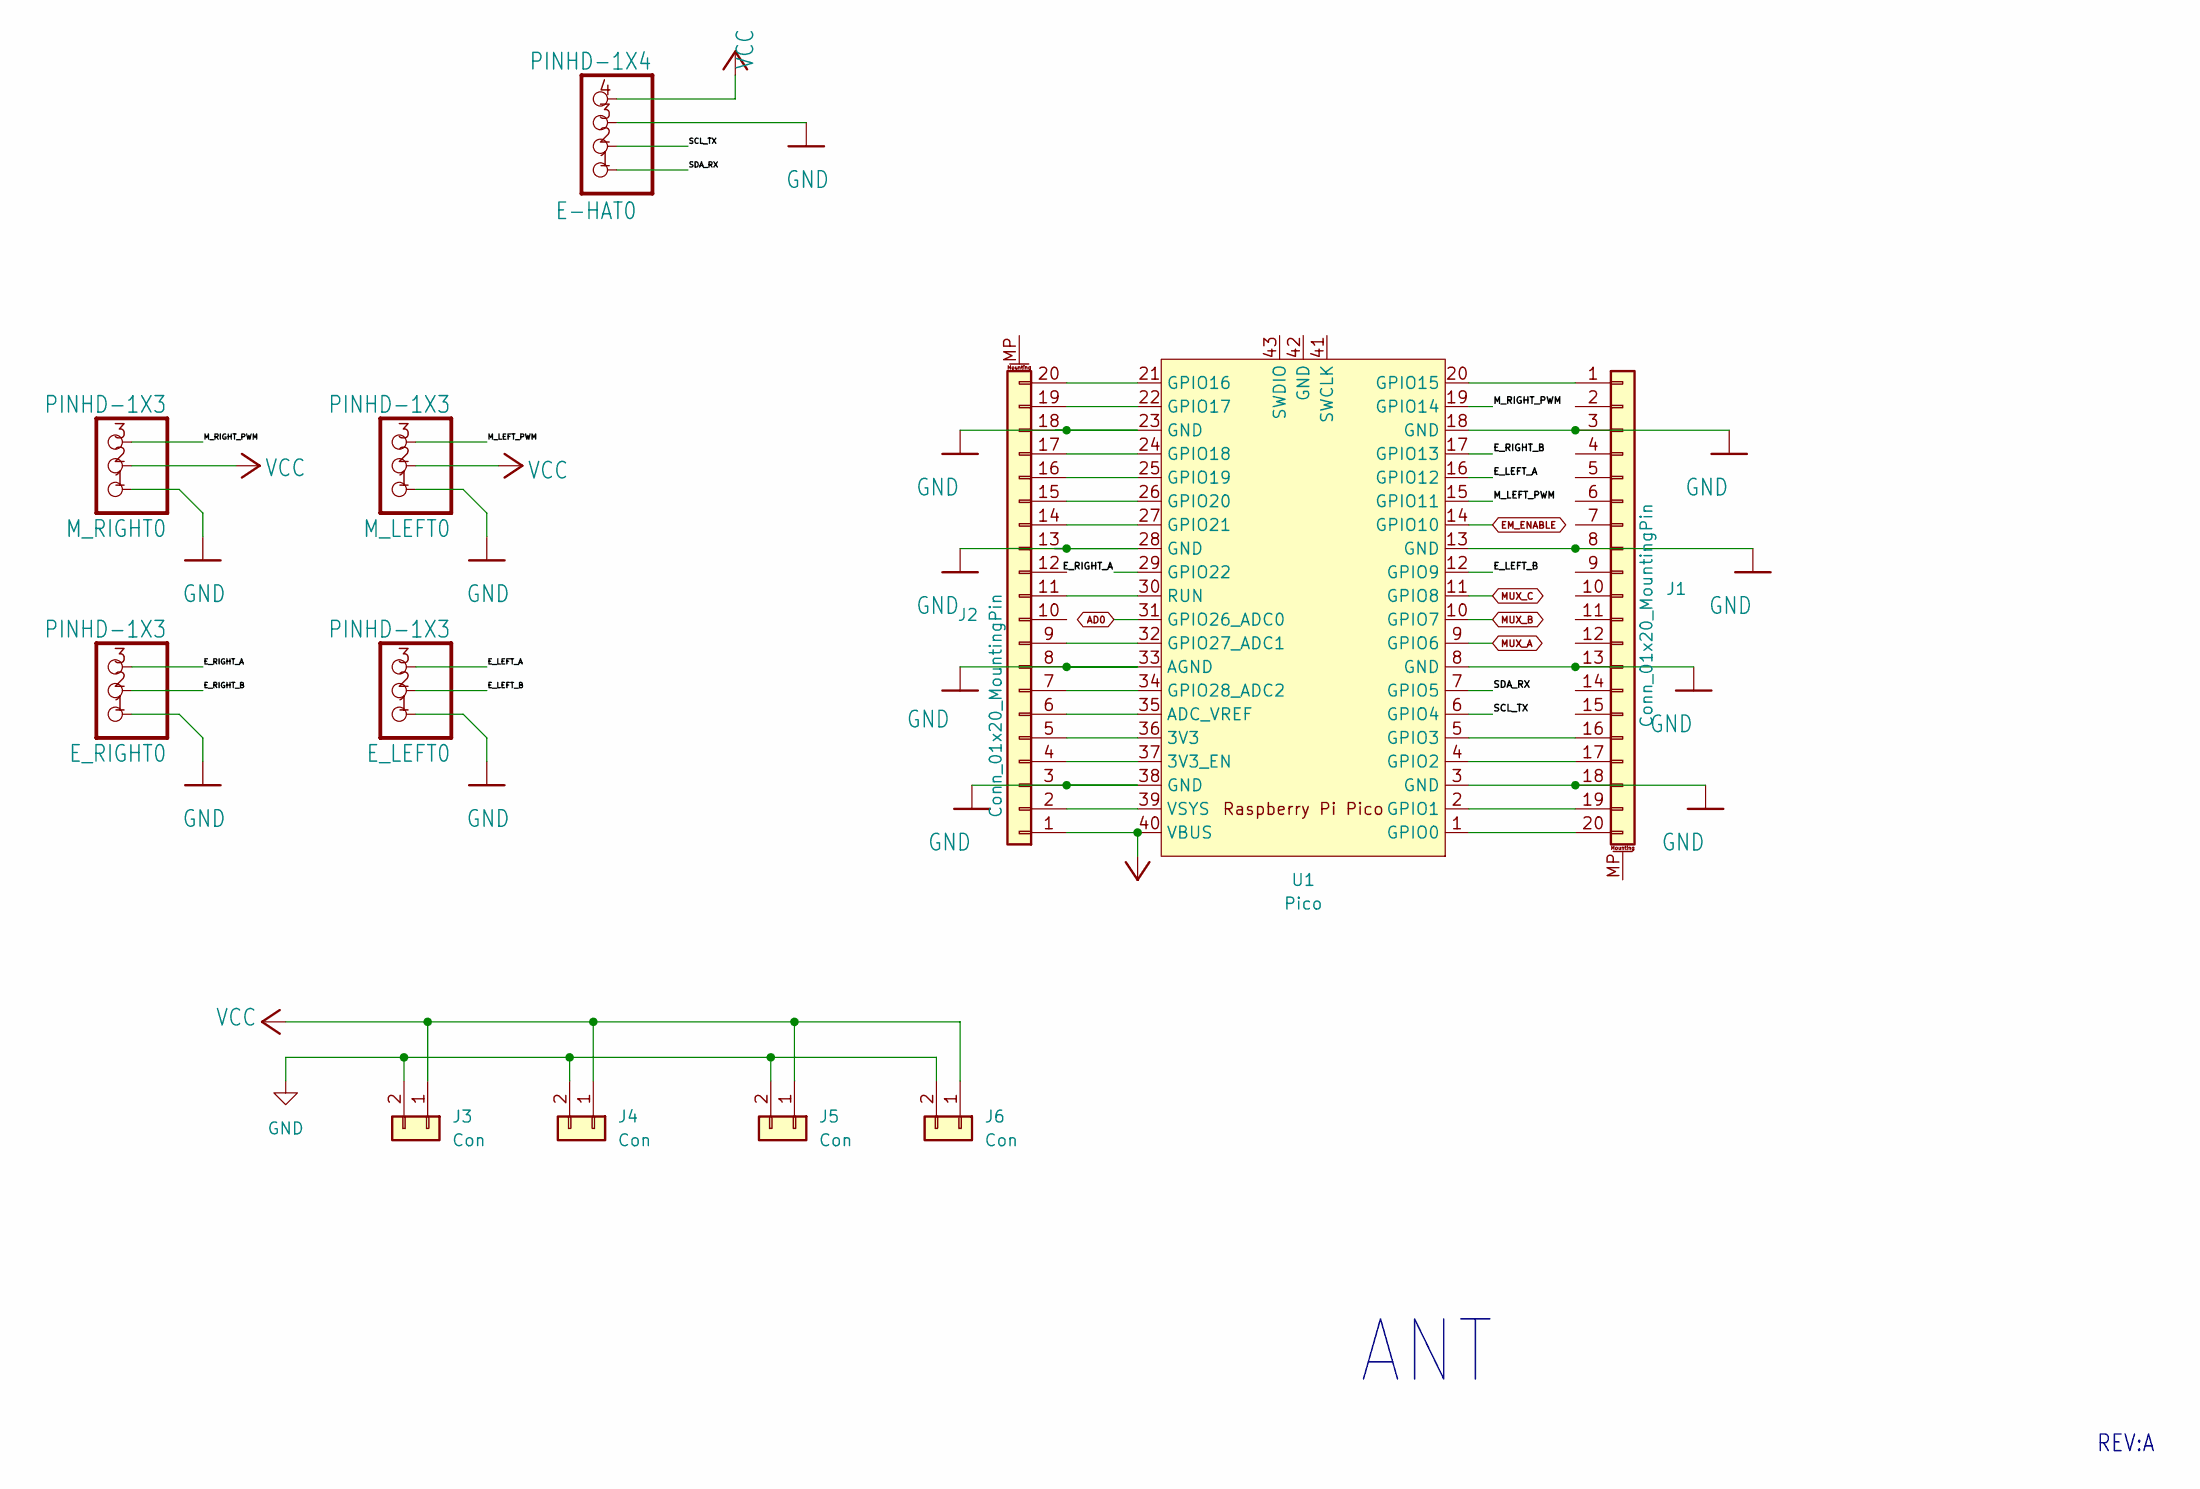
[picture p107: schematic board_1.kicad_sch]

Parts:
E-HAT0: PINHD-1X4; 1X04
E_LEFT0: PINHD-1X3; 1X03
E_RIGHT0: PINHD-1X3; 1X03
J1, J2: Conn_01x20_MountingPin; PinHeader_1x20_P2.54mm_Vertical
J3, J4, J5, J6: Con; PinHeader_1x02_P2.54mm_Vertical
M_LEFT0: PINHD-1X3; 1X03
M_RIGHT0: PINHD-1X3; 1X03
U1: Pico; RPi_Pico_SMD_TH

Connections:
/<p>MCU and Motors</p>/E_LEFT_A: E_LEFT0.3, U1.16 (GPIO12)
/<p>MCU and Motors</p>/E_LEFT_B: E_LEFT0.2, U1.12 (GPIO9)
/<p>MCU and Motors</p>/E_RIGHT_A: E_RIGHT0.3, U1.29 (GPIO22)
/<p>MCU and Motors</p>/E_RIGHT_B: E_RIGHT0.2, U1.17 (GPIO13)
/<p>MCU and Motors</p>/M_LEFT_PWM: M_LEFT0.3, U1.15 (GPIO11)
/<p>MCU and Motors</p>/M_RIGHT_PWM: M_RIGHT0.3, U1.19 (GPIO14)
/<p>MCU and Motors</p>/SCL_TX: E-HAT0.2, U1.6 (GPIO4)
/<p>MCU and Motors</p>/SDA_RX: E-HAT0.1, U1.7 (GPIO5)
AD0: U1.31 (GPIO26_ADC0); also elsewhere on the board
EM_ENABLE: U1.14 (GPIO10); also elsewhere on the board
GND: E-HAT0.3, E_LEFT0.1, E_RIGHT0.1, J1.3, J1.8, J1.13, J1.18, J2.3, J2.8, J2.13, J2.18, J3.2, J4.2, J5.2, J6.2, M_LEFT0.1, M_RIGHT0.1, U1.3 (GND), U1.8 (GND), U1.13 (GND), U1.18 (GND), U1.23 (GND), U1.28 (GND), U1.33 (AGND), U1.38 (GND); also elsewhere on the board
MUX_A: U1.9 (GPIO6); also elsewhere on the board
MUX_B: U1.10 (GPIO7); also elsewhere on the board
MUX_C: U1.11 (GPIO8); also elsewhere on the board
unnamed: J1.1, U1.20 (GPIO15)
unnamed: J1.16, U1.5 (GPIO3)
unnamed: J1.17, U1.4 (GPIO2)
unnamed: J1.19, U1.2 (GPIO1)
unnamed: J1.20, U1.1 (GPIO0)
unnamed: J2.2, U1.39 (VSYS)
unnamed: J2.4, U1.37 (3V3_EN)
unnamed: J2.5, U1.36 (3V3)
unnamed: J2.6, U1.35 (ADC_VREF)
unnamed: J2.7, U1.34 (GPIO28_ADC2)
unnamed: J2.9, U1.32 (GPIO27_ADC1)
unnamed: J2.11, U1.30 (RUN)
unnamed: J2.14, U1.27 (GPIO21)
unnamed: J2.15, U1.26 (GPIO20)
unnamed: J2.16, U1.25 (GPIO19)
unnamed: J2.17, U1.24 (GPIO18)
unnamed: J2.19, U1.22 (GPIO17)
unnamed: J2.20, U1.21 (GPIO16)
VCC: E-HAT0.4, J2.1, J3.1, J4.1, J5.1, J6.1, M_LEFT0.2, M_RIGHT0.2, U1.40 (VBUS); also elsewhere on the board

Notes on the sheet:
ANT
REV:A

Schematic: board_2.kicad_sch

Parts:
IRLML2502: MOSFET-NREFLOW; SOT23
MUX0: 4051D; SO16
P0, P1, P2, P3, P4, P5, P6, P7: TCRT5000
R0, R1, R2, R3, R4, R5, R6, R7: 4k7; M0805
R8: 4k7; R0805
R9: 0R; R0805
R10: 18R; R0805
R11: NM; R0805

Connections:
/<p>Proximity Sensors</p>/EM: P0.K (CATHODE), P1.K (CATHODE), P2.K (CATHODE), P3.K (CATHODE), P4.K (CATHODE), P5.K (CATHODE), P6.K (CATHODE), P7.K (CATHODE), R9.2, R11.2
/<p>Proximity Sensors</p>/MUX_X0: MUX0.13 (X0), P0.E (EMITTER), R4.1
/<p>Proximity Sensors</p>/MUX_X1: MUX0.14 (X1), P1.E (EMITTER), R5.1
/<p>Proximity Sensors</p>/MUX_X2: MUX0.15 (X2), P2.E (EMITTER), R6.1
/<p>Proximity Sensors</p>/MUX_X3: MUX0.12 (X3), P3.E (EMITTER), R3.1
/<p>Proximity Sensors</p>/MUX_X4: MUX0.1 (X4), P4.E (EMITTER), R7.1
/<p>Proximity Sensors</p>/MUX_X5: MUX0.5 (X5), P5.E (EMITTER), R2.1
/<p>Proximity Sensors</p>/MUX_X6: MUX0.2 (X6), P6.E (EMITTER), R0.1
/<p>Proximity Sensors</p>/MUX_X7: MUX0.4 (X7), P7.E (EMITTER), R1.1
AD0: MUX0.3 (X); also elsewhere on the board
EM_ENABLE: R8.2; also elsewhere on the board
GND: IRLML2502.2 (S), MUX0.6 (INH), MUX0.7 (VEE), MUX0.8 (GND), R0.2, R1.2, R2.2, R3.2, R4.2, R5.2, R6.2, R7.2; also elsewhere on the board
MUX_A: MUX0.11 (A); also elsewhere on the board
MUX_B: MUX0.10 (B); also elsewhere on the board
MUX_C: MUX0.9 (C); also elsewhere on the board
unnamed: IRLML2502.3 (D), R10.1
unnamed: IRLML2502.1 (G), R8.1
unnamed: R9.1, R10.2, R11.1
VCC: MUX0.16 (VCC), P0.A (ANODE), P0.C (COLLECTOR), P1.A (ANODE), P1.C (COLLECTOR), P2.A (ANODE), P2.C (COLLECTOR), P3.A (ANODE), P3.C (COLLECTOR), P4.A (ANODE), P4.C (COLLECTOR), P5.A (ANODE), P5.C (COLLECTOR), P6.A (ANODE), P6.C (COLLECTOR), P7.A (ANODE), P7.C (COLLECTOR); also elsewhere on the board

Notes on the sheet:
HeRo v2.7 VeRLab
REV:A

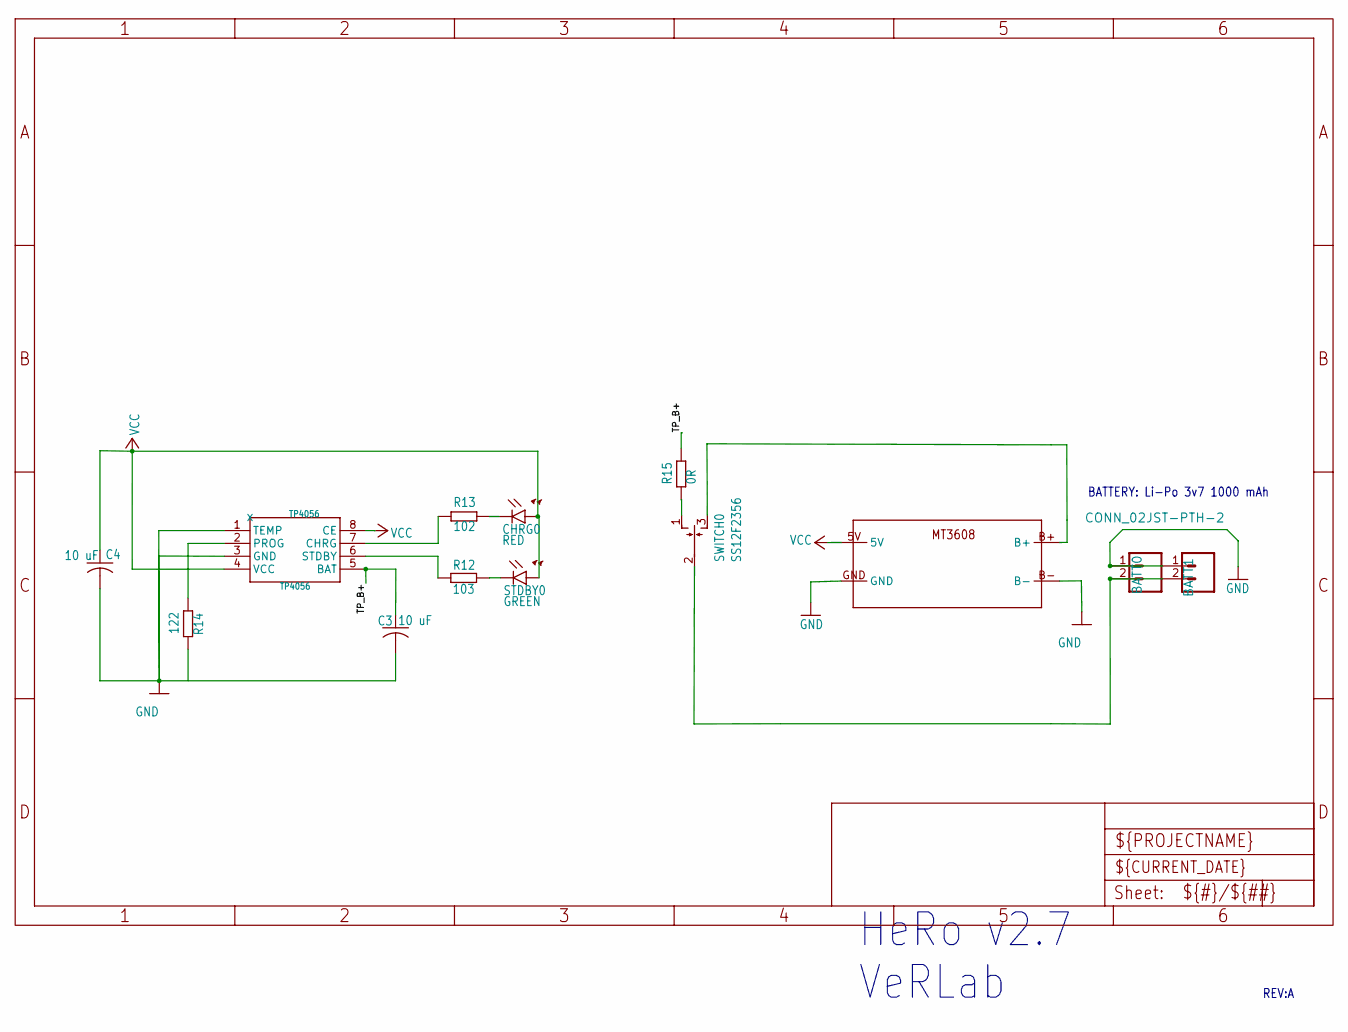
[picture p108: schematic board_4.kicad_sch]

Parts:
BATT0, BATT1: CONN_02JST-PTH-2; JST-2-PTH
C3, C4: 10 uF; C0603_420
CHRG0: RED; SML0805
MT3608: MT3608
R12: 103; R0805
R13: 102; R0805
R14: 122; R0603
R15: 0R; R0805
STDBY0: GREEN; SML0805
SWITCH0: SS12F2356; HH3T90
TP4056: TP4056; SOP

Connections:
/<p>Power Supply</p>/TP_B+: C3.1, R15.2, TP4056.5 (BAT)
GND: BATT0.1, BATT1.1, C3.2, C4.2, MT3608.B-, MT3608.GND, TP4056.1 (TEMP), TP4056.3 (GND); also elsewhere on the board
unnamed: CHRG0.C, R13.2
unnamed: R12.2, STDBY0.C
unnamed: R15.1, SWITCH0.1 (O)
unnamed: BATT0.2, BATT1.2, SWITCH0.2
unnamed: MT3608.B+, SWITCH0.3 (S)
unnamed: R13.1, TP4056.7 (CHRG)
unnamed: R14.2, TP4056.2 (PROG)
unnamed: R12.1, TP4056.6 (STDBY)
VCC: C4.1, CHRG0.A, MT3608.5V, STDBY0.A, TP4056.4 (VCC), TP4056.8 (CE); also elsewhere on the board

Notes on the sheet:
REV:A
HeRo v2.7 VeRLab
BATTERY: Li-Po 3v7 1000 mAh

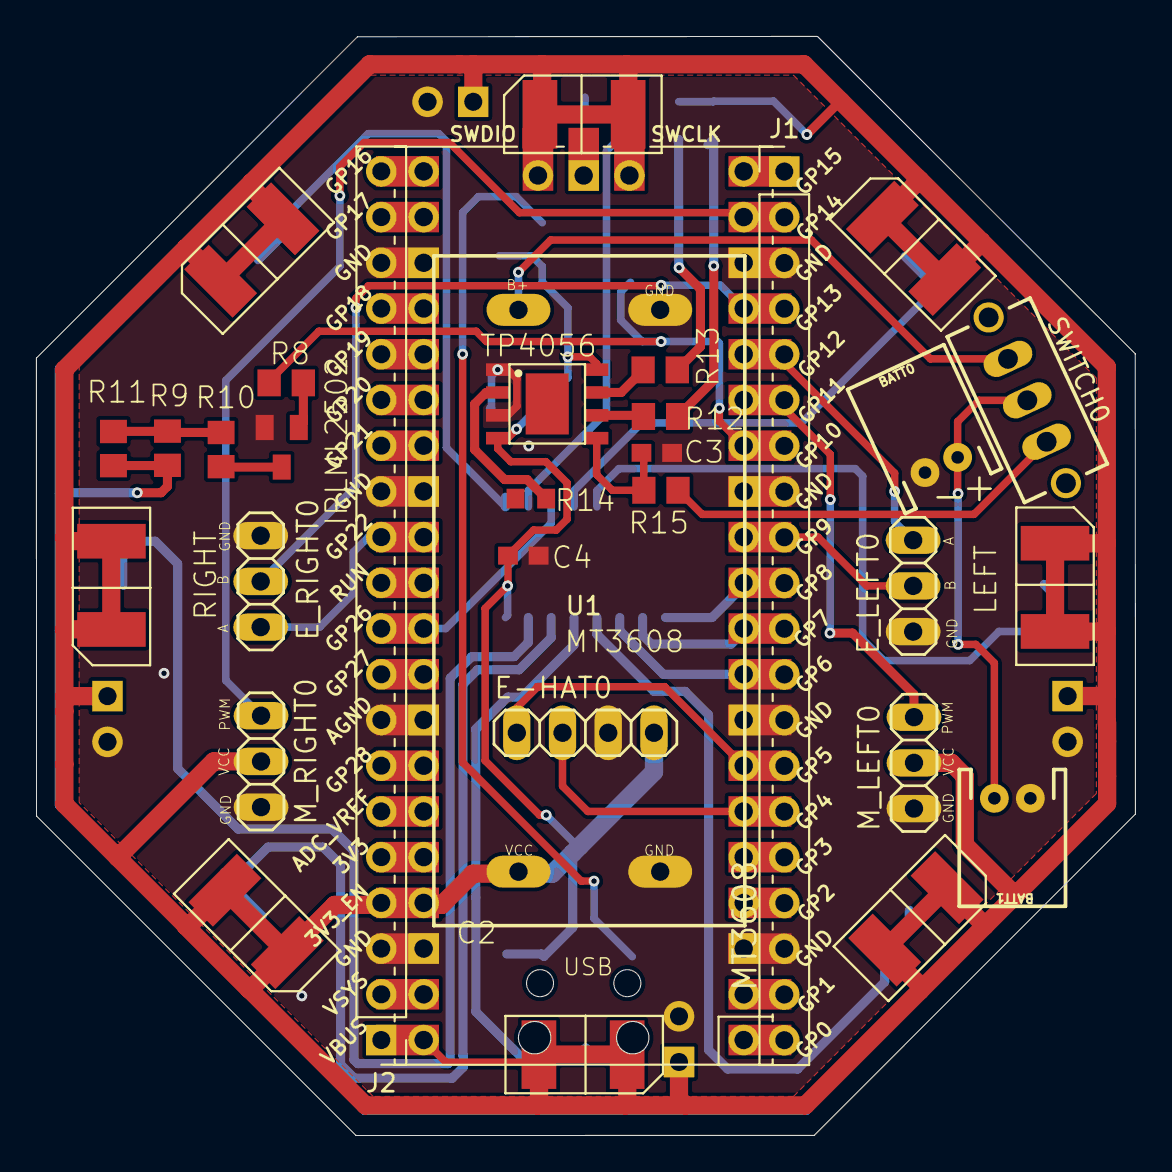
[picture p109: board KiCad/Ant Raspberry PI PICO/board.kicad_pcb from above]

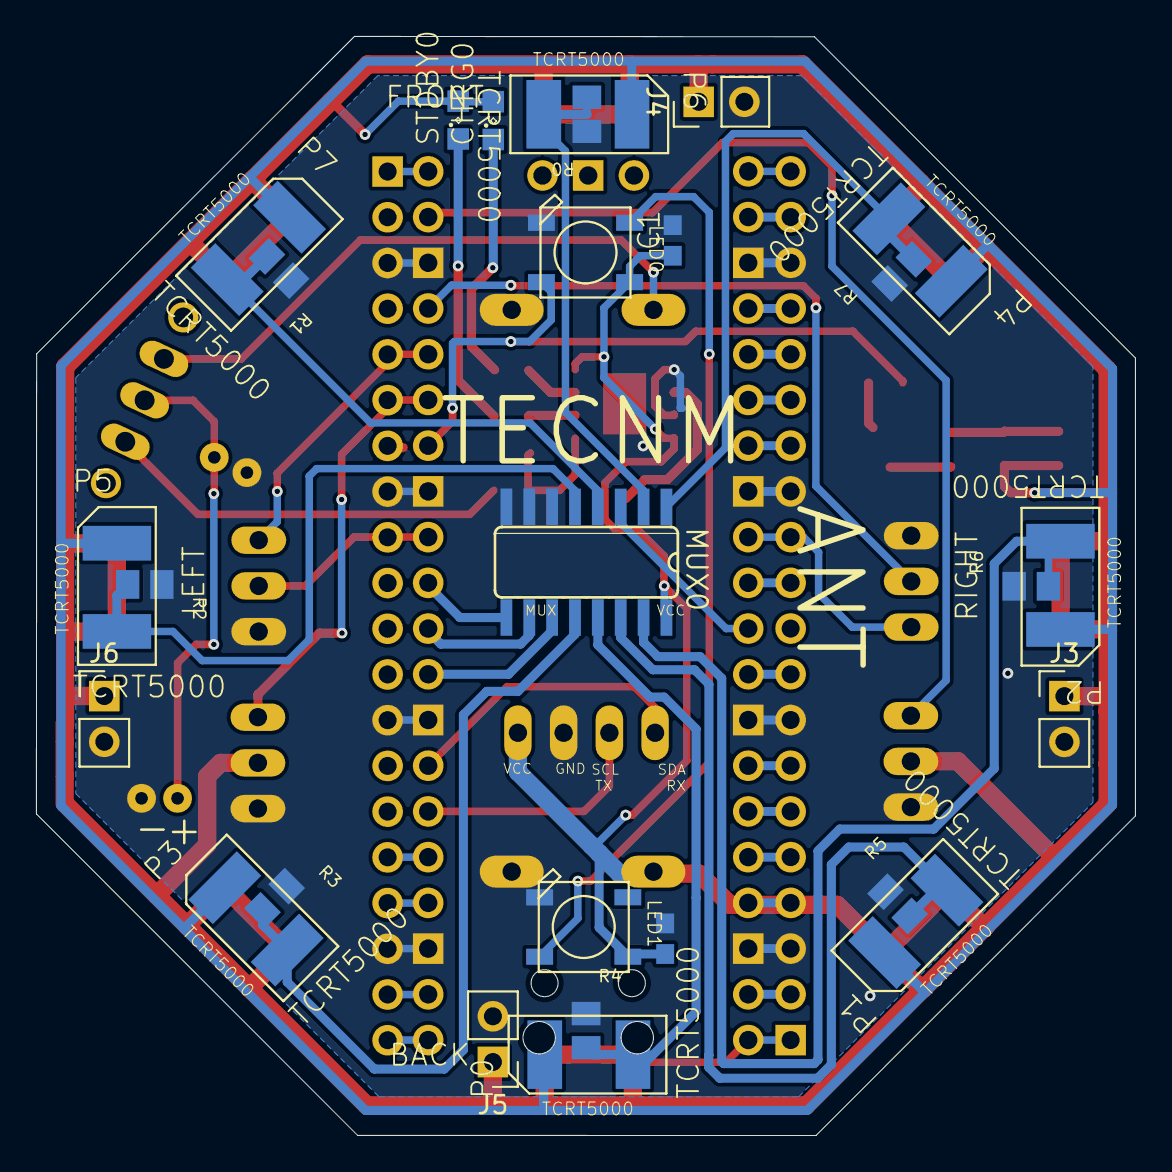
[picture p110: board KiCad/Ant Raspberry PI PICO/board.kicad_pcb from below]

Board: 2 copper layers, 61.1 x 61.1 mm, 51 parts (27 on the bottom side), 55 nets.

Other parts of the board:
C1, C2: 0.10 nF; C0603_348
LED0, LED1: WS2812B5050; WS2812B

Their connections:
EM_ENABLE: LED0.4-DIN (DI); also elsewhere on the board
GND: C1.2, C2.2, LED0.3-GND (GND), LED1.3-GND (GND); also elsewhere on the board
unnamed: LED0.2-DOUT (DO), LED1.4-DIN (DI)
VCC: C1.1, C2.1, LED0.1-VDD (VDD), LED1.1-VDD (VDD); also elsewhere on the board
