Arttech3d/Hormiga/KiCad/Ant ESP32-S3/board.brd

## EAGLE design KiCad/Ant ESP32-S3/board.brd (2025-12-08)

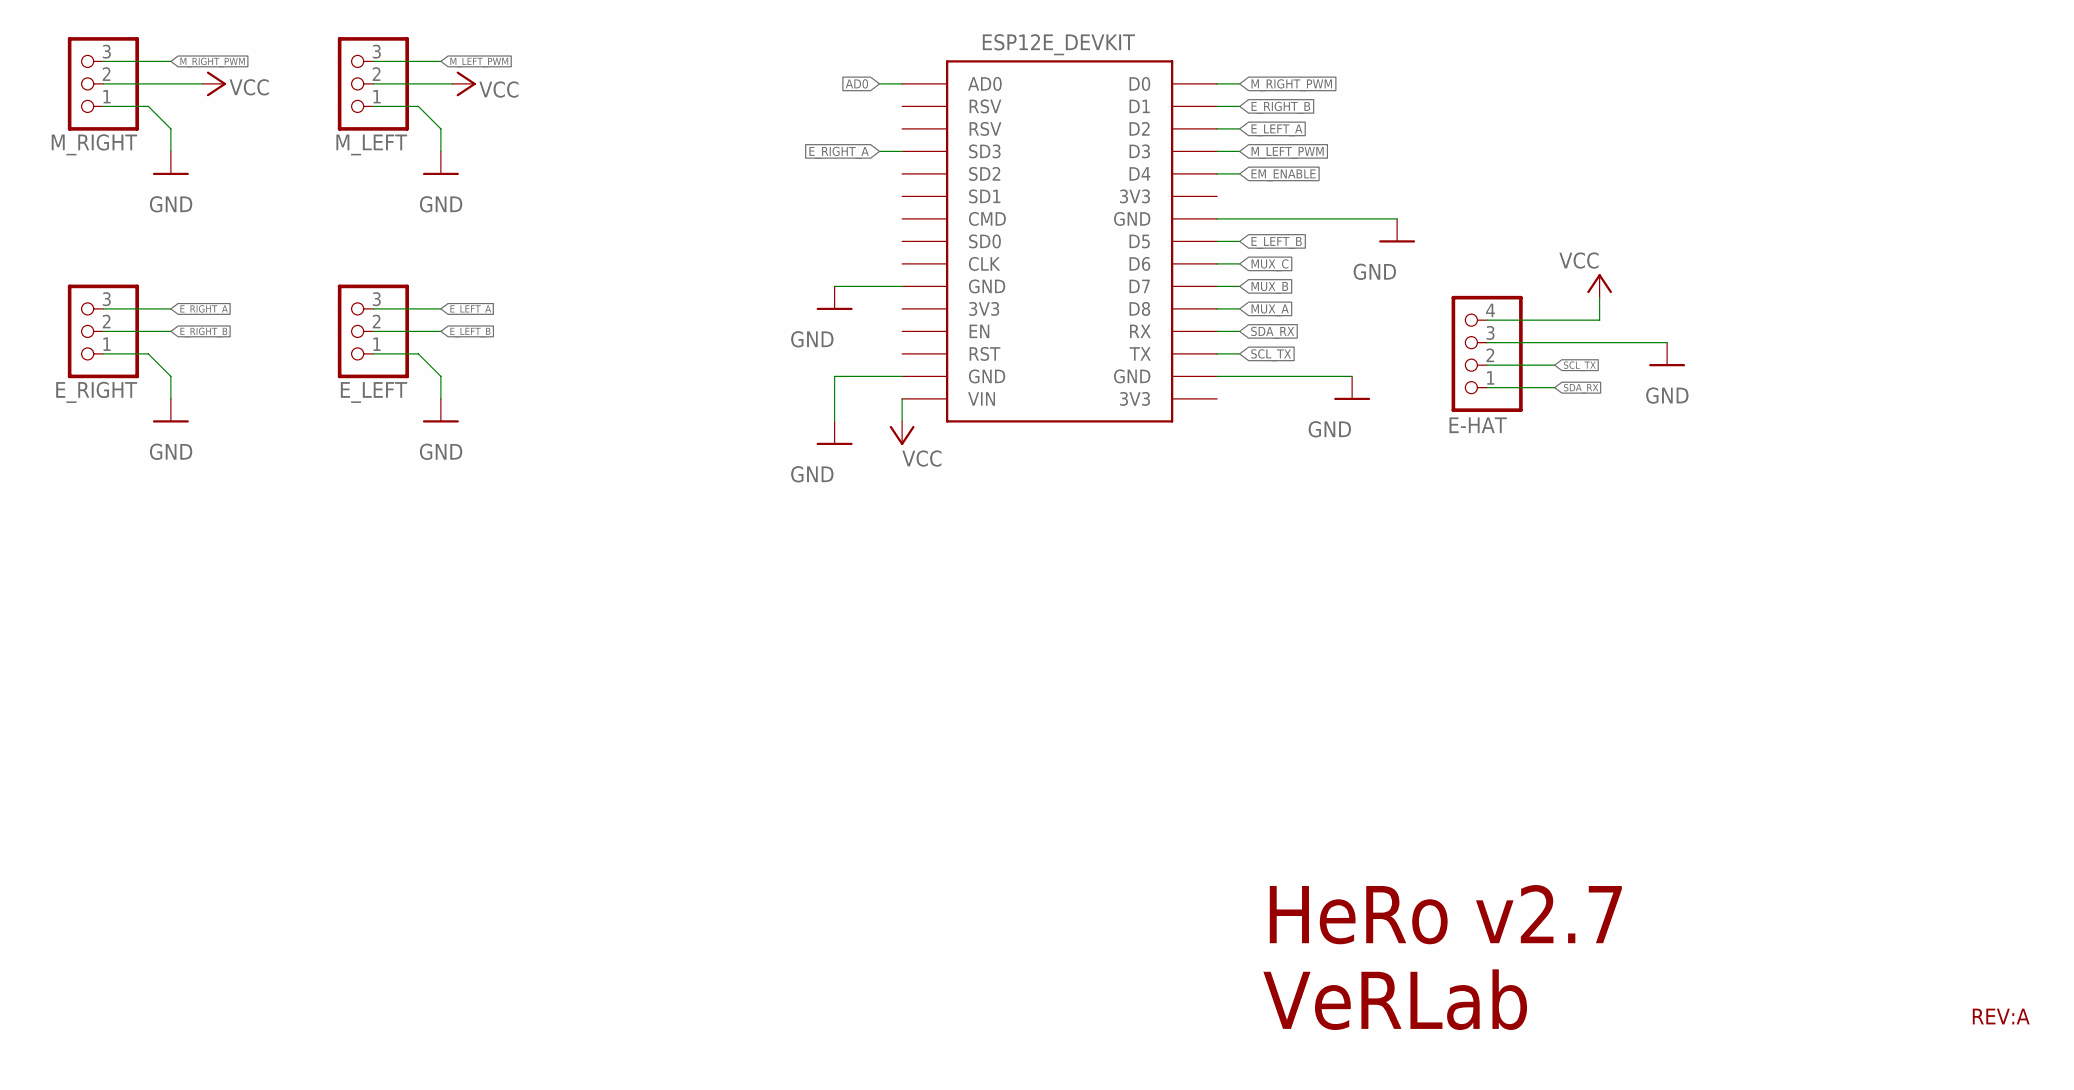
[picture p111: schematic board.sch, sheet 1, <p>MCU and Motors</p>]

Parts:
E-HAT: PINHD-1X4; 1X04
ESP-12E: ESP12E_DEVKIT
E_LEFT: PINHD-1X3; 1X03
E_RIGHT: PINHD-1X3; 1X03
M_LEFT: PINHD-1X3; 1X03
M_RIGHT: PINHD-1X3; 1X03

Connections:
AD0: ESP-12E.AD0; also elsewhere on the board
EM_ENABLE: ESP-12E.D4; also elsewhere on the board
E_LEFT_A: ESP-12E.D2, E_LEFT.3
E_LEFT_B: ESP-12E.D5, E_LEFT.2
E_RIGHT_A: ESP-12E.SD3, E_RIGHT.3
E_RIGHT_B: ESP-12E.D1, E_RIGHT.2
GND: E-HAT.3, ESP-12E.GND@0 (GND), ESP-12E.GND@1 (GND), ESP-12E.GND@2 (GND), ESP-12E.GND@3 (GND), E_LEFT.1, E_RIGHT.1, M_LEFT.1, M_RIGHT.1; also elsewhere on the board
MUX_A: ESP-12E.D8; also elsewhere on the board
MUX_B: ESP-12E.D7; also elsewhere on the board
MUX_C: ESP-12E.D6; also elsewhere on the board
M_LEFT_PWM: ESP-12E.D3, M_LEFT.3
M_RIGHT_PWM: ESP-12E.D0, M_RIGHT.3
SCL_TX: E-HAT.2, ESP-12E.TX
SDA_RX: E-HAT.1, ESP-12E.RX
VCC: E-HAT.4, ESP-12E.VIN, M_LEFT.2, M_RIGHT.2; also elsewhere on the board

Notes on the sheet:
HeRo v2.7 VeRLab
REV:A

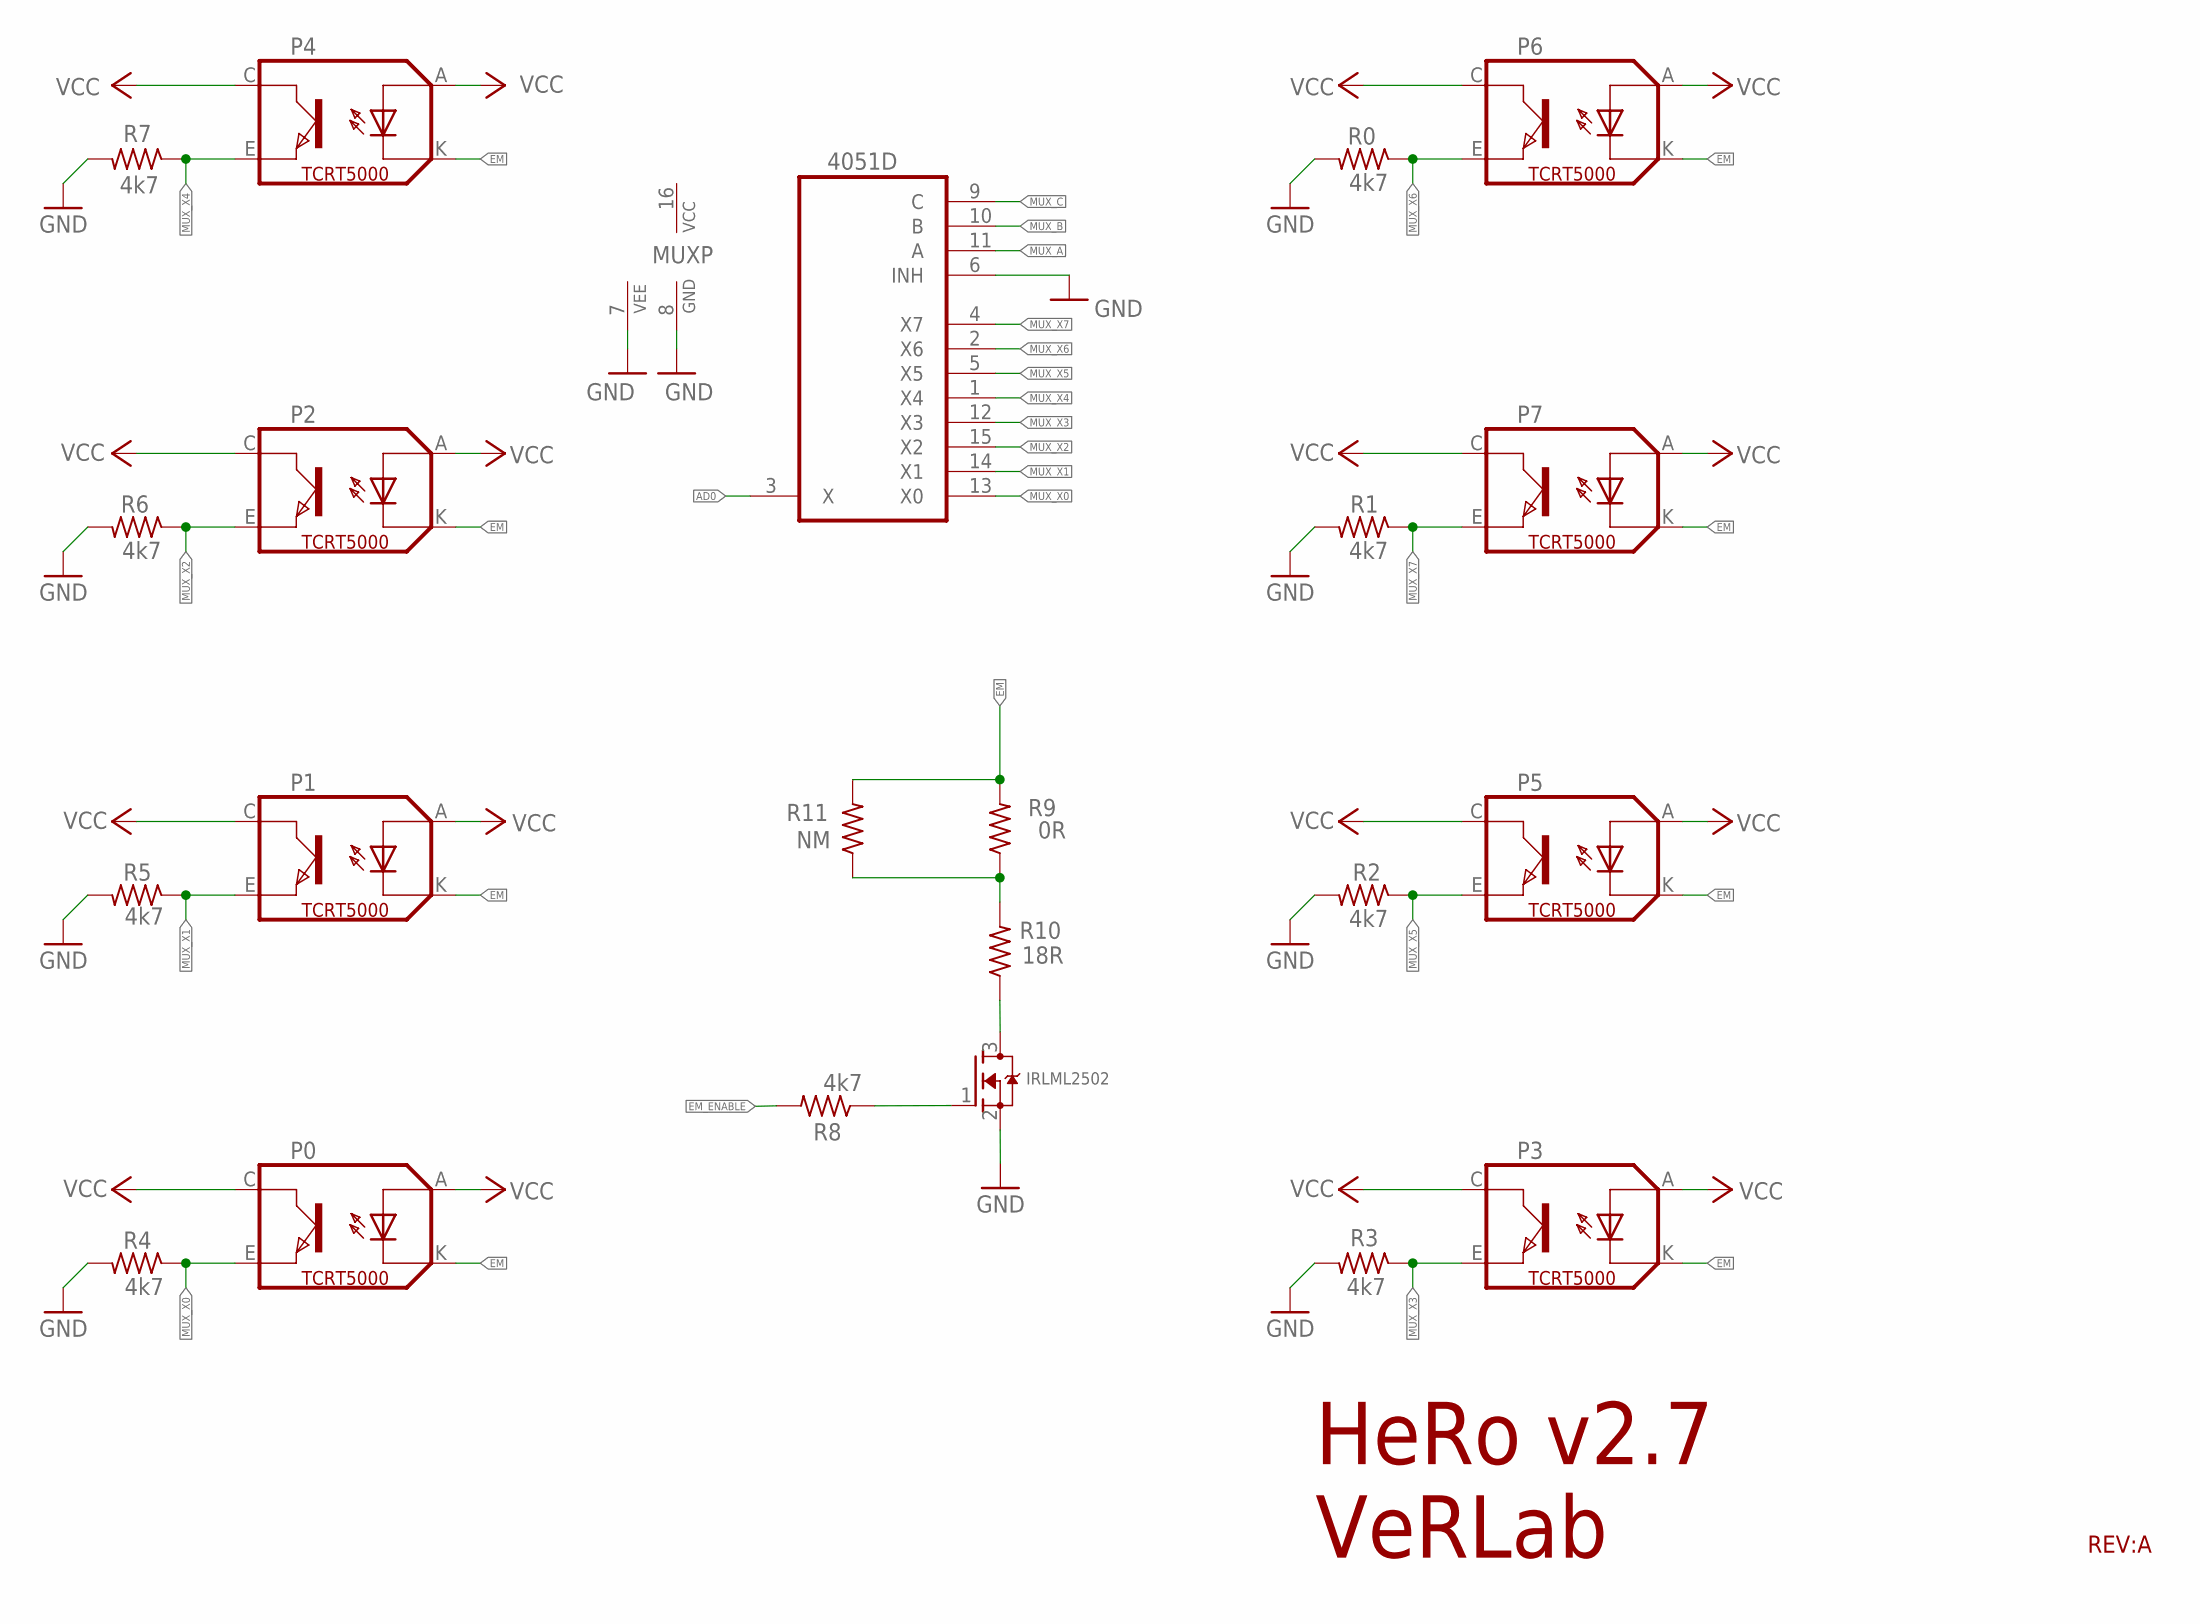
[picture p112: schematic board.sch, sheet 2, <p>Proximity Sensors</p>]

Parts:
IRLML2502: MOSFET-NREFLOW; SOT23
MUX: 4051D; SO16
P0, P1, P2, P3, P4, P5, P6, P7: TCRT5000
R0, R1, R2, R3, R4, R5, R6, R7: 4k7; M0805
R8: 4k7; R0805
R9: 0R; R0805
R10: 18R; R0805
R11: NM; R0805

Connections:
AD0: MUX.3 (X); also elsewhere on the board
EM: P0.K (CATHODE), P1.K (CATHODE), P2.K (CATHODE), P3.K (CATHODE), P4.K (CATHODE), P5.K (CATHODE), P6.K (CATHODE), P7.K (CATHODE), R9.2, R11.2
EM_ENABLE: R8.2; also elsewhere on the board
GND: IRLML2502.2 (S), MUX.6 (INH), MUX.7 (VEE), MUX.8 (GND), R0.2, R1.2, R2.2, R3.2, R4.2, R5.2, R6.2, R7.2; also elsewhere on the board
MUX_A: MUX.11 (A); also elsewhere on the board
MUX_B: MUX.10 (B); also elsewhere on the board
MUX_C: MUX.9 (C); also elsewhere on the board
MUX_X0: MUX.13 (X0), P0.E (EMITTER), R4.1
MUX_X1: MUX.14 (X1), P1.E (EMITTER), R5.1
MUX_X2: MUX.15 (X2), P2.E (EMITTER), R6.1
MUX_X3: MUX.12 (X3), P3.E (EMITTER), R3.1
MUX_X4: MUX.1 (X4), P4.E (EMITTER), R7.1
MUX_X5: MUX.5 (X5), P5.E (EMITTER), R2.1
MUX_X6: MUX.2 (X6), P6.E (EMITTER), R0.1
MUX_X7: MUX.4 (X7), P7.E (EMITTER), R1.1
unnamed: IRLML2502.3 (D), R10.1
unnamed: R9.1, R10.2, R11.1
unnamed: IRLML2502.1 (G), R8.1
VCC: MUX.16 (VCC), P0.A (ANODE), P0.C (COLLECTOR), P1.A (ANODE), P1.C (COLLECTOR), P2.A (ANODE), P2.C (COLLECTOR), P3.A (ANODE), P3.C (COLLECTOR), P4.A (ANODE), P4.C (COLLECTOR), P5.A (ANODE), P5.C (COLLECTOR), P6.A (ANODE), P6.C (COLLECTOR), P7.A (ANODE), P7.C (COLLECTOR); also elsewhere on the board

Notes on the sheet:
HeRo v2.7 VeRLab
REV:A

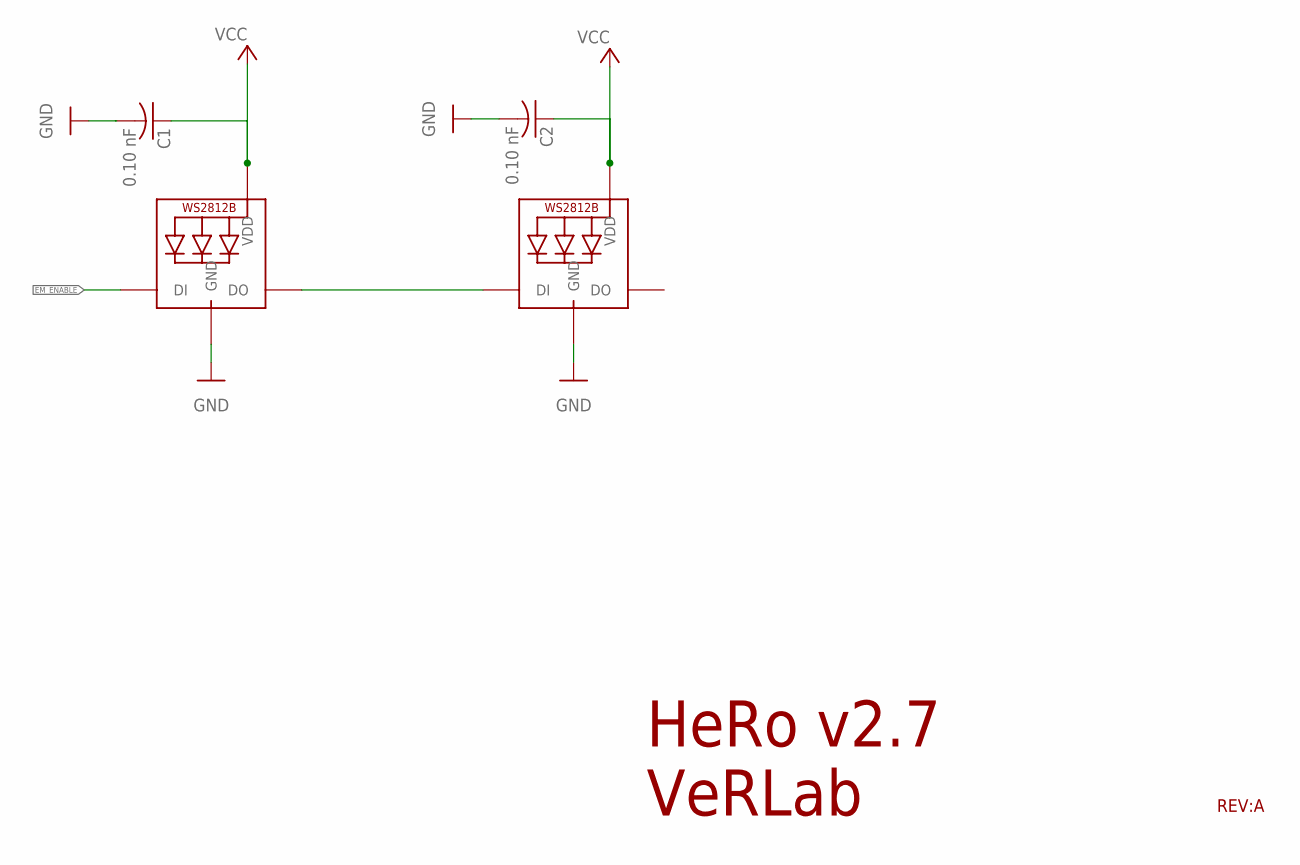
[picture p113: schematic board.sch, sheet 3, <p> LED RGB</p>]

Parts:
C1, C2: 0.10 nF; C0603
LED0, LED1: WS2812B5050; WS2812B

Connections:
EM_ENABLE: LED0.4-DIN (DI); also elsewhere on the board
GND: C1.2, C2.2, LED0.3-GND (GND), LED1.3-GND (GND); also elsewhere on the board
VCC: C1.1, C2.1, LED0.1-VDD (VDD), LED1.1-VDD (VDD); also elsewhere on the board
WS_OUT: LED0.2-DOUT (DO), LED1.4-DIN (DI)

Notes on the sheet:
HeRo v2.7 VeRLab
REV:A

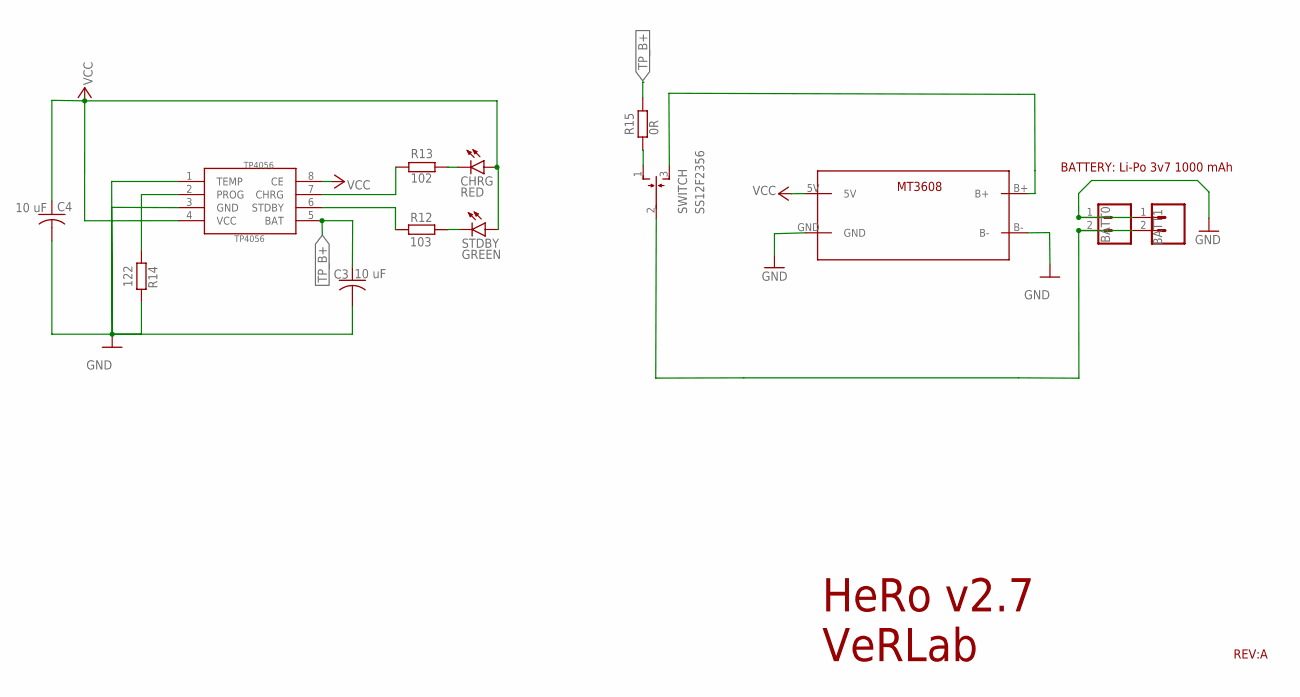
[picture p114: schematic board.sch, sheet 4, <p>Power Supply</p>]

Parts:
BATT0, BATT1: CONN_02JST-PTH-2; JST-2-PTH
C3, C4: 10 uF; C0603
CHRG: RED; SML0805
MT3608: MT3608
R12: 103; R0805
R13: 102; R0805
R14: 122; R0603
R15: 0R; R0805
STDBY: GREEN; SML0805
SWITCH: SS12F2356; HH3T90
TP4056: TP4056; SOP-8

Connections:
B+: MT3608.B+, SWITCH.3 (S)
CHRG: R13.1, TP4056.7 (CHRG)
GND: BATT0.1, BATT1.1, C3.2, C4.2, MT3608.B-, MT3608.GND, R14.1, TP4056.1 (TEMP), TP4056.3 (GND); also elsewhere on the board
unnamed: BATT0.2, BATT1.2, SWITCH.2
unnamed: CHRG.C, R13.2
unnamed: R12.2, STDBY.C
PROG: R14.2, TP4056.2 (PROG)
STDBY: R12.1, TP4056.6 (STDBY)
TP_B+: C3.1, R15.2, TP4056.5 (BAT)
TP_BS: R15.1, SWITCH.1 (O)
VCC: C4.1, CHRG.A, MT3608.5V, STDBY.A, TP4056.4 (VCC), TP4056.8 (CE); also elsewhere on the board

Notes on the sheet:
HeRo v2.7 VeRLab
BATTERY: Li-Po 3v7 1000 mAh
REV:A

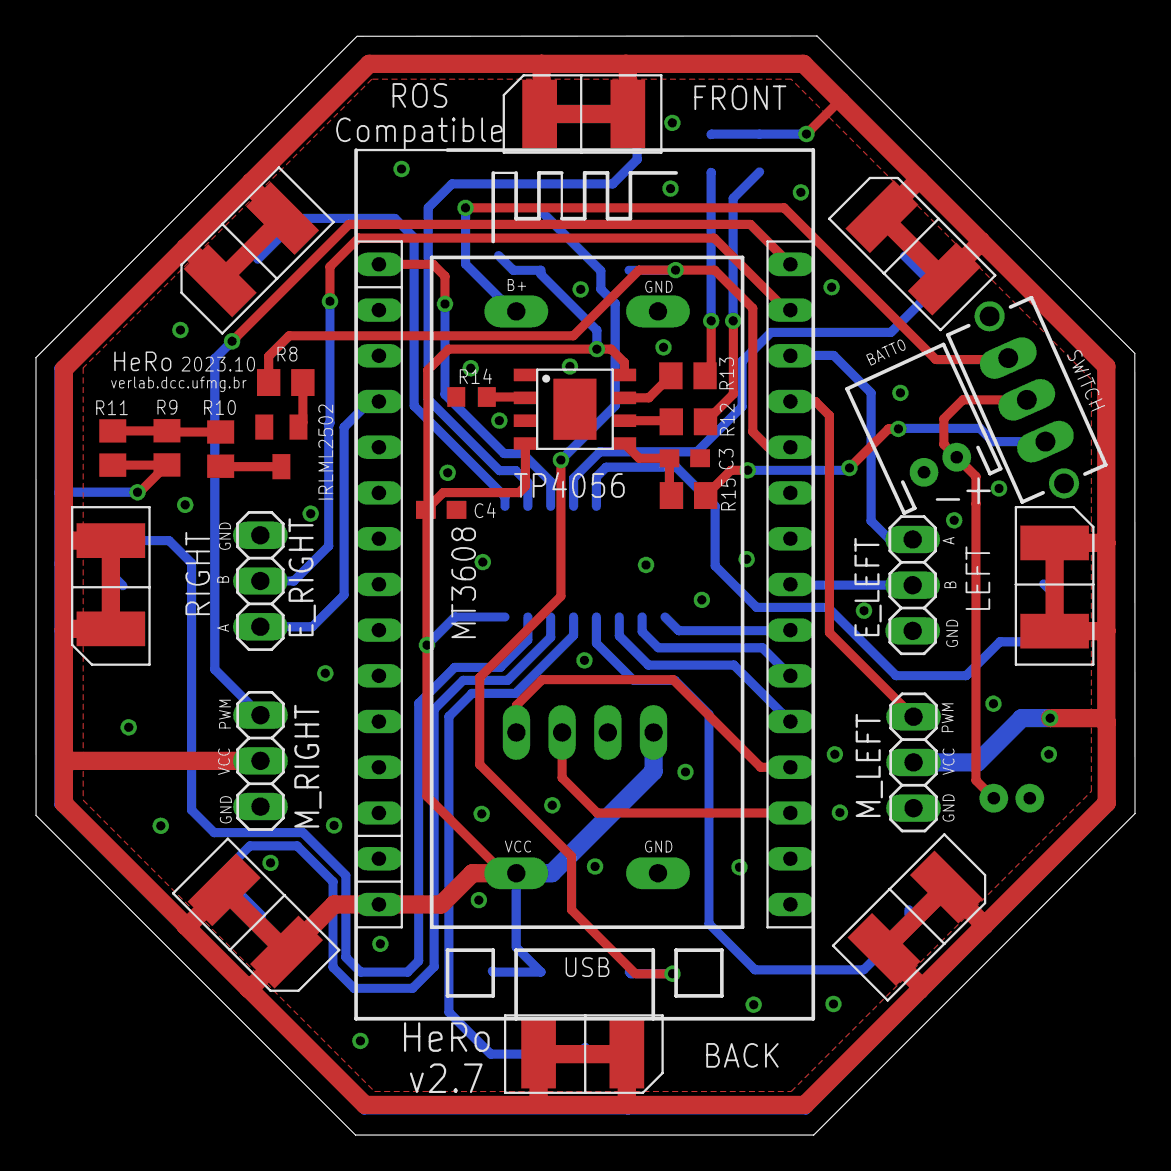
[picture p115: board board.brd from above]

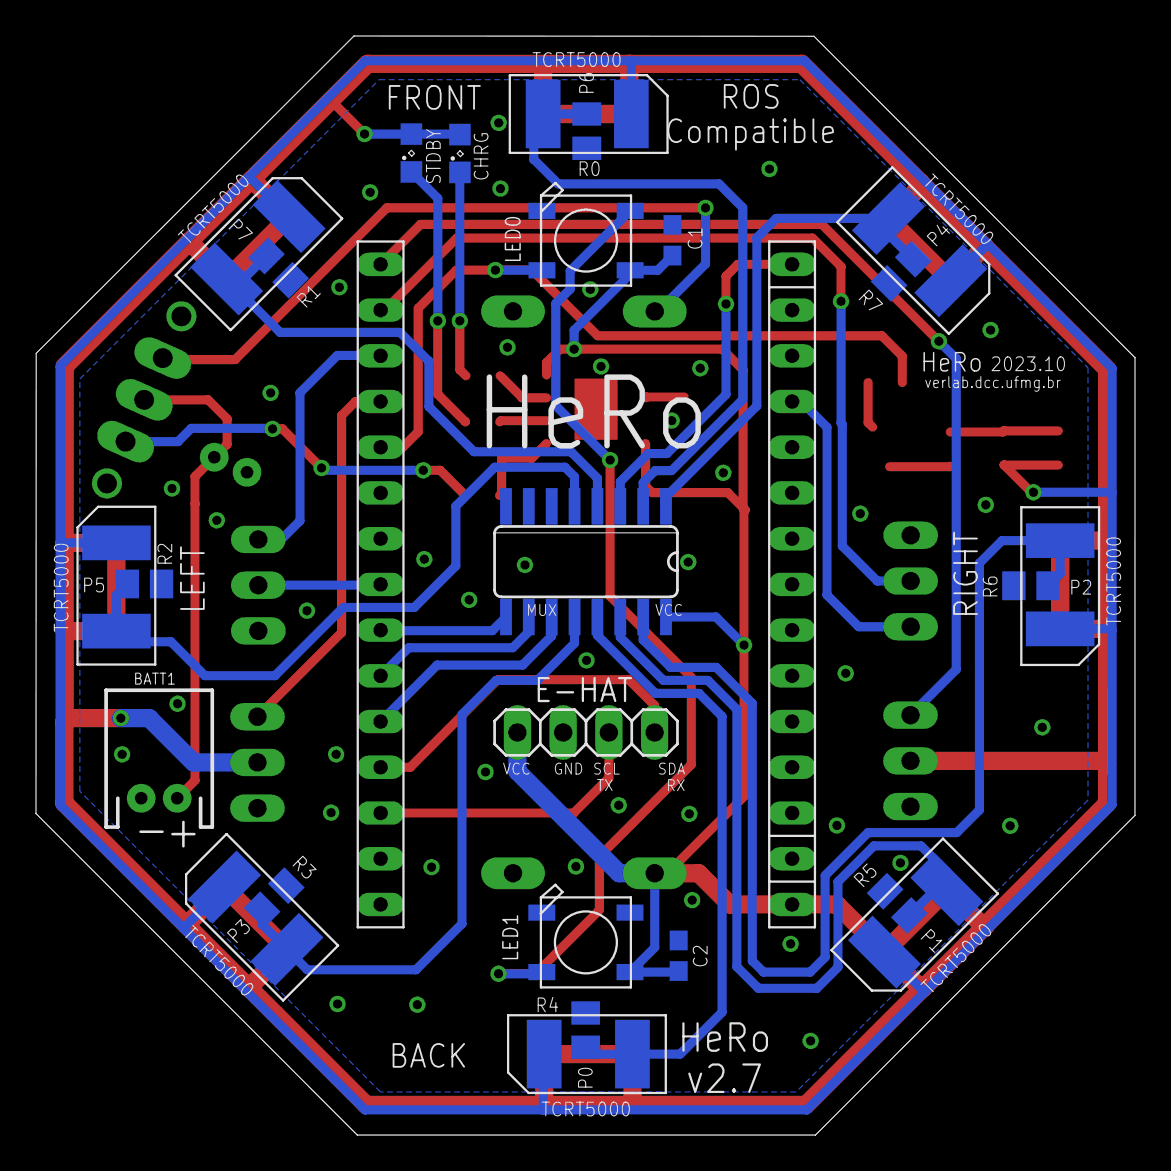
[picture p116: board board.brd from below]

Board: 2 copper layers, 61.1 x 61.1 mm, 45 parts (25 on the bottom side), 37 nets.
