Arttech3d/Hormiga/Códigos/Codigo_ESP32S3/Autonomo_ESP32S3/Autonomo_ESP32S3.ino

// Código ESP32-s3
#include <ESP32Servo.h>

/************************************************************************
 * CONFIGURACIÓN DEL MULTIPLEXOR Y SENSORES
 ************************************************************************/
#define MUX_A_PIN 21  // GPIO21
#define MUX_B_PIN 47  // GPIO47
#define MUX_C_PIN 45  // GPIO45
#define MUX_EN_PIN 48  // GPIO48
#define SENSOR_COUNT 8
#define A0 7           /* ADC ESP32-S3 */

const int real_pos[8] = {0,1,2,7,3,6,4,5};
float sensor_readings[SENSOR_COUNT];

#define PROXIMITY_THRESH 40  // Umbral de detección

/************************************************************************
 * CONFIGURACIÓN DE LOS MOTORES
 ************************************************************************/
#define WHEEL_R_PIN 1     // GPIO1
#define WHEEL_L_PIN 41    // GPIO41
#define WHEEL_R_MID 1590
#define WHEEL_L_MID 1590

// Variables de velocidad individual
int VELDR = 220;  // Velocidad motor derecho
int VELIZ = 100;  // Velocidad motor izquierdo

Servo wheel_right, wheel_left;

/************************************************************************
 * FUNCIONES DEL MULTIPLEXOR Y SENSORES
 ************************************************************************/
void selectInput(int input) {
  digitalWrite(MUX_A_PIN, input & 0x01);
  digitalWrite(MUX_B_PIN, (input >> 1) & 0x01);
  digitalWrite(MUX_C_PIN, (input >> 2) & 0x01);
}

float readSensor() {
  delayMicroseconds(500);
  float env = (float)analogRead(A0);
  analogWrite(MUX_EN_PIN, 1023);
  delayMicroseconds(100);
  float sensor_reading = (float)analogRead(A0) - env;
  analogWrite(MUX_EN_PIN, 0);
  if (sensor_reading < 0) sensor_reading = 1;
  return sensor_reading;
}

void readSensors() {
  Serial.println("\nLeyendo sensores...");
  for (int i = 0; i < SENSOR_COUNT; i++) {
    selectInput(i);
    sensor_readings[real_pos[i]] = readSensor();
    Serial.print("Sensor ");
    Serial.print(i);
    Serial.print(": ");
    Serial.println(sensor_readings[real_pos[i]]);
  }
}

/************************************************************************
 * CONTROL DE MOVIMIENTO AUTÓNOMO
 ************************************************************************/
void updateVelocities() {
  bool obst_front   = sensor_readings[0] >= PROXIMITY_THRESH;
  bool obst_fleft   = sensor_readings[1] >= PROXIMITY_THRESH;
  bool obst_left    = sensor_readings[2] >= PROXIMITY_THRESH;
  bool obst_bleft   = sensor_readings[3] >= PROXIMITY_THRESH;
  bool obst_back    = sensor_readings[4] >= PROXIMITY_THRESH;
  bool obst_bright  = sensor_readings[5] >= PROXIMITY_THRESH;
  bool obst_right   = sensor_readings[6] >= PROXIMITY_THRESH;
  bool obst_fright  = sensor_readings[7] >= PROXIMITY_THRESH;

  Serial.println("\n--- Análisis de obstáculos ---");
  if (obst_front || obst_fright || obst_fleft) {
    Serial.println("Obstáculo detectado al frente. Girando...");
    float sum_left  = sensor_readings[1] + sensor_readings[2] + sensor_readings[3];
    float sum_right = sensor_readings[7] + sensor_readings[6] + sensor_readings[5];

    if (sum_left < sum_right) {
      Serial.println("Giro a la izquierda.");
      wheel_right.writeMicroseconds(WHEEL_R_MID + VELDR);
      wheel_left.writeMicroseconds(WHEEL_L_MID + VELIZ);
    } else {
      Serial.println("Giro a la derecha.");
      wheel_right.writeMicroseconds(WHEEL_R_MID - VELDR);
      wheel_left.writeMicroseconds(WHEEL_L_MID - VELIZ);
    }
  }
  else if (obst_left || obst_bleft) {
    Serial.println("Obstáculo a la izquierda. Girando a la derecha...");
    wheel_right.writeMicroseconds(WHEEL_R_MID - VELDR);
    wheel_left.writeMicroseconds(WHEEL_L_MID - VELIZ);
  }
  else if (obst_right || obst_bright) {
    Serial.println("Obstáculo a la derecha. Girando a la izquierda...");
    wheel_right.writeMicroseconds(WHEEL_R_MID + VELDR);
    wheel_left.writeMicroseconds(WHEEL_L_MID + VELIZ);
  }
  else if (obst_back) {
    Serial.println("Obstáculo detrás. Avanzando hacia adelante...");
    wheel_right.writeMicroseconds(WHEEL_R_MID - VELDR - 50);
    wheel_left.writeMicroseconds(WHEEL_L_MID + VELIZ + 50);
  }
  else {
    Serial.println("Sin obstáculos. Avanzando hacia adelante...");
    wheel_right.writeMicroseconds(WHEEL_R_MID - VELDR);
    wheel_left.writeMicroseconds(WHEEL_L_MID + VELIZ);
  }
}

/************************************************************************
 * SETUP
 ************************************************************************/
void setup() {
  pinMode(MUX_A_PIN, OUTPUT);
  pinMode(MUX_B_PIN, OUTPUT);
  pinMode(MUX_C_PIN, OUTPUT);
  pinMode(MUX_EN_PIN, OUTPUT);
  analogWrite(MUX_EN_PIN, 0);

  wheel_right.attach(WHEEL_R_PIN);
  wheel_left.attach(WHEEL_L_PIN);
  wheel_right.writeMicroseconds(WHEEL_R_MID);
  wheel_left.writeMicroseconds(WHEEL_L_MID);

  Serial.begin(115200);
  Serial.println("=======================================");
  Serial.println("   Robot autónomo iniciado correctamente");
  Serial.println("   Escaneando entorno y ajustando ruta...");
  Serial.println("=======================================");
  Serial.println("Usa VELDR y VELIZ para ajustar la velocidad individual de los motores.\n");
}

/************************************************************************
 * LOOP PRINCIPAL
 ************************************************************************/
void loop() {
  Serial.println("\n--------------------------------------");
  Serial.println("Lectura de sensores y control de movimiento");
  Serial.println("--------------------------------------");
  readSensors();
  updateVelocities();
  delay(500);
}
