Arttech3d/Hormiga/(commit log)

2025-12-08 nuevo repositorio
    [PnP_board_back.csv, PnP_board_front.csv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]
2025-12-09 Actualizando documentos
    [board-B_Cu.gbr, board-B_Mask.gbr, board-B_Paste.gbr, board-B_Silkscreen.gbr, board-Edge_Cuts.gbr, board-F_Cu.gbr, board-F_Mask.gbr, board-F_Paste.gbr]
2025-12-14 Actualización de archivos
2025-12-20 Descripción de los cambios
    [Chassis_a.stl, Chassis_b.stl, DISEÑO DE PLACA ESP32-S3.kicad_pcb, DISEÑO DE PLACA ESP32-S3.kicad_sch, DRON.kicad_pcb, DRON.kicad_sch, Lista de materiales.xlsx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]
2026-01-14 Mensaje describiendo tus cambios
    [DRON.kicad_pcb, DRON.kicad_sch, Lista de materiales.xlsx, MicroMod-Datalogging-CarrierBoard.kicad_pcb, MicroMod-Datalogging-CarrierBoard.kicad_sch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]
