Arttech3d/Hormiga/(notices)

Notices in the files:
KiCad/Tarjetas/SparkFun-Artemis/MicroMod-Datalogging-CarrierBoard.kicad_sch:
Released under the Creative Commons
https://creativecommons.org/licenses/by-sa/4.0
parts and their libraries:
SparkFun-Connectors: Licensing: Creative Commons ShareAlike 4.0 International - https://creativecommons.org/licenses/by-sa/4.0
